maciekish/warthogathome/Checklists/A-10C_and_A-10C_II_Kneeboard_Suite_06-September-2022/A-10C_2/00_A-10C_KS_Day_04_TK.png

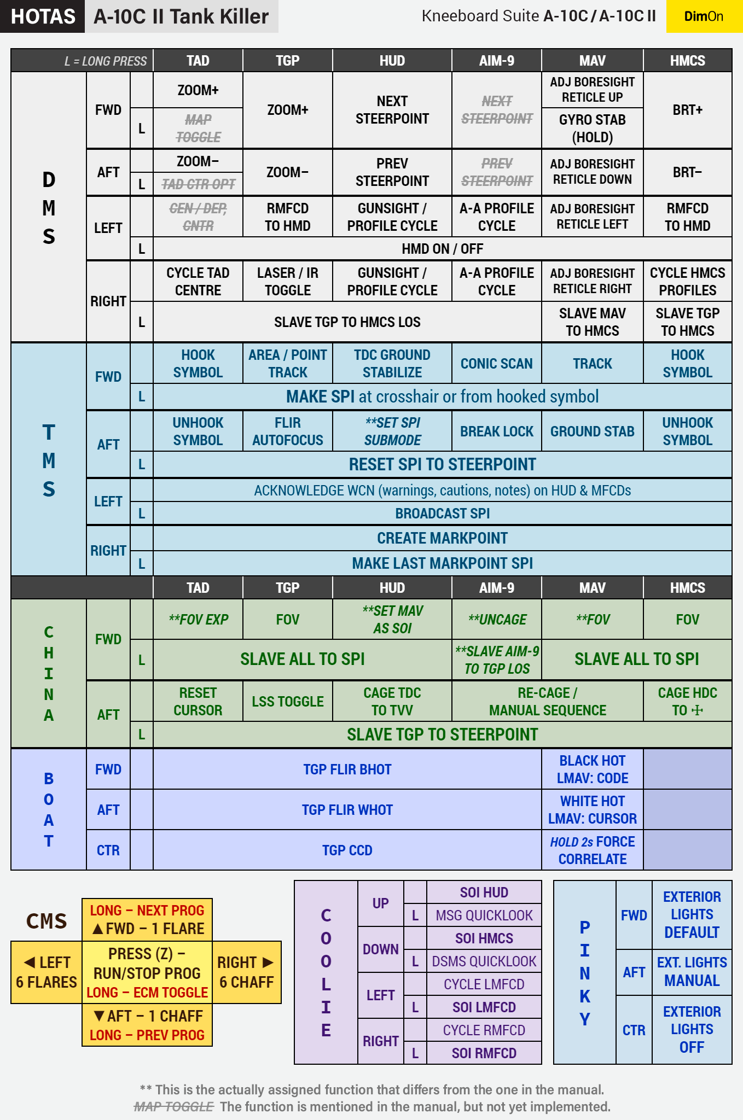
Checklists/A-10C_and_A-10C_II_Kneeboard_Suite_06-September-2022/A-10C_2/00_A-10C_KS_Day_04_TK.png
