maciekish/warthogathome/Panels/A-10C Cockpit Layout.jpeg

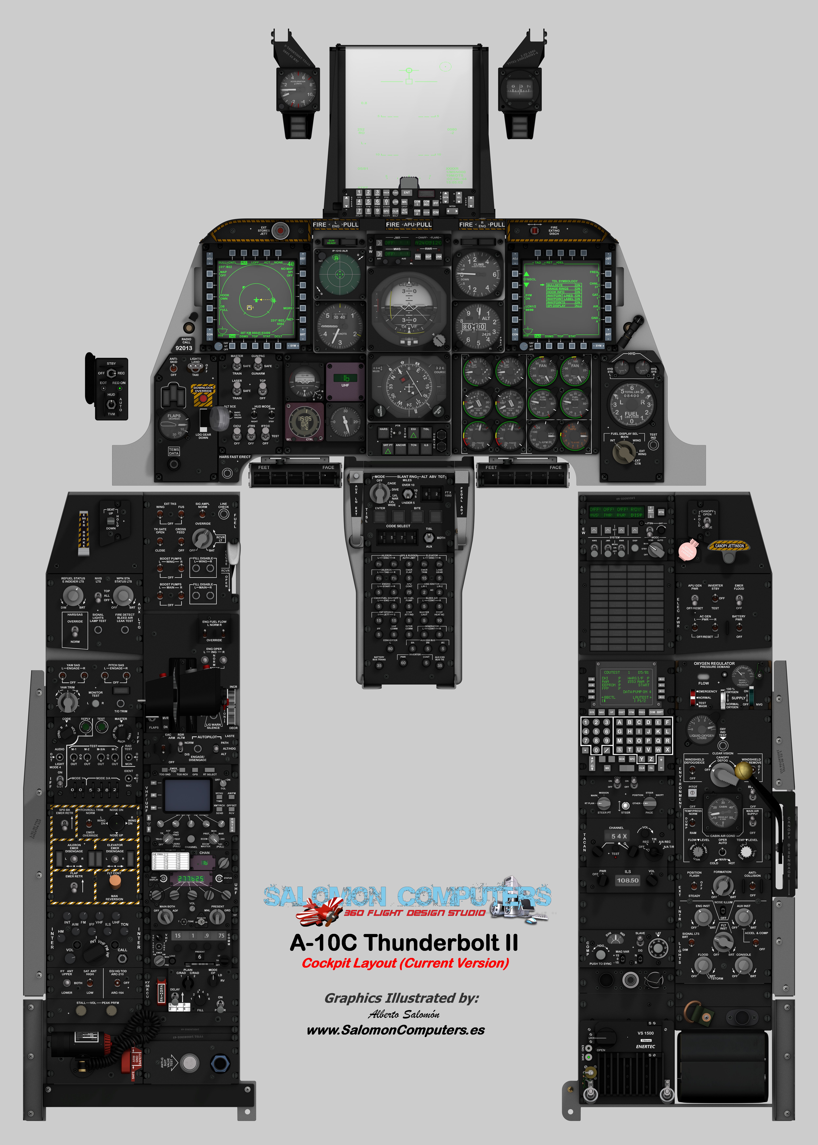
Panels/A-10C Cockpit Layout.jpeg
