maciekish/warthogathome/PCBs/Misc/Hub/production/bom.csv

Designator | Footprint | Quantity | Value | LCSC Part #
J2 | Molex Micro-Fit 3.0 43045-0800 | 1 | Conn_02x04_Top_Bottom | C122422
RJ1 | RJ45-TH_DS1130-S80BP | 1 | DS1130-S80BP | C86585
D1 | LED_0603_1608Metric | 1 | BLUE | C72041
R1 | R_0603_1608Metric | 1 | 4.7K | C23162
J1 | Molex Micro-Fit 3.0 43045-0800 | 1 | Conn_02x04_Top_Bottom | C122422
