maciekish/warthogathome/PCBs/Misc/External Connectors/production/bom.csv

Designator | Footprint | Quantity | Value | LCSC Part #
J4 | USB-A-TH_USB-302-T | 1 | USB_A | C86461
J3 | USB-B-TH_67068-8000 | 1 | USB_B | C114097
J1 | Molex Micro-Fit 3.0 43045-0800 | 1 | Conn_02x04_Top_Bottom | C234189
J2 | Molex Micro-Fit 3.0 43045-0800 | 1 | Conn_02x04_Top_Bottom | C234189
