maciekish/warthogathome/PCBs/Panels/Caution Panel/production/bom.csv

Designator | Footprint | Quantity | Value | LCSC Part #
D91 | LED_2010_5025Metric_Pad1.52x2.65mm_HandSolder | 1 | GREEN
D94 | LED_2010_5025Metric_Pad1.52x2.65mm_HandSolder | 1 | GREEN
D40 | LED_2010_5025Metric_Pad1.52x2.65mm_HandSolder | 1 | GREEN
D22 | LED_2010_5025Metric_Pad1.52x2.65mm_HandSolder | 1 | GREEN
D83 | LED_2010_5025Metric_Pad1.52x2.65mm_HandSolder | 1 | GREEN
D77 | LED_2010_5025Metric_Pad1.52x2.65mm_HandSolder | 1 | GREEN
R1 | R_1210_3225Metric_Pad1.30x2.65mm_HandSolder | 1 | 2K
H2 | MountingHole_2.2mm_M2_Pad | 1 | GND
D86 | LED_2010_5025Metric_Pad1.52x2.65mm_HandSolder | 1 | GREEN
D95 | LED_2010_5025Metric_Pad1.52x2.65mm_HandSolder | 1 | GREEN
D37 | LED_2010_5025Metric_Pad1.52x2.65mm_HandSolder | 1 | GREEN
D75 | LED_2010_5025Metric_Pad1.52x2.65mm_HandSolder | 1 | GREEN
D78 | LED_2010_5025Metric_Pad1.52x2.65mm_HandSolder | 1 | GREEN
D12 | LED_2010_5025Metric_Pad1.52x2.65mm_HandSolder | 1 | GREEN
D65 | LED_2010_5025Metric_Pad1.52x2.65mm_HandSolder | 1 | GREEN
D67 | LED_2010_5025Metric_Pad1.52x2.65mm_HandSolder | 1 | GREEN
D68 | LED_2010_5025Metric_Pad1.52x2.65mm_HandSolder | 1 | GREEN
D6 | LED_2010_5025Metric_Pad1.52x2.65mm_HandSolder | 1 | GREEN
D72 | LED_2010_5025Metric_Pad1.52x2.65mm_HandSolder | 1 | GREEN
D17 | LED_2010_5025Metric_Pad1.52x2.65mm_HandSolder | 1 | GREEN
D23 | LED_2010_5025Metric_Pad1.52x2.65mm_HandSolder | 1 | GREEN
D51 | LED_2010_5025Metric_Pad1.52x2.65mm_HandSolder | 1 | GREEN
D89 | LED_2010_5025Metric_Pad1.52x2.65mm_HandSolder | 1 | GREEN
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
D60 | LED_2010_5025Metric_Pad1.52x2.65mm_HandSolder | 1 | GREEN
D64 | LED_2010_5025Metric_Pad1.52x2.65mm_HandSolder | 1 | GREEN
D28 | LED_2010_5025Metric_Pad1.52x2.65mm_HandSolder | 1 | GREEN
D87 | LED_2010_5025Metric_Pad1.52x2.65mm_HandSolder | 1 | GREEN
D39 | LED_2010_5025Metric_Pad1.52x2.65mm_HandSolder | 1 | GREEN
D88 | LED_2010_5025Metric_Pad1.52x2.65mm_HandSolder | 1 | GREEN
D33 | LED_2010_5025Metric_Pad1.52x2.65mm_HandSolder | 1 | GREEN
D96 | LED_2010_5025Metric_Pad1.52x2.65mm_HandSolder | 1 | GREEN
D85 | LED_2010_5025Metric_Pad1.52x2.65mm_HandSolder | 1 | GREEN
D82 | LED_2010_5025Metric_Pad1.52x2.65mm_HandSolder | 1 | GREEN
D93 | LED_2010_5025Metric_Pad1.52x2.65mm_HandSolder | 1 | GREEN
D53 | LED_2010_5025Metric_Pad1.52x2.65mm_HandSolder | 1 | GREEN
D52 | LED_2010_5025Metric_Pad1.52x2.65mm_HandSolder | 1 | GREEN
D66 | LED_2010_5025Metric_Pad1.52x2.65mm_HandSolder | 1 | GREEN
U2 | DIP-28_W7.62mm | 1 | TLC5940NT
U1 | DIP-28_W7.62mm | 1 | TLC5940NT
U3 | DIP-28_W7.62mm | 1 | TLC5940NT
C3 | C_0805_2012Metric_Pad1.18x1.45mm_HandSolder | 1 | 100N
J1 | PinHeader_1x06_P2.54mm_Vertical | 1 | Conn_01x06_Male
C1 | C_0805_2012Metric_Pad1.18x1.45mm_HandSolder | 1 | 100N
C2 | C_0805_2012Metric_Pad1.18x1.45mm_HandSolder | 1 | 100N
