maciekish/warthogathome/KiCad Libraries/3D/Cap MLCC FA14X7R1H225KRU06.stp

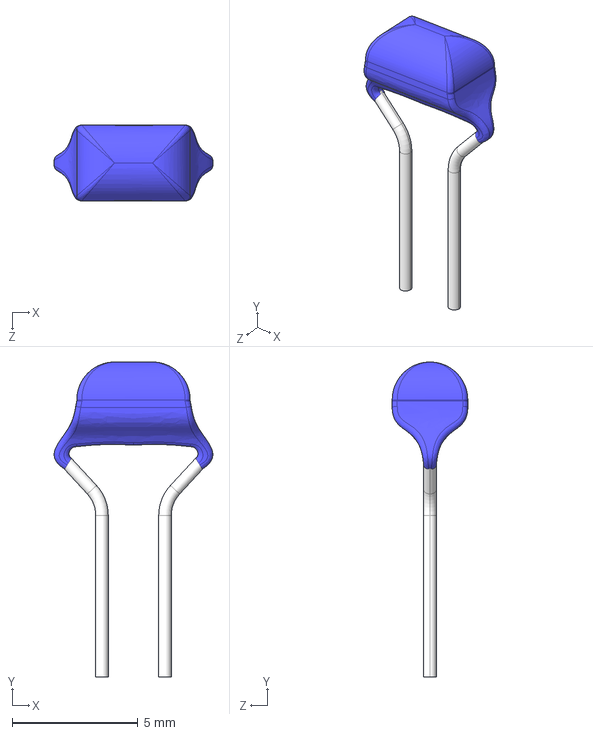
[picture p20: CAD file, 2022-08-09]
KiCad Libraries/3D/Cap MLCC FA14X7R1H225KRU06.stp
6.30 x 12.5 x 3.00 mm
