maciekish/warthogathome/KiCad Libraries/B6B-XH-A-LF--SN---3DModel-STEP-418109.STEP

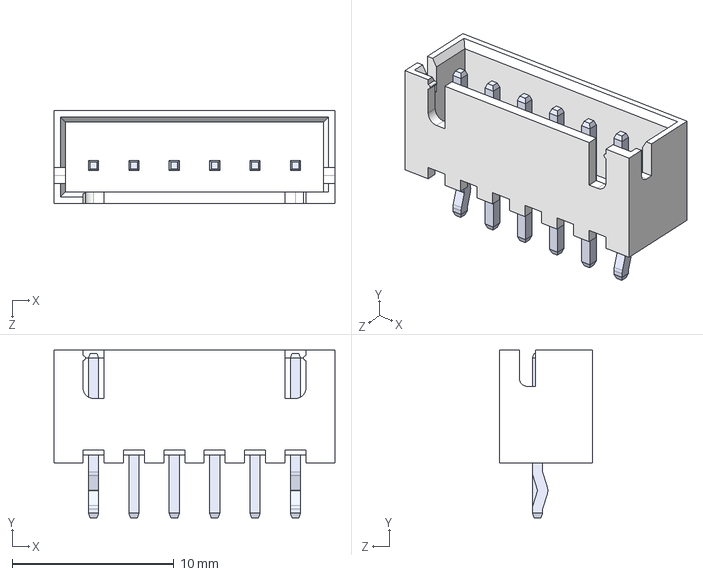
[picture p21: CAD file, 2022-08-08]
KiCad Libraries/B6B-XH-A-LF--SN---3DModel-STEP-418109.STEP
17.4 x 10.4 x 5.75 mm
