maciekish/warthogathome/Panels/Modified for LED Strip/Right Console/ELEC PWR.dxf

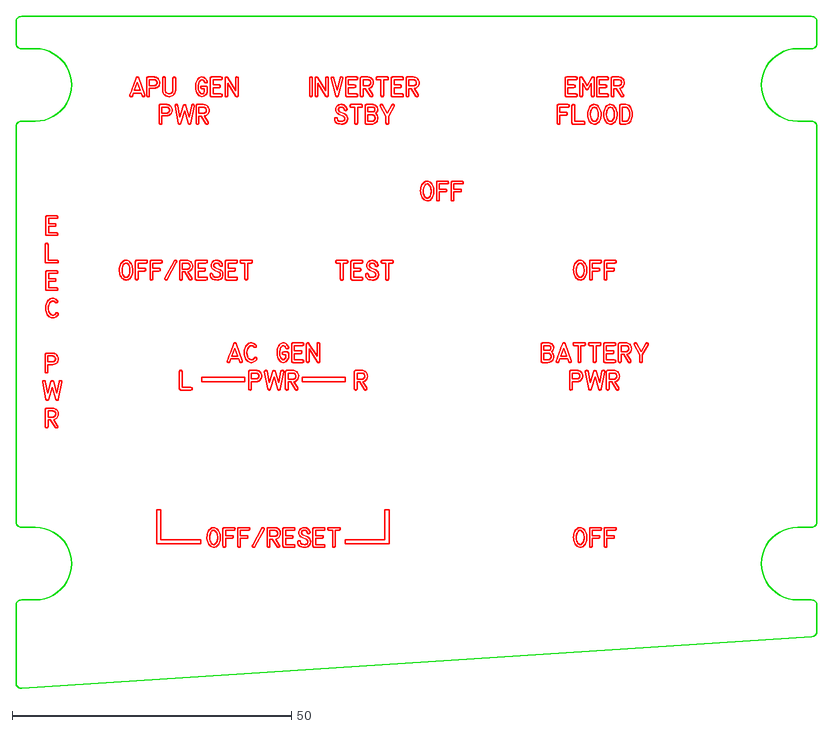
[picture p22: CAD file, 2022-08-17]
Panels/Modified for LED Strip/Right Console/ELEC PWR.dxf
143.5 x 120.4
