maciekish/warthogathome/KiCad Libraries/3D/BK-6013.step

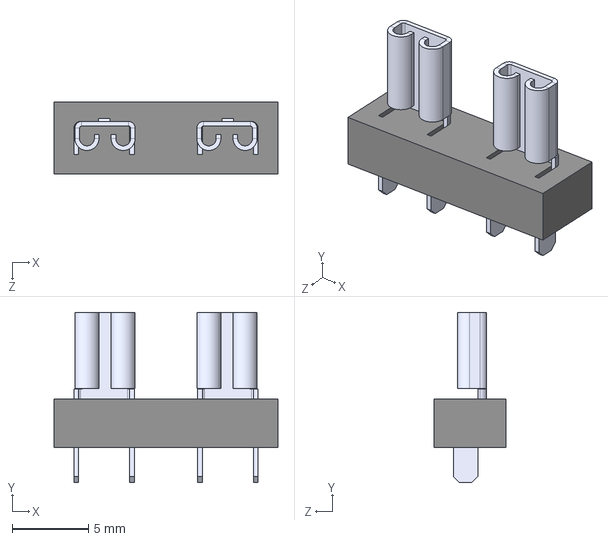
[picture p23: CAD file, 2022-08-09]
KiCad Libraries/3D/BK-6013.step
14.7 x 11.2 x 4.75 mm
