maciekish/warthogathome/KiCad Libraries/3D/L7805CV.stp

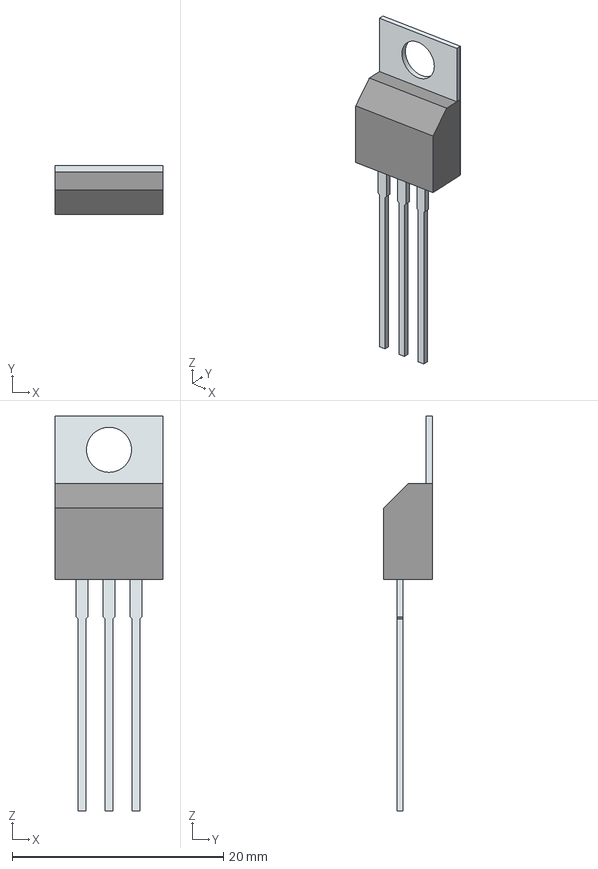
[picture p24: CAD file, 2022-08-08]
KiCad Libraries/3D/L7805CV.stp
10.2 x 4.60 x 37.4 mm
Tab
PinsArray
