maciekish/warthogathome/KiCad Libraries/3D/B6B-XH-A_LF__SN_.stp

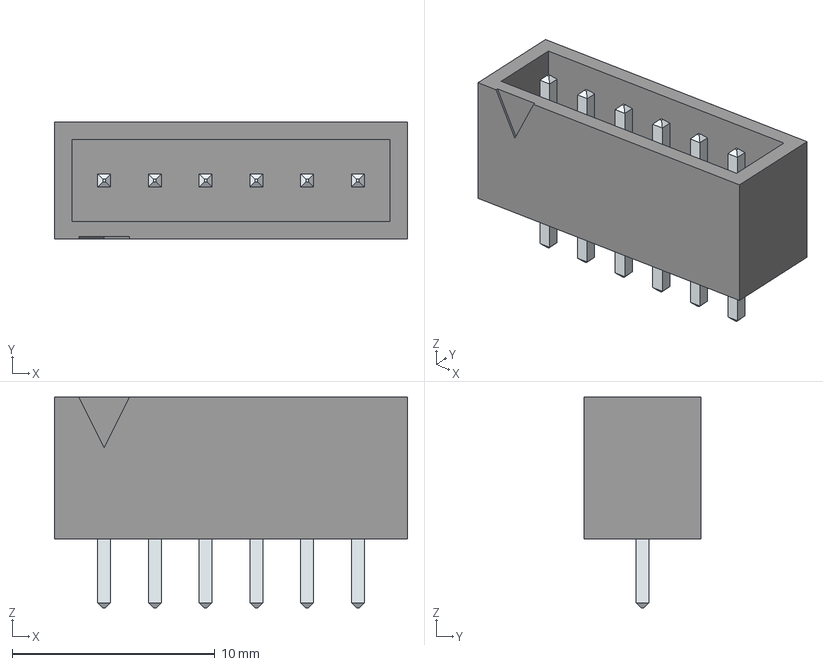
[picture p25: CAD file, 2022-08-08]
KiCad Libraries/3D/B6B-XH-A_LF__SN_.stp
17.4 x 5.75 x 10.4 mm
LeadsArray
