maciekish/warthogathome/KiCad Libraries/3D/B2B-XH-2__LF__SN_.stp

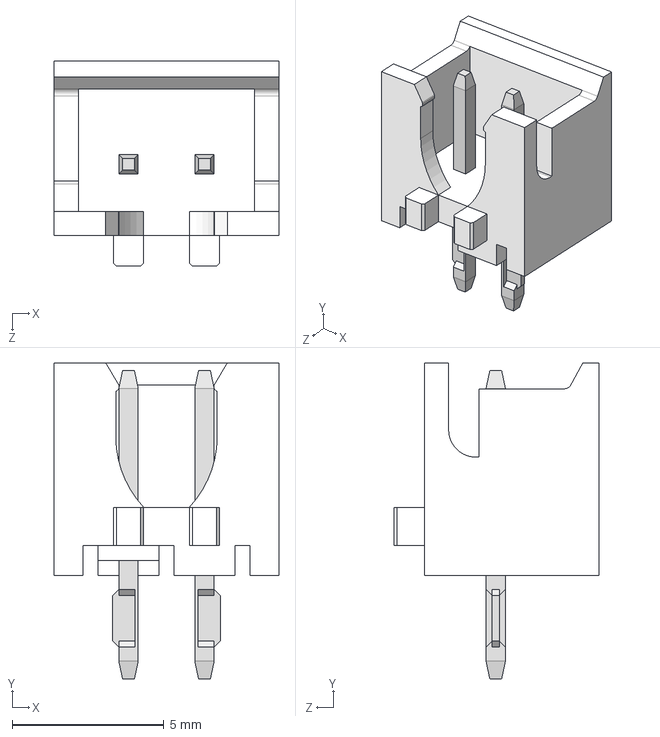
[picture p26: CAD file, 2022-08-08]
KiCad Libraries/3D/B2B-XH-2__LF__SN_.stp
7.40 x 10.4 x 6.75 mm
