maciekish/warthogathome/KiCad Libraries/3D/B7B-XH-A_LF__SN_.stp

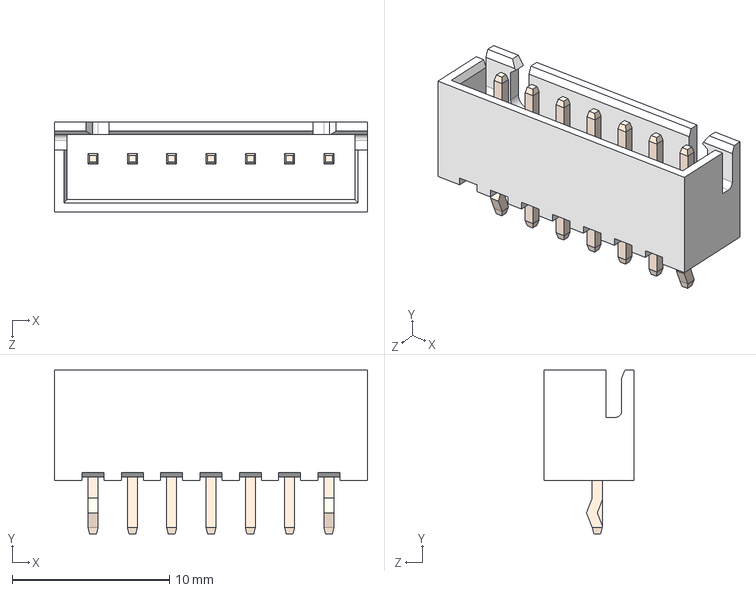
[picture p27: CAD file, 2022-08-08]
KiCad Libraries/3D/B7B-XH-A_LF__SN_.stp
19.9 x 10.4 x 5.75 mm
