maciekish/warthogathome/KiCad Libraries/3D/MAX487CPA+.stp

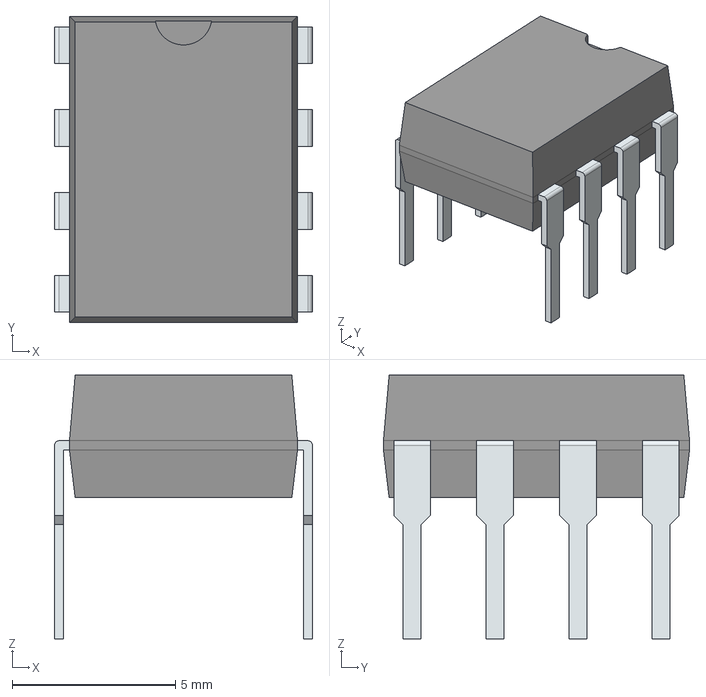
[picture p28: CAD file, 2022-08-08]
KiCad Libraries/3D/MAX487CPA+.stp
7.90 x 9.38 x 8.07 mm
PinsArrayLR
