maciekish/warthogathome/KiCad Libraries/3D/43045-0800.stp

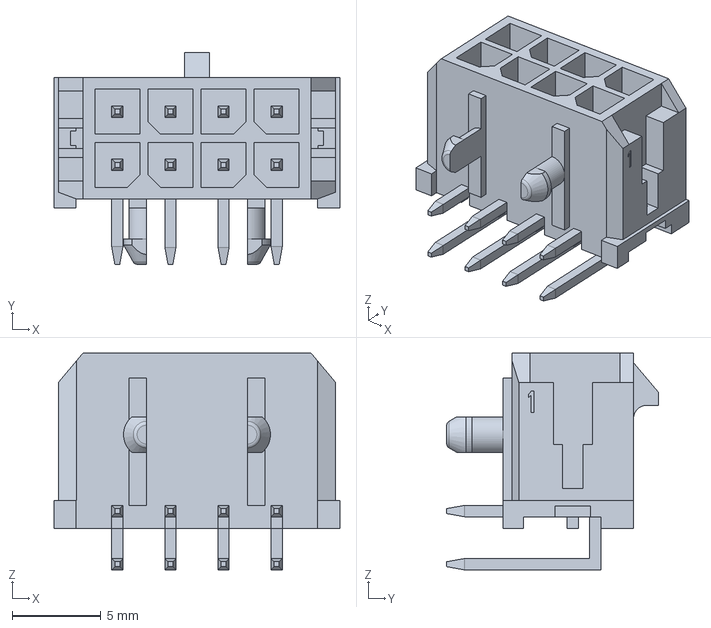
[picture p29: CAD file, 2022-08-08]
KiCad Libraries/3D/43045-0800.stp
16.1 x 11.9 x 12.2 mm
