maciekish/warthogathome/KiCad Libraries/3D/43045-0400.stp

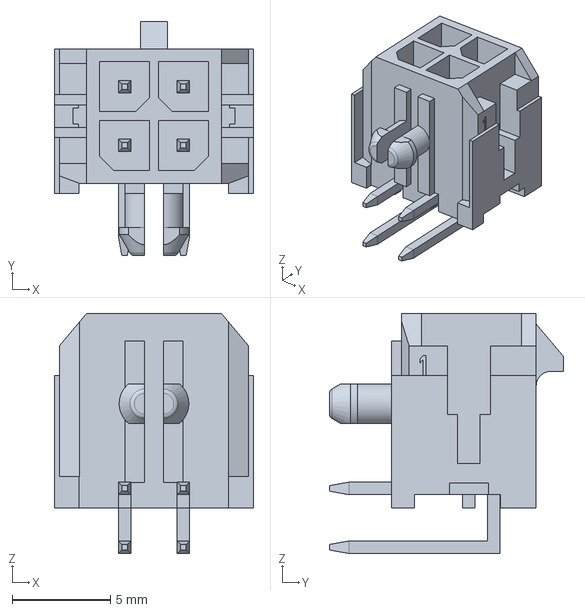
[picture p30: CAD file, 2022-08-08]
KiCad Libraries/3D/43045-0400.stp
10.2 x 11.9 x 12.2 mm
