maciekish/warthogathome/KiCad Libraries/3D/43045-0200.stp

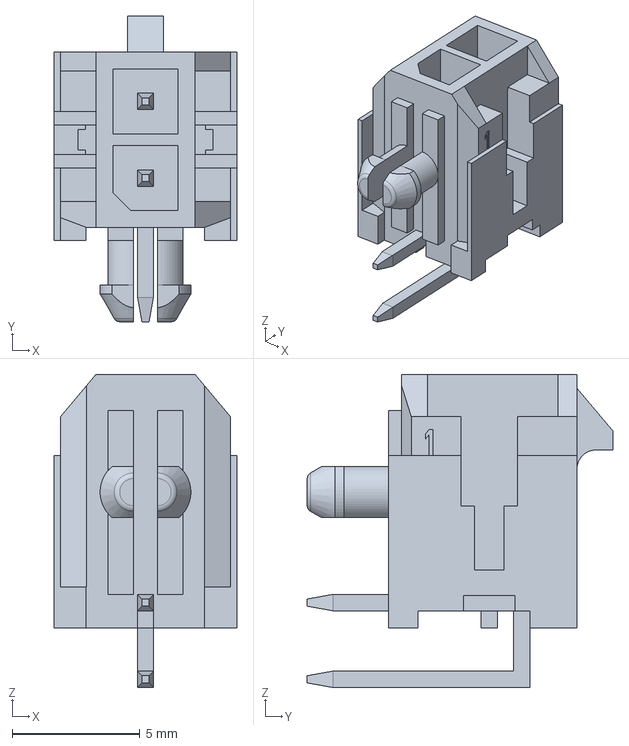
[picture p31: CAD file, 2022-08-08]
KiCad Libraries/3D/43045-0200.stp
7.15 x 11.9 x 12.2 mm
