maciekish/warthogathome/(list of files, cad)

Other CAD files:
Models/Consoles/ATX PSU Frame.FCStd
KiCad Libraries/3D/TIP120.stp
KiCad Libraries/3D/B6B-XH-A_LF__SN_.stl
KiCad Libraries/3D/L7805CV.stl
KiCad Libraries/3D/TIP120.stl
