maciekish/warthogathome/Panels/Panelized/2022-09-22/2022-09-22 - 2.8mm White.pdf

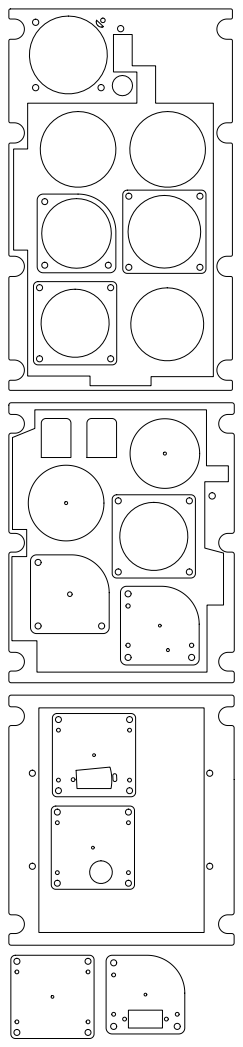
[picture p32: page 1]
