maciekish/warthogathome/Panels/Panelized/2022-09-22/2022-09-22 - 2mm Clear.pdf

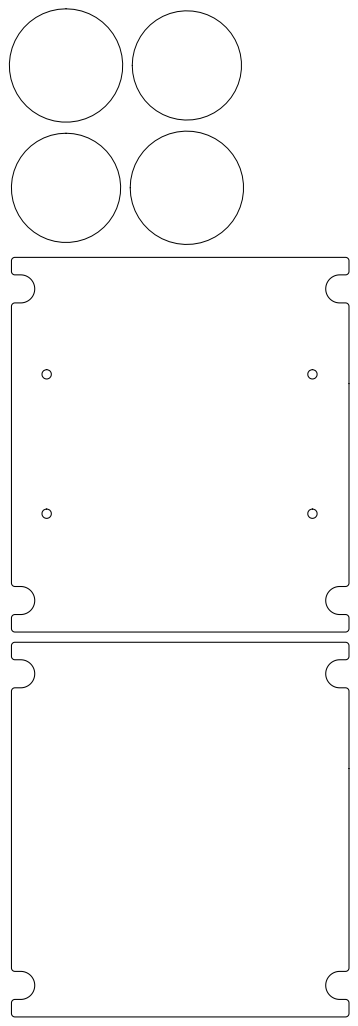
[picture p33: page 1]
