maciekish/warthogathome/Panels/Panelized/2022-09-22/2022-09-22 - 2.8mm Black.pdf

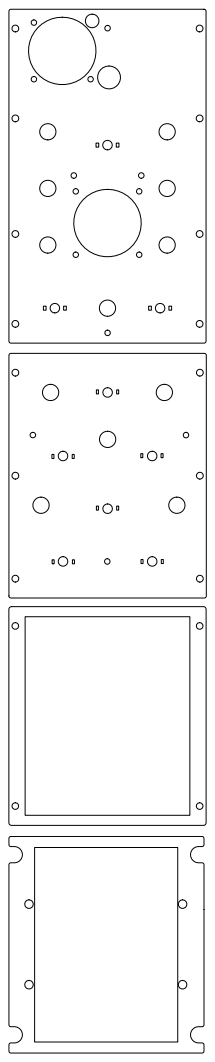
[picture p34: page 1]
