maciekish/warthogathome/Panels/Panelized/2022-09-22/2022-09-22 - 2mm White.pdf

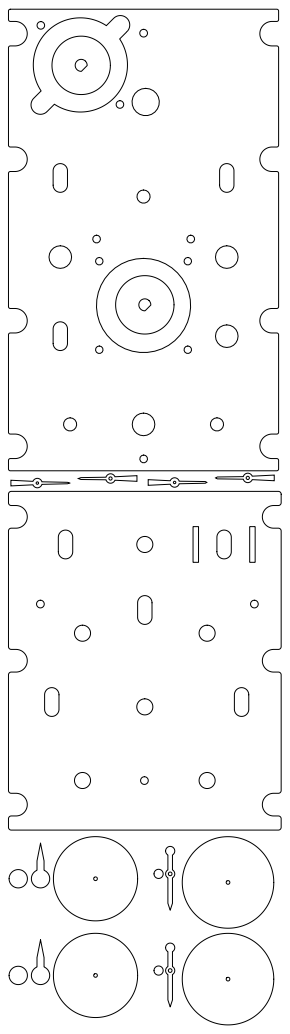
[picture p35: page 1]
