maciekish/warthogathome/Panels/Converted/PDF/AnyConv.com__Environment.pdf

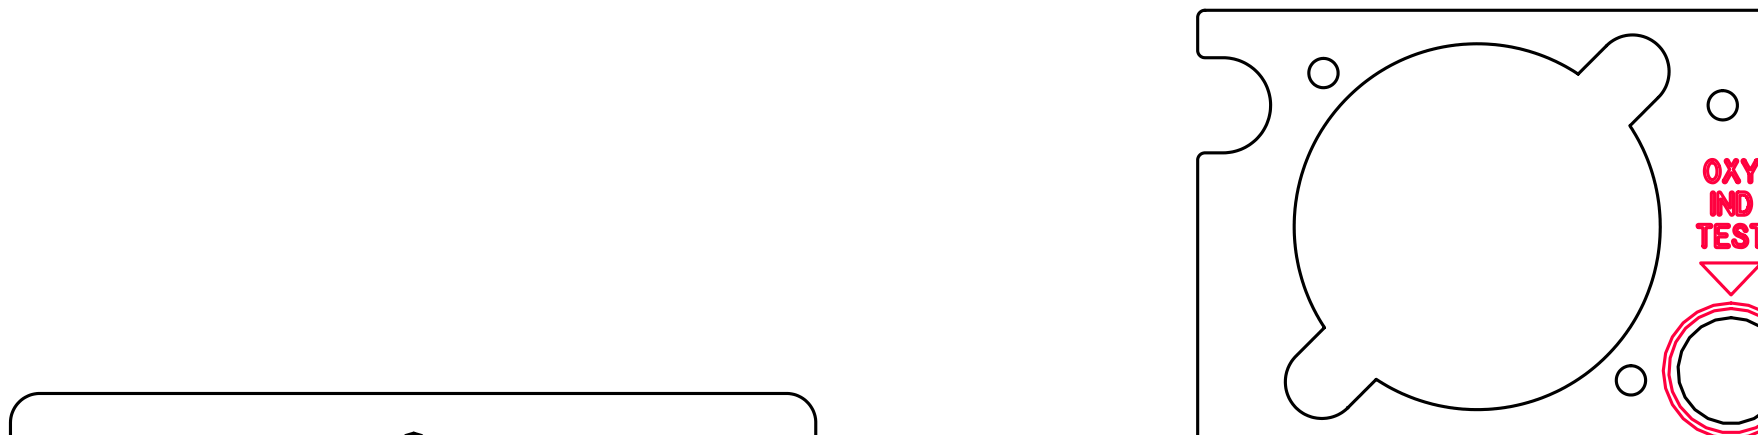
[picture p36: page 1]
