maciekish/warthogathome/Panels/Converted/PDF/AnyConv.com__Lighting Panel.pdf

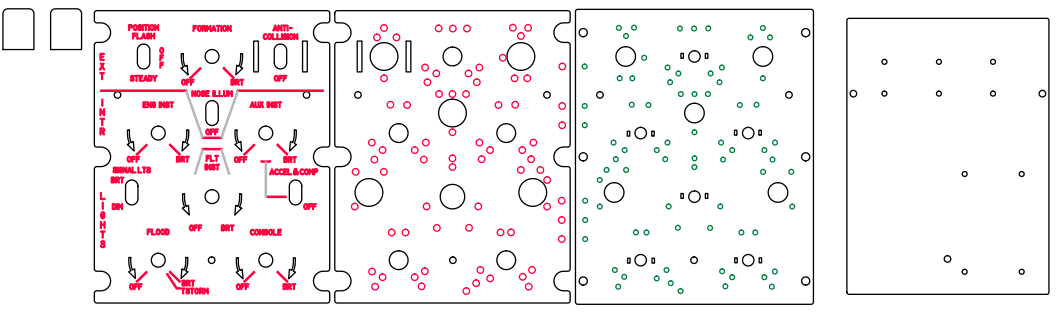
[picture p37: page 1]
