maciekish/warthogathome/Panels/Modified for LED Strip/Right Console/Canopy Panel Lower.pdf

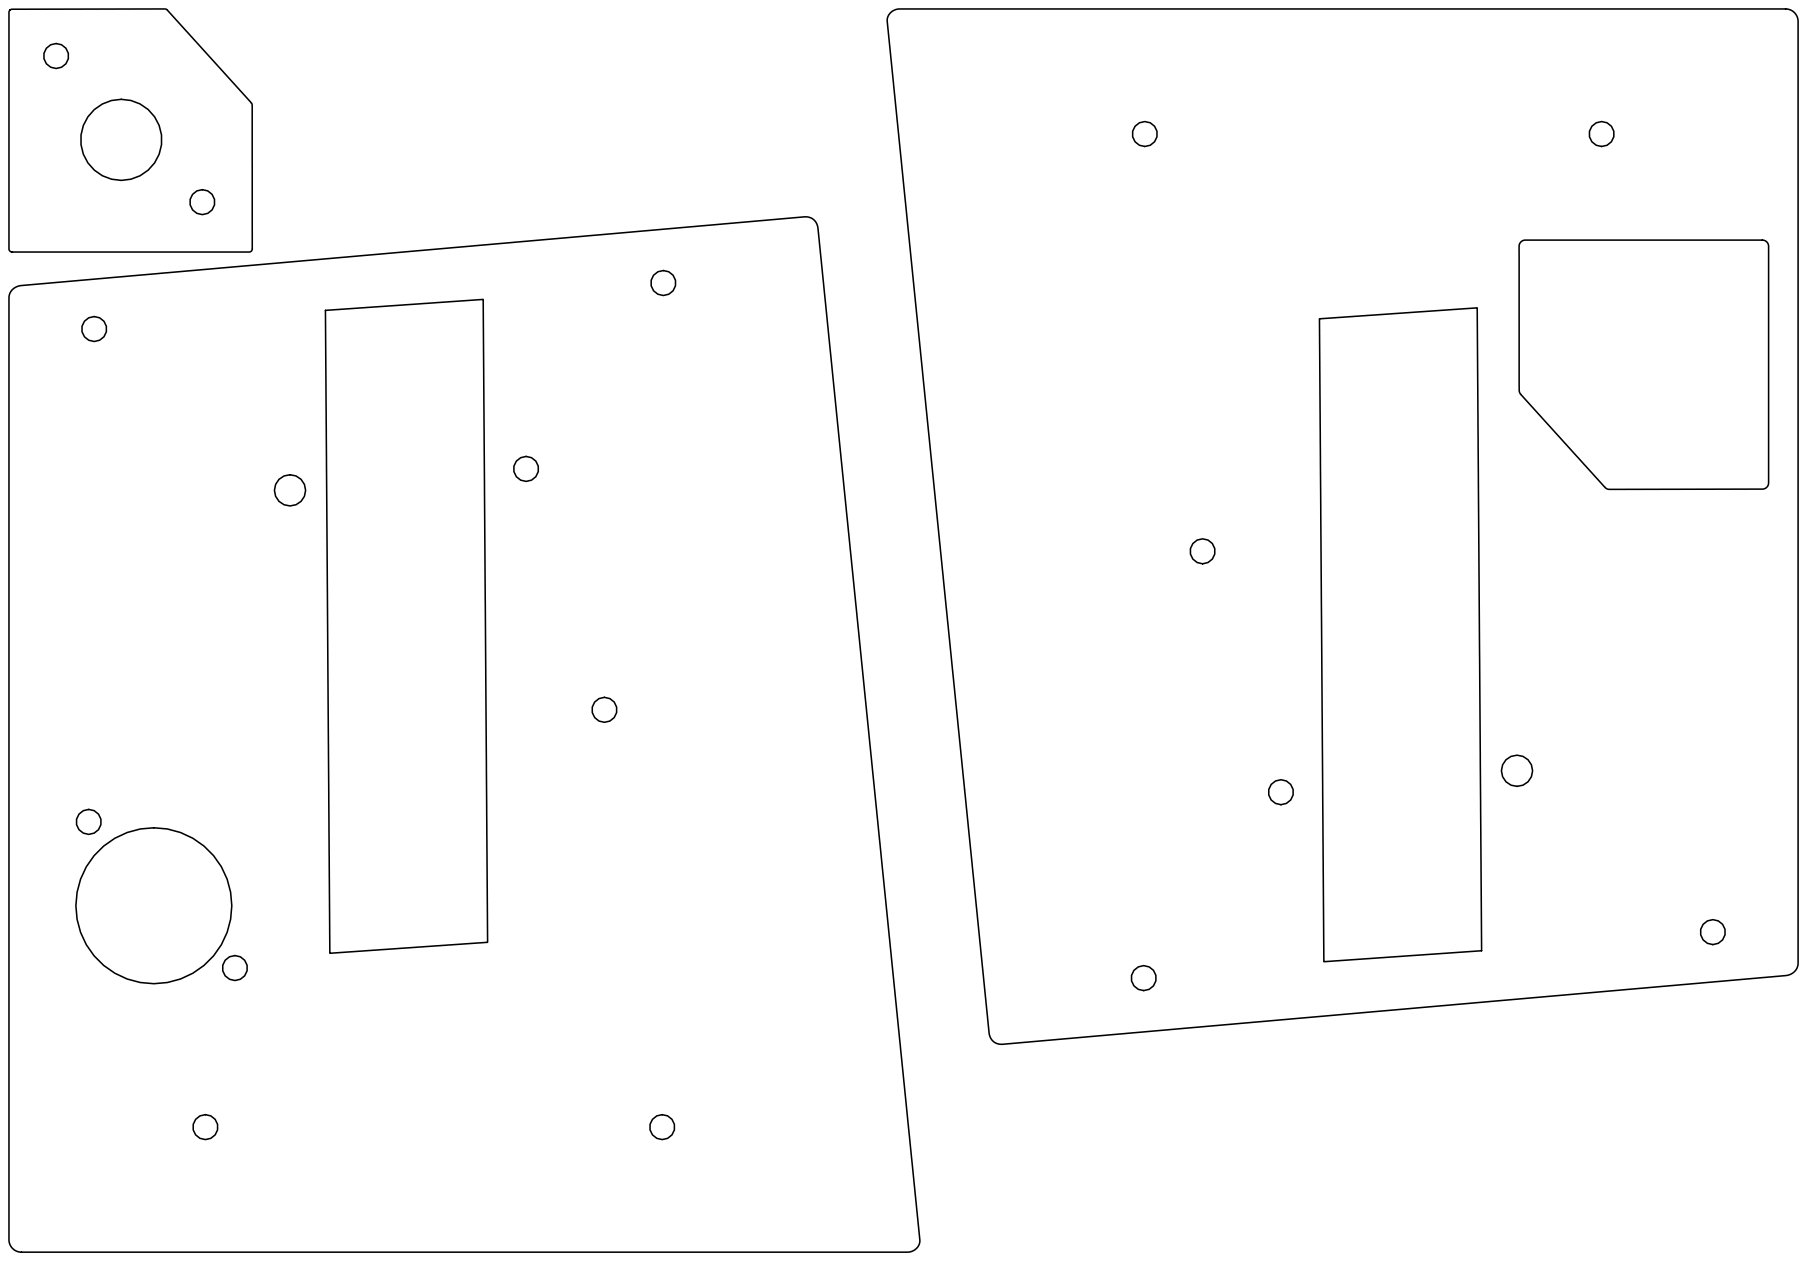
[picture p38: page 1]
