maciekish/warthogathome/Panels/Modified for LED Strip/Right Console/Canopy Panel.pdf

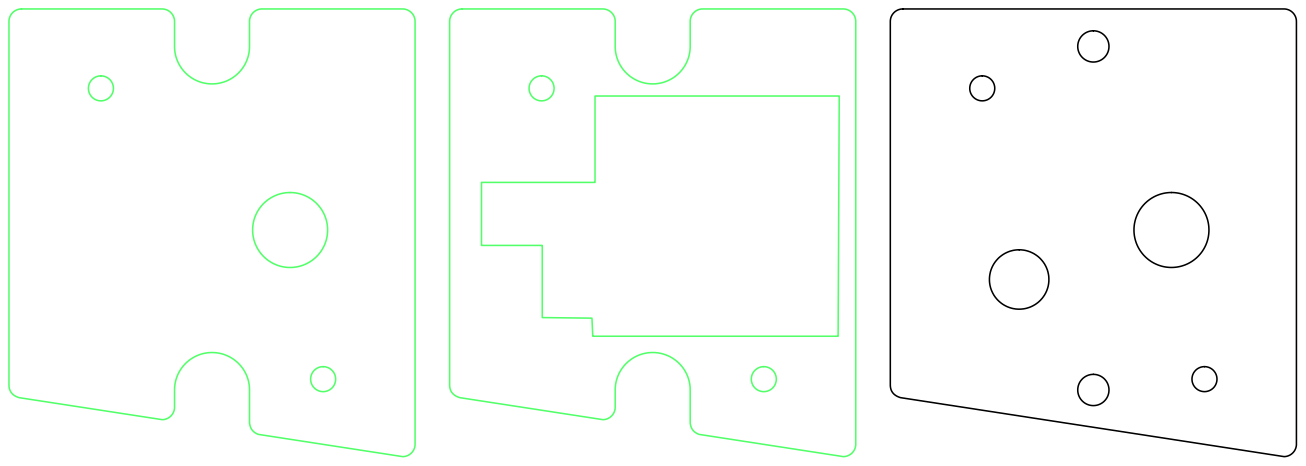
[picture p39: page 1]
