maciekish/warthogathome/Panels/Modified for LED Strip/Right Console/ELEC PWR.pdf

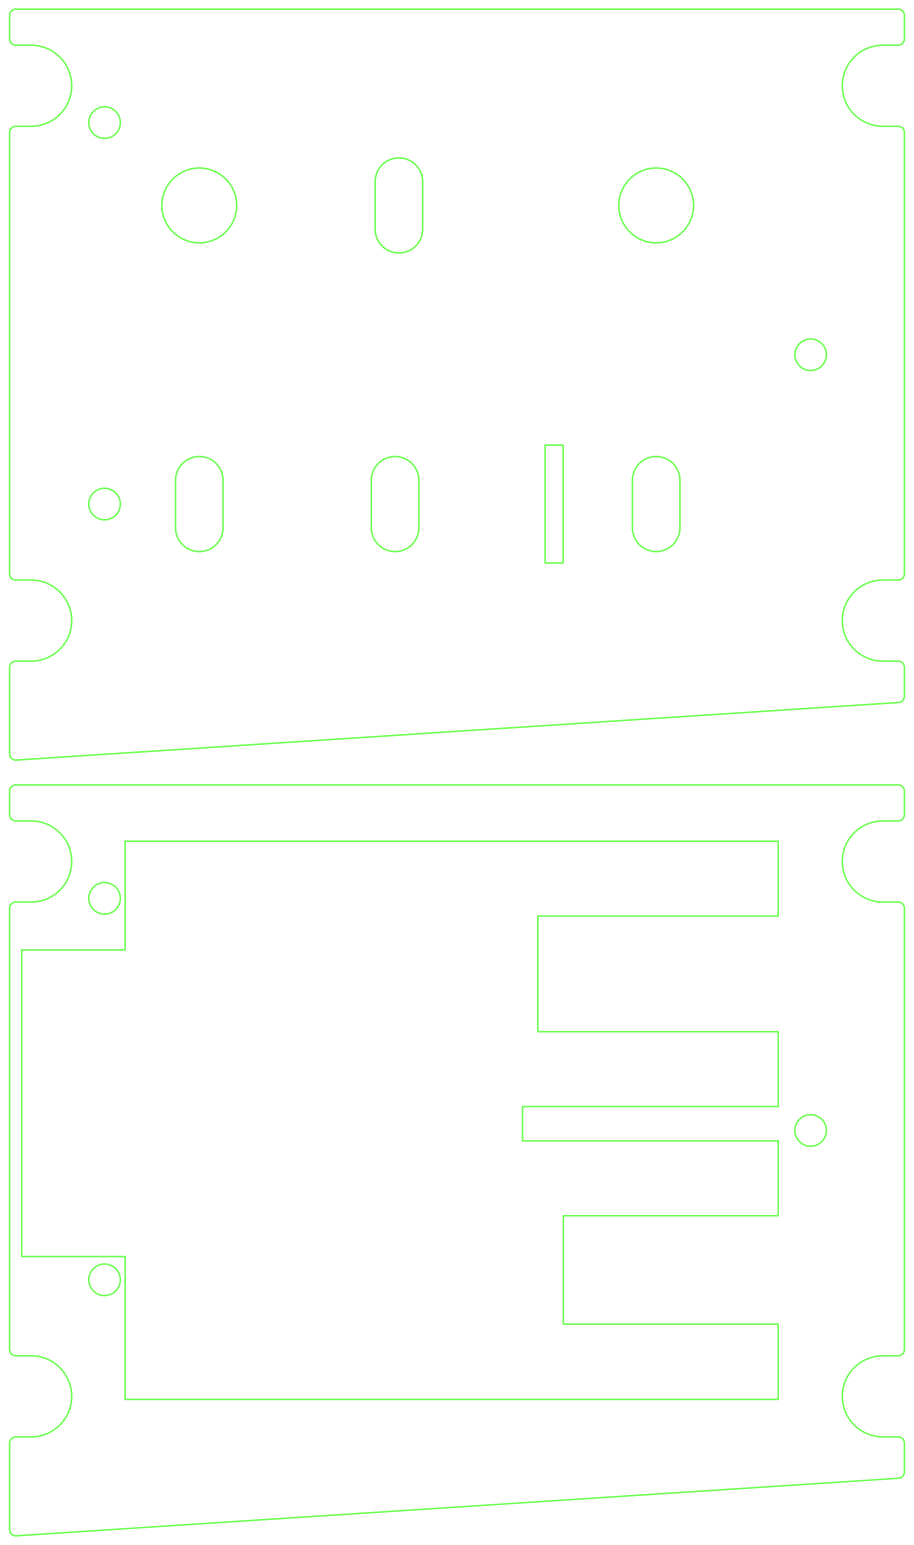
[picture p40: page 1]

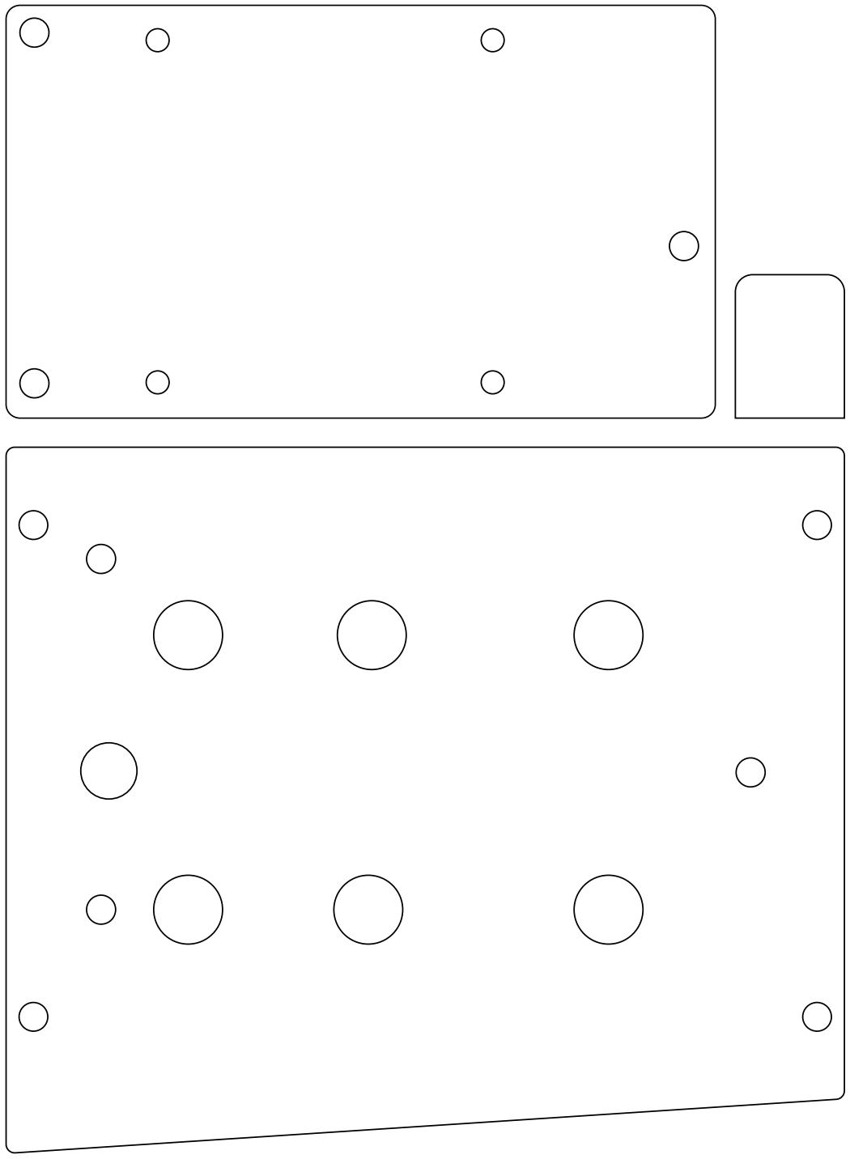
[picture p41: figure]
