maciekish/warthogathome/Panels/Modified for LED Strip/Right Console/Oxygen Regulator.pdf

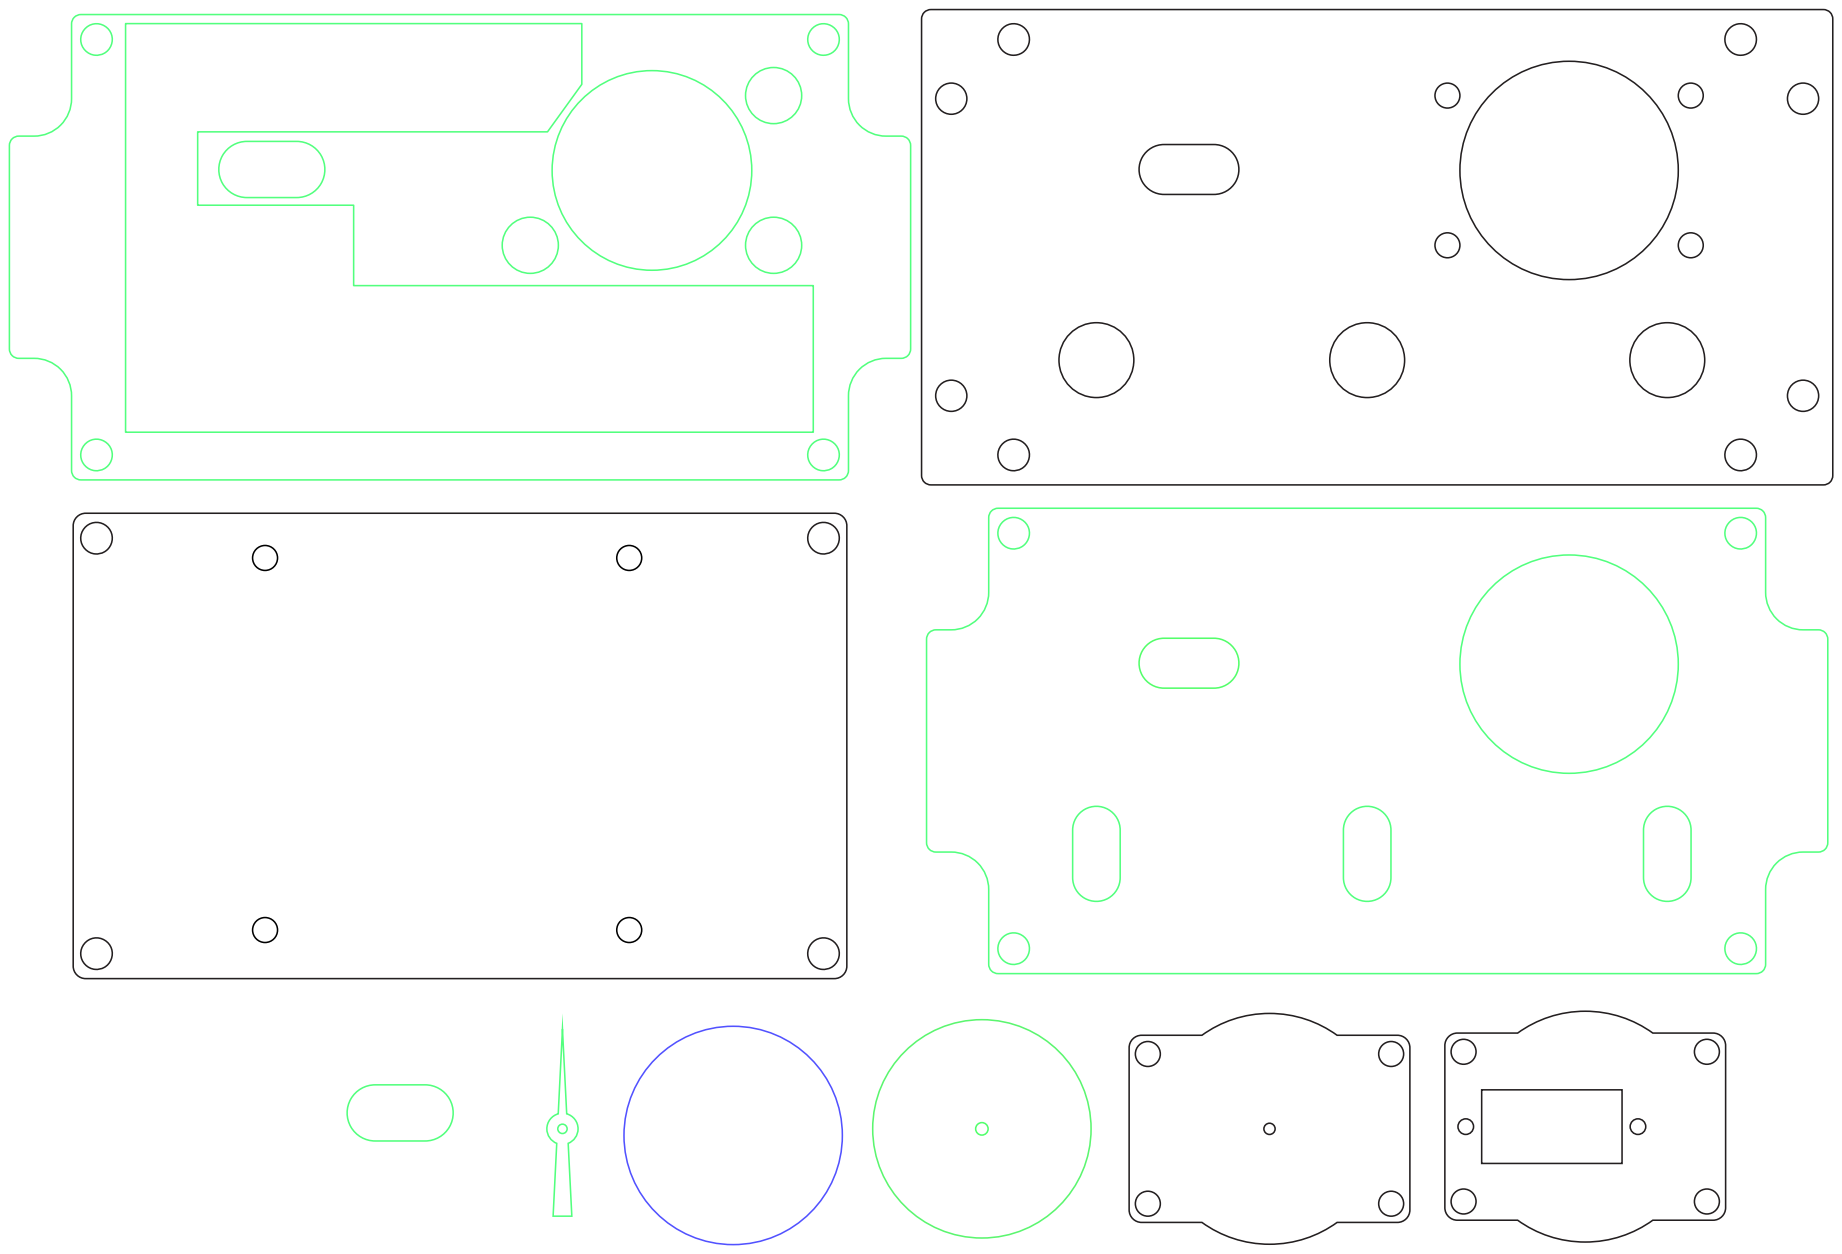
[picture p42: page 1]
