maciekish/warthogathome/PCBs/Misc/Hub/Hub.kicad_pcb

## KiCad design PCBs/Misc/Hub/Hub.kicad_pcb (2023-01-11)

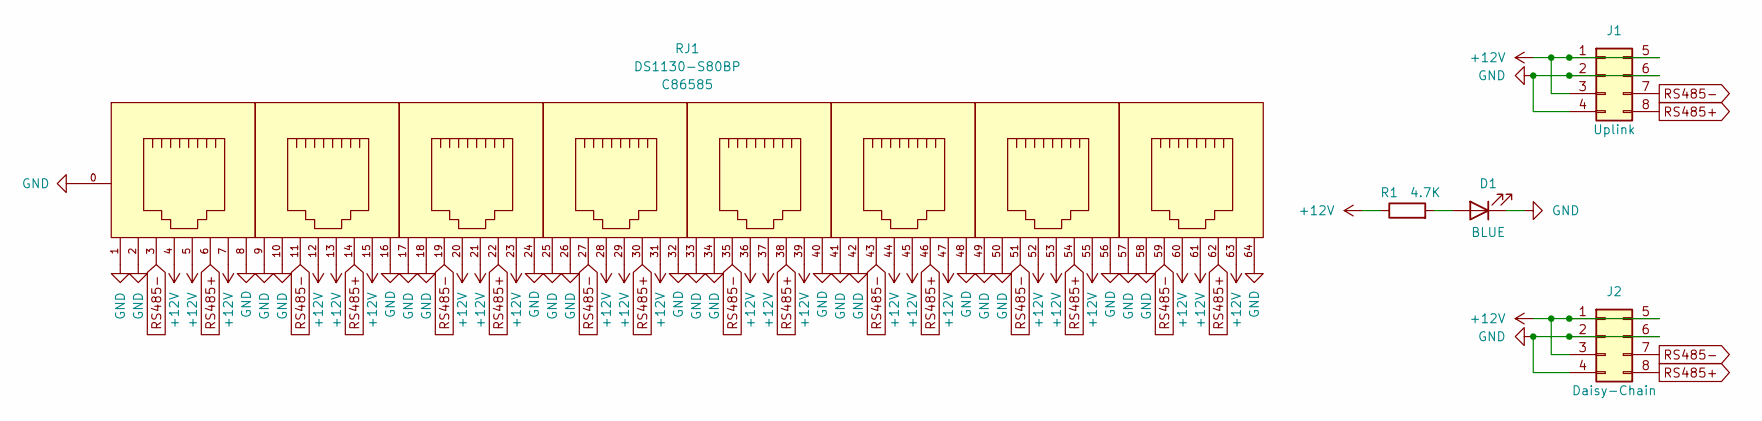
[picture p43: schematic Hub.kicad_sch]

Parts:
D1: BLUE; LED_0603_1608Metric; LCSC C72041
J1, J2: Conn_02x04_Top_Bottom; Molex Micro-Fit 3.0 43045-0800; LCSC C122422
R1: 4.7K; R_0603_1608Metric; LCSC C23162
RJ1: DS1130-S80BP; RJ45-TH_DS1130-S80BP; LCSC C86585

Connections:
+12V: J1.1, J1.3, J1.5, J2.1, J2.3, J2.5, R1.1, RJ1.4, RJ1.5, RJ1.7, RJ1.12, RJ1.13, RJ1.15, RJ1.20, RJ1.21, RJ1.23, RJ1.28, RJ1.29, RJ1.31, RJ1.36, RJ1.37, RJ1.39, RJ1.44, RJ1.45, RJ1.47, RJ1.52, RJ1.53, RJ1.55, RJ1.60, RJ1.61, RJ1.63
GND: D1.1 (K), J1.2, J1.4, J1.6, J2.2, J2.4, J2.6, RJ1.0, RJ1.1, RJ1.2, RJ1.8, RJ1.9, RJ1.10, RJ1.16, RJ1.17, RJ1.18, RJ1.24, RJ1.25, RJ1.26, RJ1.32, RJ1.33, RJ1.34, RJ1.40, RJ1.41, RJ1.42, RJ1.48, RJ1.49, RJ1.50, RJ1.56, RJ1.57, RJ1.58, RJ1.64
unnamed: D1.2 (A), R1.2
RS485+: J1.8, J2.8, RJ1.6, RJ1.14, RJ1.22, RJ1.30, RJ1.38, RJ1.46, RJ1.54, RJ1.62
RS485-: J1.7, J2.7, RJ1.3, RJ1.11, RJ1.19, RJ1.27, RJ1.35, RJ1.43, RJ1.51, RJ1.59

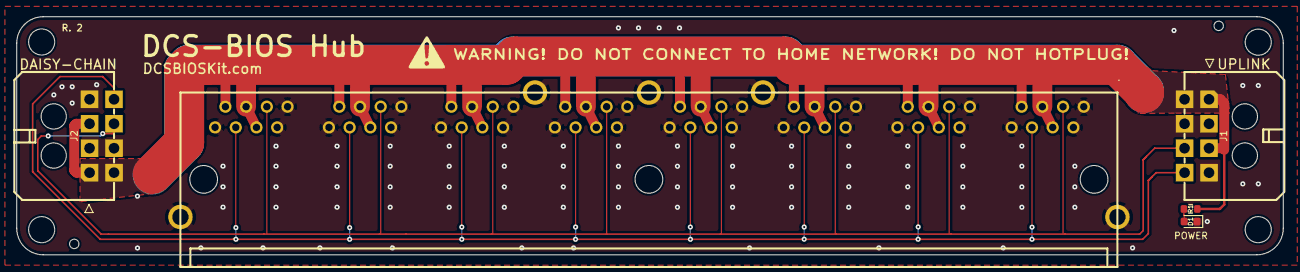
[picture p44: board Hub.kicad_pcb from above]

Board: 2 copper layers, 155.4 x 29.2 mm, 9 parts (0 on the bottom side), 5 nets.

Other parts of the board:
HOLE-3, HOLE-3#2, HOLE-4, HOLE-4#2: MountingHole_3.2mm_M3
