maciekish/warthogathome/PCBs/Master/Standalone/Master.kicad_pcb

## KiCad design PCBs/Master/Standalone/Master.kicad_pcb (2023-01-11)

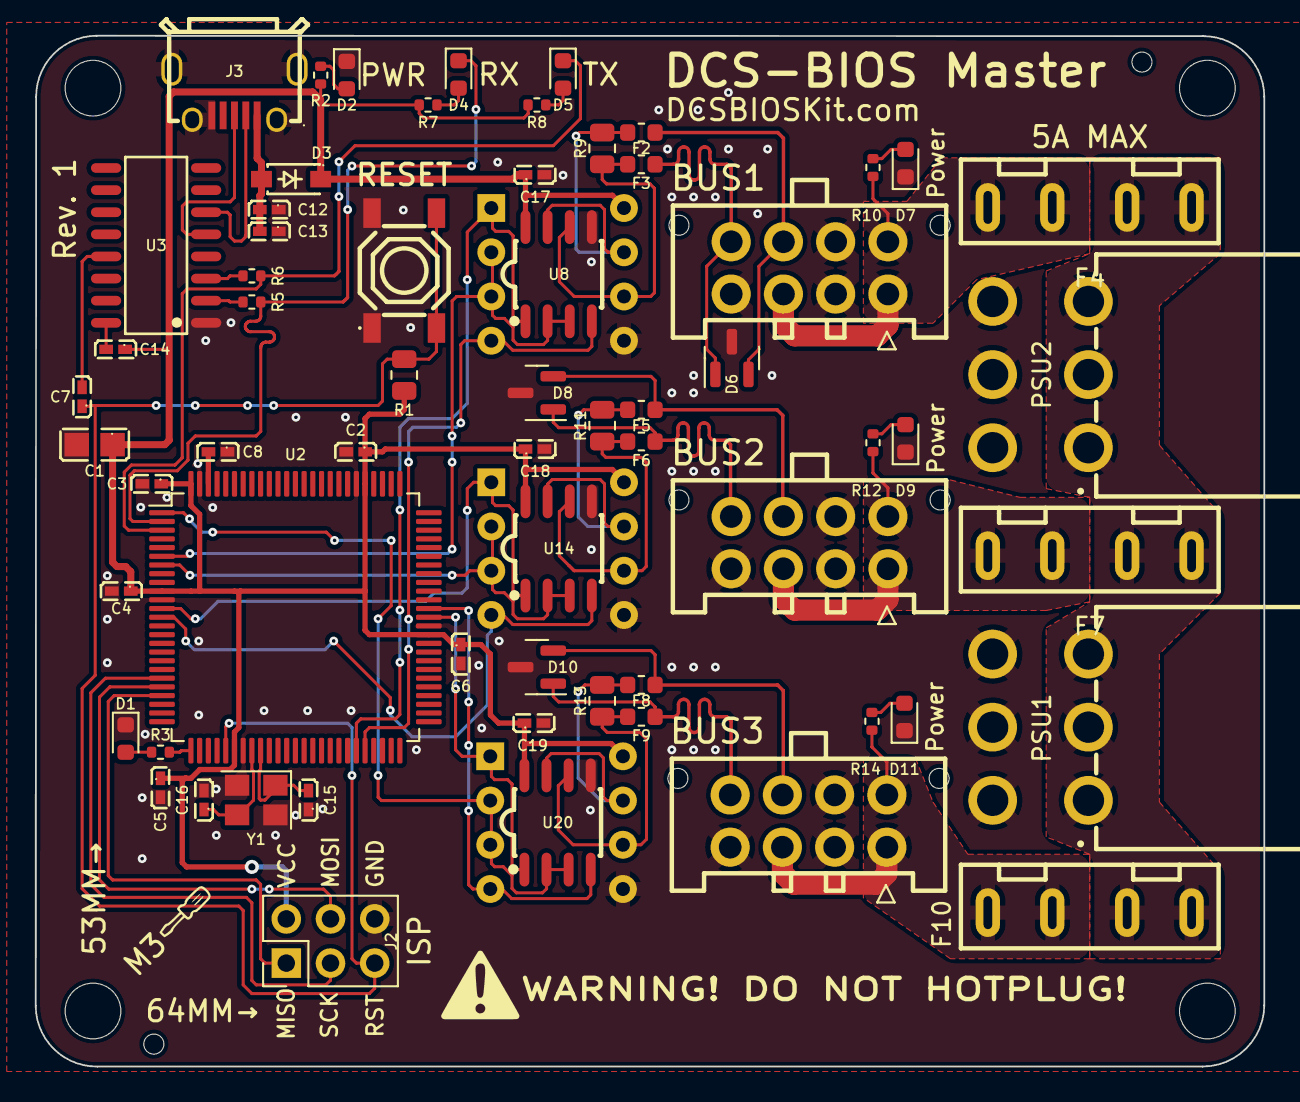
[picture p47: board Master.kicad_pcb from above]

Board: 2 copper layers, 70.6 x 59.2 mm, 71 parts (1 on the bottom side), 51 nets.

Parts:
BUS1, BUS2, BUS3: Conn_02x04_Top_Bottom; Molex Micro-Fit 3.0 43045-0812
C1: 4.7uF; C0805
C2, C3, C4, C5, C6, C14, C17, C18, C19: 1uF; C0402
C7, C8, C12: 100nF; C0402
C13: 10uF; C0402
C15, C16: 15pF; C0402
D1, D2, D4, D5: LED; LED_0603_1608Metric
D3: DIODE; SOD-123_L2.7-W1.6-LS3.7-RD-1
D6, D8, D10: SM712_SOT23; SOT-23
D7, D9, D11: BLUE; LED_0603_1608Metric
F2, F3, F5, F6, F8, F9: 100mA; Fuse_0603_1608Metric
F4, F7, F10: 5A; FUSE-TH_XF-506P
Ge: LOGO
H1, H2, H3, H4: MountingHole; MountingHole_3.2mm_M3
J2: AVR-ISP-6; PinHeader_2x03_P2.54mm_Vertical
J3: USB_B_Micro; MICRO-USB-SMD_U254-051T-4BHJ25-F2S
PSU1, PSU2: Conn_02x03_Odd_Even; CONN-TH_HAA420A-6AW-C2845788
R1: 10K; R_0805_2012Metric
R2, R3, R5, R6, R7, R8: 1K; R_0402_1005Metric
R9, R11, R13: 120R; R_0805_2012Metric
R10, R12, R14: 3.3K; R_0402_1005Metric
SW1: SW_MEC_5E; SW-SMD_4P-L5.1-W5.1-P3.70-LS6.5-TL-2
U2: ATmega2560-16A; TQFP-100_14x14mm_P0.5mm
U3: CH340C; SOP-16_L10.0-W3.9-P1.27-LS6.0-BL
U7, U13, U19: MAX487ESA+T; DIP-8_W7.62mm
U8, U14, U20: MAX487ESA+T; SOIC-8_L5.0-W4.0-P1.27-LS6.0-BL
Y1: Crystal_GND24; Crystal_SMD_3225-4Pin_3.2x2.5mm

Connections:
+5V: C1.1, C2.1, C3.1, C4.1, C5.1, C6.1, C14.1, C17.1, C18.1, C19.1, D3.2 (A), J2.2 (VCC), R1.1, R2.1, R7.2, R8.2, U2.10 (VCC), U2.31 (VCC), U2.61 (VCC), U2.80 (VCC), U2.100 (AVCC), U7.8 (VCC), U8.8 (VCC), U13.8 (VCC), U14.8 (VCC), U19.8 (VCC), U20.8 (VCC)
+12V: F4.1, F7.1, F10.1, PSU1.1, PSU1.3, PSU1.5, PSU2.1, PSU2.3, PSU2.5
D2: U2.6 (PE4/~D2), U7.2 (~RE), U7.3 (DE), U8.2 (~RE), U8.3 (DE)
D3: U2.7 (PE5/~D3), U13.2 (~RE), U13.3 (DE), U14.2 (~RE), U14.3 (DE)
D4: U2.1 (PG5/~D4), U19.2 (~RE), U19.3 (DE), U20.2 (~RE), U20.3 (DE)
D13: R3.1, U2.26 (PB7/~D13)
D14: U2.64 (PJ1/TXD3/D14), U19.4 (DI), U20.4 (DI)
D15: U2.63 (PJ0/RXD3/D15), U19.1 (RO), U20.1 (RO)
D16: U2.13 (PH1/TXD2/D16), U13.4 (DI), U14.4 (DI)
D17: U2.12 (PH0/RXD2/D17), U13.1 (RO), U14.1 (RO)
D18: U2.46 (PD3/TXD1/D18), U7.4 (DI), U8.4 (DI)
D19: U2.45 (PD2/RXD1/D19), U7.1 (RO), U8.1 (RO)
D50: J2.1 (MISO), U2.22 (PB3/MISO/D50)
D51: J2.4 (MOSI), U2.21 (PB2/MOSI/D51)
D52: J2.3 (SCK), U2.20 (PB1/SCK/D52)
D+: J3.3 (D+), U3.5 (UD+)
D-: J3.2 (D-), U3.6 (UD-)
FTDI_DTR: C7.2, U3.13 (~DTR)
GND: BUS1.2, BUS1.4, BUS1.6, BUS2.2, BUS2.4, BUS2.6, BUS3.2, BUS3.4, BUS3.6, C1.2, C2.2, C3.2, C4.2, C5.2, C6.2, C8.1, C12.1, C13.1, C15.1, C16.2, C17.2, C18.2, C19.2, D1.1 (K), D2.1 (K), D6.3 (common), D7.1 (K), D8.3 (common), D9.1 (K), D10.3 (common), D11.1 (K), J2.6 (GND), J3.5 (GND), J3.6 (Shield), PSU1.2, PSU1.4, PSU1.6, PSU2.2, PSU2.4, PSU2.6, SW1.1, SW1.2, U2.11 (GND), U2.32 (GND), U2.62 (GND), U2.81 (GND), U2.99 (GND), U3.1 (GND), U7.5 (GND), U8.5 (GND), U13.5 (GND), U14.5 (GND), U19.5 (GND), U20.5 (GND), Y1.2, Y1.4
unnamed: BUS1.1, BUS1.3, BUS1.5, F4.2, R10.2
unnamed: BUS2.1, BUS2.3, BUS2.5, F7.2, R12.2
unnamed: BUS3.1, BUS3.3, BUS3.5, F10.2, R14.2
unnamed: C8.2, U2.98 (AREF)
unnamed: C12.2, C13.2, D3.1 (K), J3.1 (VBUS)
unnamed: C14.2, U3.16 (VCC)
unnamed: D1.2 (A), R3.2
unnamed: D2.2 (A), R2.2
unnamed: D4.2 (A), R7.1
unnamed: D5.2 (A), R8.1
unnamed: D7.2 (A), R10.1
unnamed: D9.2 (A), R12.1
unnamed: D11.2 (A), R14.1
unnamed: F2.1, R9.1, U7.7 (B), U8.7 (B)
unnamed: F3.2, R9.2, U7.6 (A), U8.6 (A)
unnamed: F5.1, R11.1, U13.7 (B), U14.7 (B)
unnamed: F6.2, R11.2, U13.6 (A), U14.6 (A)
unnamed: F8.1, R13.1, U19.7 (B), U20.7 (B)
unnamed: F9.2, R13.2, U19.6 (A), U20.6 (A)
unnamed: R5.1, U3.2 (TXD)
unnamed: R6.1, U3.3 (RXD)
RESET: C7.1, J2.5 (~RST), R1.2, SW1.3 (K), SW1.4 (A), U2.30 (~RESET)
RS485-1+: BUS1.8, D6.1 (A1), F3.1
RS485-1-: BUS1.7, D6.2 (A2), F2.2
RS485-2+: BUS2.8, D8.1 (A1), F6.1
RS485-2-: BUS2.7, D8.2 (A2), F5.2
RS485-3+: BUS3.8, D10.1 (A1), F9.1
RS485-3-: BUS3.7, D10.2 (A2), F8.2
USB_RXD: D5.1 (K), R6.2, U2.3 (PE1/TXD0/~D1)
USB_TXD: D4.1 (K), R5.2, U2.2 (PE0/RXD0/~D0)
XTAL1: C15.2, U2.34 (XTAL1), Y1.1
XTAL2: C16.1, U2.33 (XTAL2), Y1.3
