maciekish/warthogathome/PCBs/Slaves/Mega SFF Slave/Mega SFF Slave.kicad_pcb

## KiCad design PCBs/Slaves/Mega SFF Slave/Mega SFF Slave.kicad_pcb (2022-12-29)

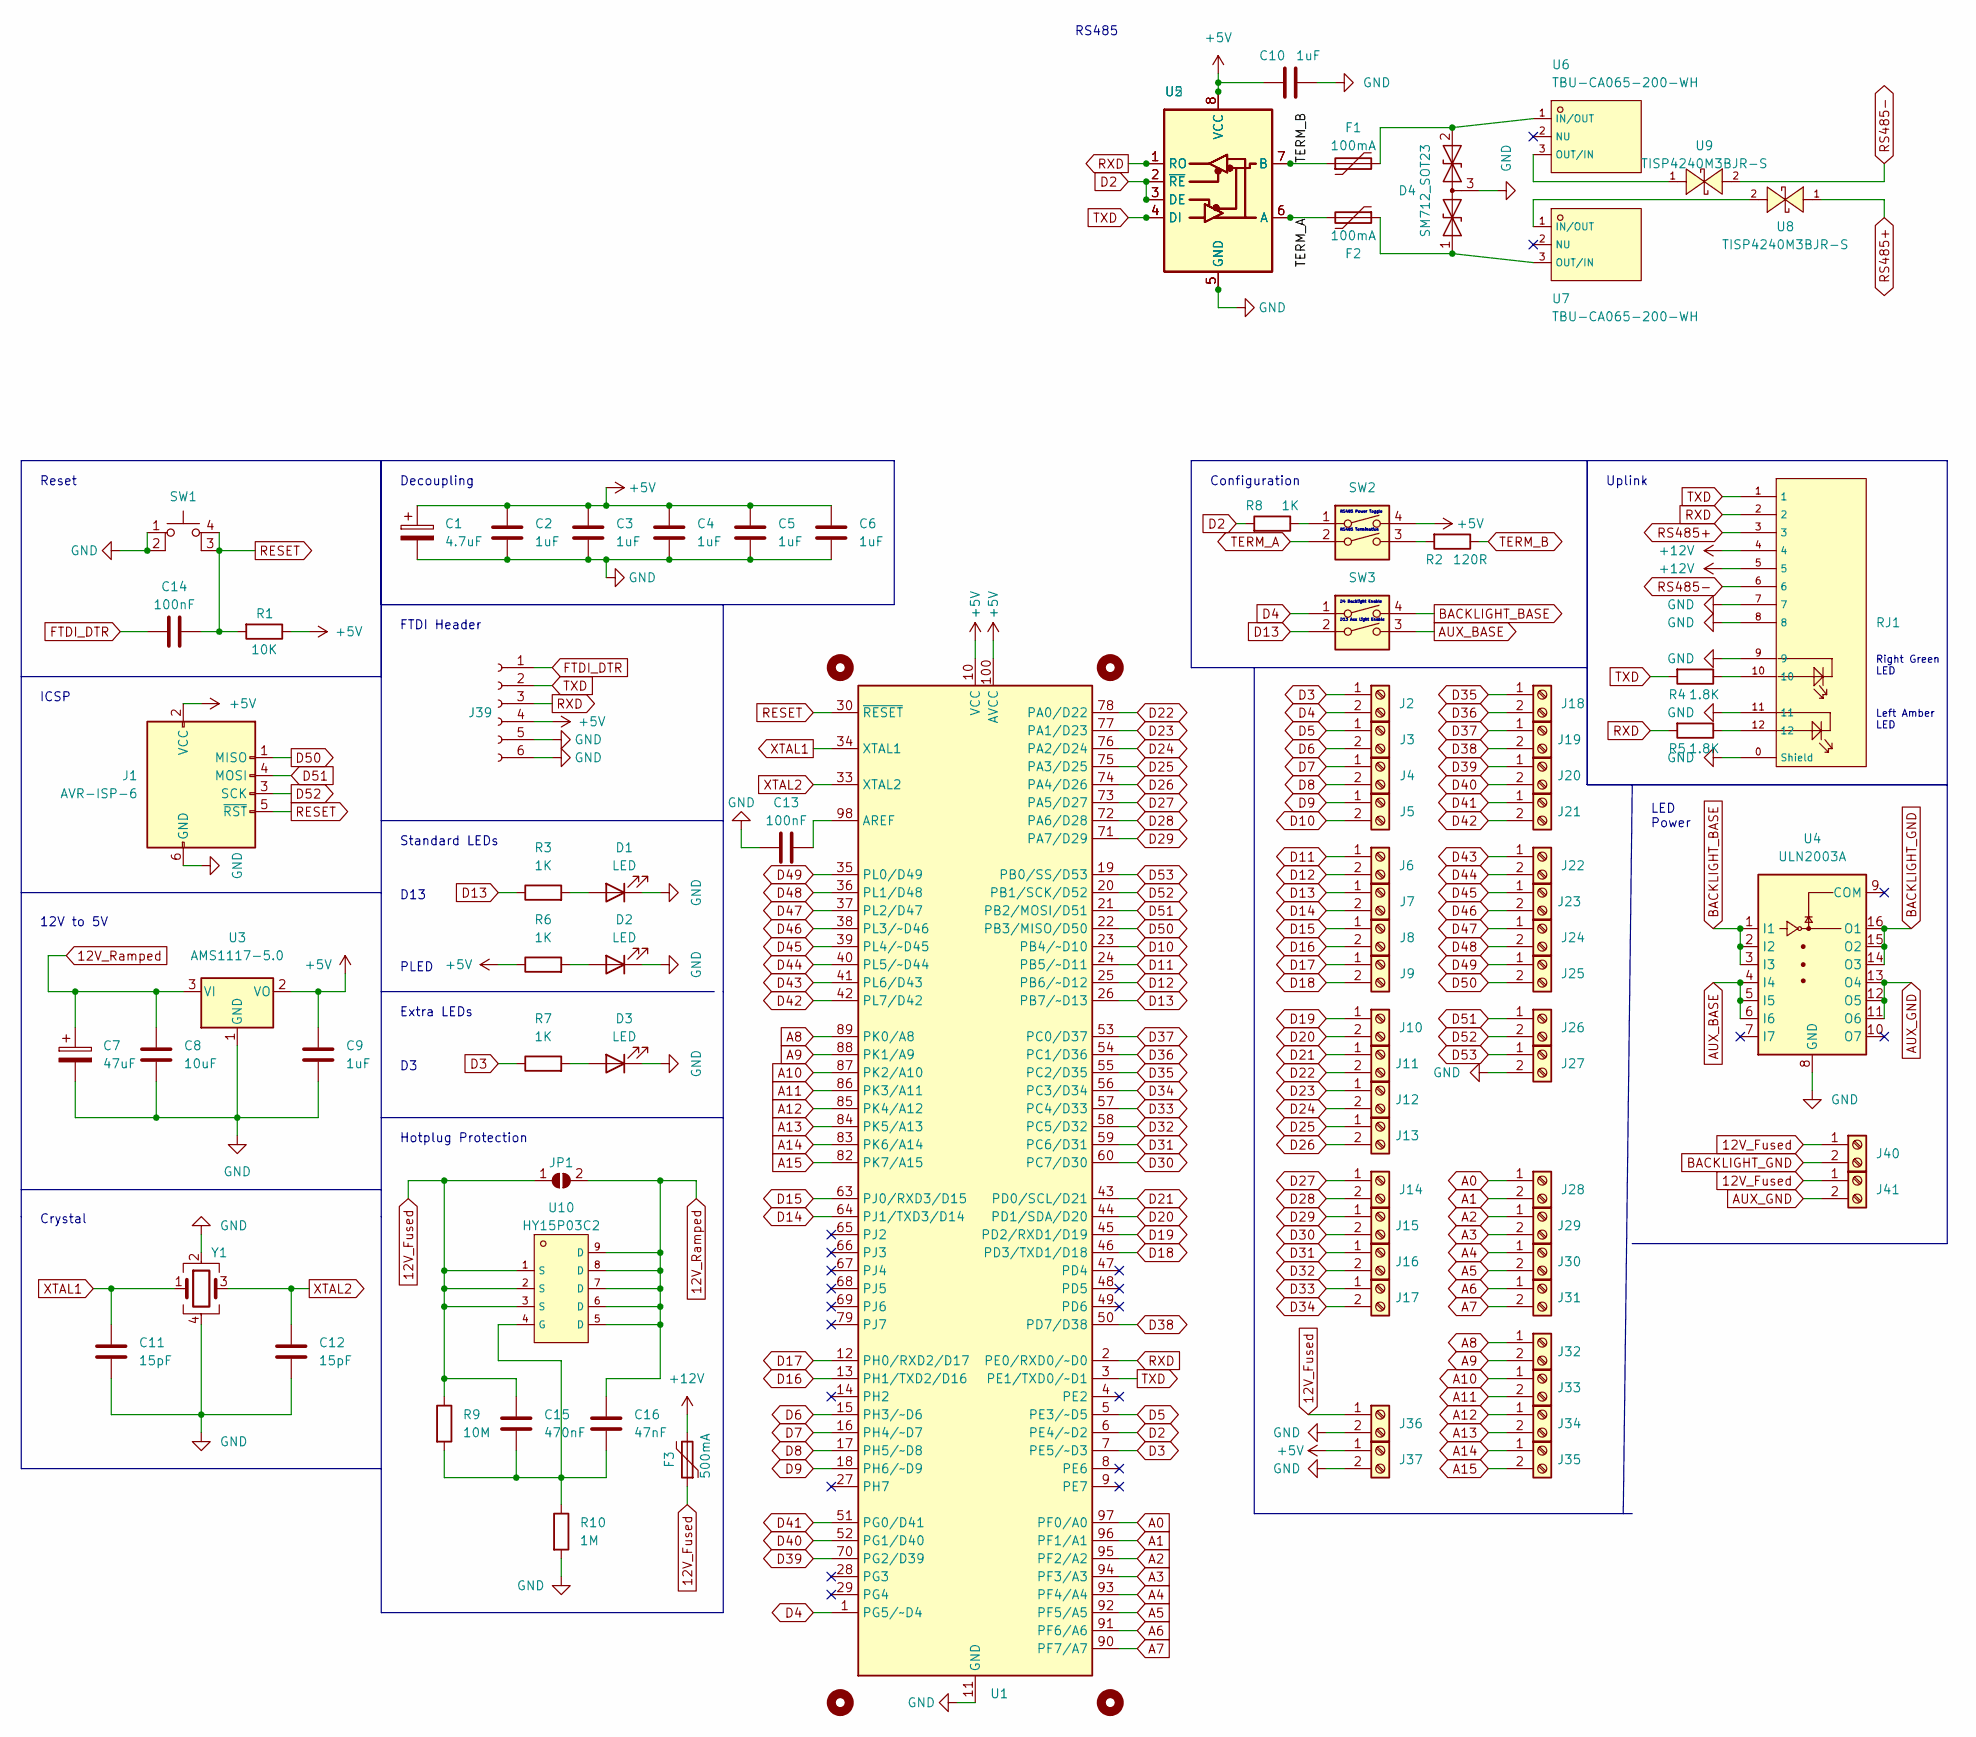
[picture p48: schematic Mega SFF Slave.kicad_sch, DCS-BIOS Mega Slave]

Parts:
C1: 4.7uF; C0805; LCSC C1779
C2, C3, C4, C5, C6, C9, C10: 1uF; C0402; LCSC C52923
C7: 47uF; CP_Elec_5x5.4; LCSC C96178
C8: 10uF; C0402; LCSC C15525
C11, C12: 15pF; C0402; LCSC C1548
C13, C14: 100nF; C0402; LCSC C1525
C15: 470nF; C_0603_1608Metric; LCSC C1623
C16: 47nF; C_0603_1608Metric; LCSC C1622
D1, D2, D3: LED; LED_0603_1608Metric; LCSC C72041
D4: SM712_SOT23; SOT-23; LCSC C558433
F1, F2: 100mA; Fuse_0603_1608Metric; LCSC C207238
F3: 500mA; Fuse_1206_3216Metric; LCSC C369159
H1, H2, H3, H4: MountingHole; MountingHole_3.2mm_M3
J1: AVR-ISP-6; PinHeader_2x03_P2.54mm_Vertical; LCSC C492420
J2, J3, J4, J5, J6, J7, J8, J9, J10, J11, J12, J13, J14, J15, J16, J17, J18, J19, J20, J21, J22, J23, J24, J25, J26, J27, J28, J29, J30, J31, J32, J33, J34, J35, J36, J37, J40, J41: Screw_Terminal_01x02; CONN-TH_XY308-2.54-2P; LCSC C557685
J39: Conn_01x06_Female; PinSocket_1x06_P2.54mm_Vertical; LCSC C40877
JP1: Solder; SolderJumper-2_P1.3mm_Open_RoundedPad1.0x1.5mm
R1: 10K; R_0805_2012Metric; LCSC C17414
R2: 120R; R_0805_2012Metric; LCSC C17437
R3, R6, R7, R8: 1K; R_0805_2012Metric; LCSC C17513
R4, R5: 1.8K; R_0805_2012Metric; LCSC C17398
R9: 10M; R_0603_1608Metric; LCSC C7250
R10: 1M; R_0603_1608Metric; LCSC C22935
RJ1: RJ45-B-1*1; RJ45-TH_B-1-1; LCSC C138392
SW1: SW_MEC_5E; SW-SMD_4P-L5.1-W5.1-P3.70-LS6.5-TL-2; LCSC C318884
SW2, SW3: SW_DIP_x02; SW-SMD_DSHP02TSGER; LCSC C367376
U1: ATmega2560-16A; TQFP-100_14x14mm_P0.5mm; LCSC C22460
U2: MAX487ESA+T; SOIC-8_L5.0-W4.0-P1.27-LS6.0-BL; LCSC C9953
U3: AMS1117-5.0; SOT-223-3_TabPin2; LCSC C6187
U4: ULN2003A; SOP-16_L10.0-W3.9-P1.27-LS6.0-BL; LCSC C7512
U5: MAX487ESA+T; DIP-8_W7.62mm; LCSC C9953
U6, U7: TBU-CA065-200-WH; DIO-SMD_3P-L6.5-W4.0-BI; LCSC C913221
U8, U9: TISP4240M3BJR-S; DO-214AA_L4.4-W3.6-LS5.3-BI; LCSC C840526
U10: HY15P03C2; DFN-8_L5.9-W5.2-P1.27-LS6.2-BL; LCSC C123687
Y1: Crystal_GND24; Crystal_SMD_3225-4Pin_3.2x2.5mm; LCSC C13738

Connections:
12V_Fused: C15.1, F3.1, J36.1, J40.1, J41.1, JP1.1 (A), R9.1, U10.1 (S), U10.2 (S), U10.3 (S)
12V_Ramped: C7.1, C8.1, C16.1, JP1.2 (B), U3.3 (VI), U10.5 (D), U10.6 (D), U10.7 (D), U10.8 (D), U10.9 (D)
+5V: C1.1, C2.1, C3.1, C4.1, C5.1, C6.1, C9.1, C10.1, J1.2 (VCC), J37.1, J39.4, R1.1, R6.1, SW2.4, U1.10 (VCC), U1.31 (VCC), U1.61 (VCC), U1.80 (VCC), U1.100 (AVCC), U2.8 (VCC), U3.2 (VO), U5.8 (VCC)
+12V: F3.2, RJ1.4, RJ1.5
A0: J28.1, U1.97 (PF0/A0)
A1: J28.2, U1.96 (PF1/A1)
A2: J29.1, U1.95 (PF2/A2)
A3: J29.2, U1.94 (PF3/A3)
A4: J30.1, U1.93 (PF4/A4)
A5: J30.2, U1.92 (PF5/A5)
A6: J31.1, U1.91 (PF6/A6)
A7: J31.2, U1.90 (PF7/A7)
A8: J32.1, U1.89 (PK0/A8)
A9: J32.2, U1.88 (PK1/A9)
A10: J33.1, U1.87 (PK2/A10)
A11: J33.2, U1.86 (PK3/A11)
A12: J34.1, U1.85 (PK4/A12)
A13: J34.2, U1.84 (PK5/A13)
A14: J35.1, U1.83 (PK6/A14)
A15: J35.2, U1.82 (PK7/A15)
AUX_BASE: SW3.3, U4.4 (I4), U4.5 (I5), U4.6 (I6)
AUX_GND: J41.2, U4.11 (O6), U4.12 (O5), U4.13 (O4)
BACKLIGHT_BASE: SW3.4, U4.1 (I1), U4.2 (I2), U4.3 (I3)
BACKLIGHT_GND: J40.2, U4.14 (O3), U4.15 (O2), U4.16 (O1)
D2: R8.2, U1.6 (PE4/~D2), U2.2 (~RE), U2.3 (DE), U5.2 (~RE), U5.3 (DE)
D3: J2.1, R7.1, U1.7 (PE5/~D3)
D4: J2.2, SW3.1, U1.1 (PG5/~D4)
D5: J3.1, U1.5 (PE3/~D5)
D6: J3.2, U1.15 (PH3/~D6)
D7: J4.1, U1.16 (PH4/~D7)
D8: J4.2, U1.17 (PH5/~D8)
D9: J5.1, U1.18 (PH6/~D9)
D10: J5.2, U1.23 (PB4/~D10)
D11: J6.1, U1.24 (PB5/~D11)
D12: J6.2, U1.25 (PB6/~D12)
D13: J7.1, R3.1, SW3.2, U1.26 (PB7/~D13)
D14: J7.2, U1.64 (PJ1/TXD3/D14)
D15: J8.1, U1.63 (PJ0/RXD3/D15)
D16: J8.2, U1.13 (PH1/TXD2/D16)
D17: J9.1, U1.12 (PH0/RXD2/D17)
D18: J9.2, U1.46 (PD3/TXD1/D18)
D19: J10.1, U1.45 (PD2/RXD1/D19)
D20: J10.2, U1.44 (PD1/SDA/D20)
D21: J11.1, U1.43 (PD0/SCL/D21)
D22: J11.2, U1.78 (PA0/D22)
D23: J12.1, U1.77 (PA1/D23)
D24: J12.2, U1.76 (PA2/D24)
D25: J13.1, U1.75 (PA3/D25)
D26: J13.2, U1.74 (PA4/D26)
D27: J14.1, U1.73 (PA5/D27)
D28: J14.2, U1.72 (PA6/D28)
D29: J15.1, U1.71 (PA7/D29)
D30: J15.2, U1.60 (PC7/D30)
D31: J16.1, U1.59 (PC6/D31)
D32: J16.2, U1.58 (PC5/D32)
D33: J17.1, U1.57 (PC4/D33)
D34: J17.2, U1.56 (PC3/D34)
D35: J18.1, U1.55 (PC2/D35)
D36: J18.2, U1.54 (PC1/D36)
D37: J19.1, U1.53 (PC0/D37)
D38: J19.2, U1.50 (PD7/D38)
D39: J20.1, U1.70 (PG2/D39)
D40: J20.2, U1.52 (PG1/D40)
D41: J21.1, U1.51 (PG0/D41)
D42: J21.2, U1.42 (PL7/D42)
D43: J22.1, U1.41 (PL6/D43)
D44: J22.2, U1.40 (PL5/~D44)
D45: J23.1, U1.39 (PL4/~D45)
D46: J23.2, U1.38 (PL3/~D46)
D47: J24.1, U1.37 (PL2/D47)
D48: J24.2, U1.36 (PL1/D48)
D49: J25.1, U1.35 (PL0/D49)
D50: J1.1 (MISO), J25.2, U1.22 (PB3/MISO/D50)
D51: J1.4 (MOSI), J26.1, U1.21 (PB2/MOSI/D51)
D52: J1.3 (SCK), J26.2, U1.20 (PB1/SCK/D52)
D53: J27.1, U1.19 (PB0/SS/D53)
FTDI_DTR: C14.2, J39.1
GND: C1.2, C2.2, C3.2, C4.2, C5.2, C6.2, C7.2, C8.2, C9.2, C10.2, C11.1, C12.2, C13.1, D1.1 (K), D2.1 (K), D3.1 (K), D4.3 (common), J1.6 (GND), J27.2, J36.2, J37.2, J39.5, J39.6, R10.2, RJ1.0 (Shield), RJ1.7, RJ1.8, RJ1.9, RJ1.11, SW1.1, SW1.2, U1.11 (GND), U1.32 (GND), U1.62 (GND), U1.81 (GND), U1.99 (GND), U2.5 (GND), U3.1 (GND), U4.8 (GND), U5.5 (GND), Y1.2, Y1.4
unnamed: C13.2, U1.98 (AREF)
unnamed: C15.2, C16.2, R9.2, R10.1, U10.4 (G)
unnamed: D1.2 (A), R3.2
unnamed: D2.2 (A), R6.2
unnamed: D3.2 (A), R7.2
unnamed: D4.1 (A1), F2.1, U7.3 (OUT/IN)
unnamed: D4.2 (A2), F1.2, U6.1 (IN/OUT)
unnamed: R2.2, SW2.3
unnamed: R4.1, RJ1.10
unnamed: R5.1, RJ1.12
unnamed: R8.1, SW2.1
unnamed: U6.3 (OUT/IN), U9.1 (A)
unnamed: U7.1 (IN/OUT), U8.2 (K)
RESET: C14.1, J1.5 (~RST), R1.2, SW1.3 (K), SW1.4 (A), U1.30 (~RESET)
RS485+: RJ1.3, U8.1 (A)
RS485-: RJ1.6, U9.2 (K)
RXD: J39.3, R5.2, RJ1.2, U1.2 (PE0/RXD0/~D0), U2.1 (RO), U5.1 (RO)
TERM_A: F2.2, SW2.2, U2.6 (A), U5.6 (A)
TERM_B: F1.1, R2.1, U2.7 (B), U5.7 (B)
TXD: J39.2, R4.2, RJ1.1, U1.3 (PE1/TXD0/~D1), U2.4 (DI), U5.4 (DI)
XTAL1: C11.2, U1.34 (XTAL1), Y1.1
XTAL2: C12.1, U1.33 (XTAL2), Y1.3

Notes on the sheet:
RS485
Reset
Hotplug Protection
LED Power
Right Green LED
Configuration
Crystal
Standard LEDs
Decoupling
Left Amber LED
RS485 Termination
Extra LEDs
D4 Backlight Enable
12V to 5V
RS485 Power Toggle
Uplink
D13 Aux Light Enable
D13
FTDI Header
ICSP
PLED

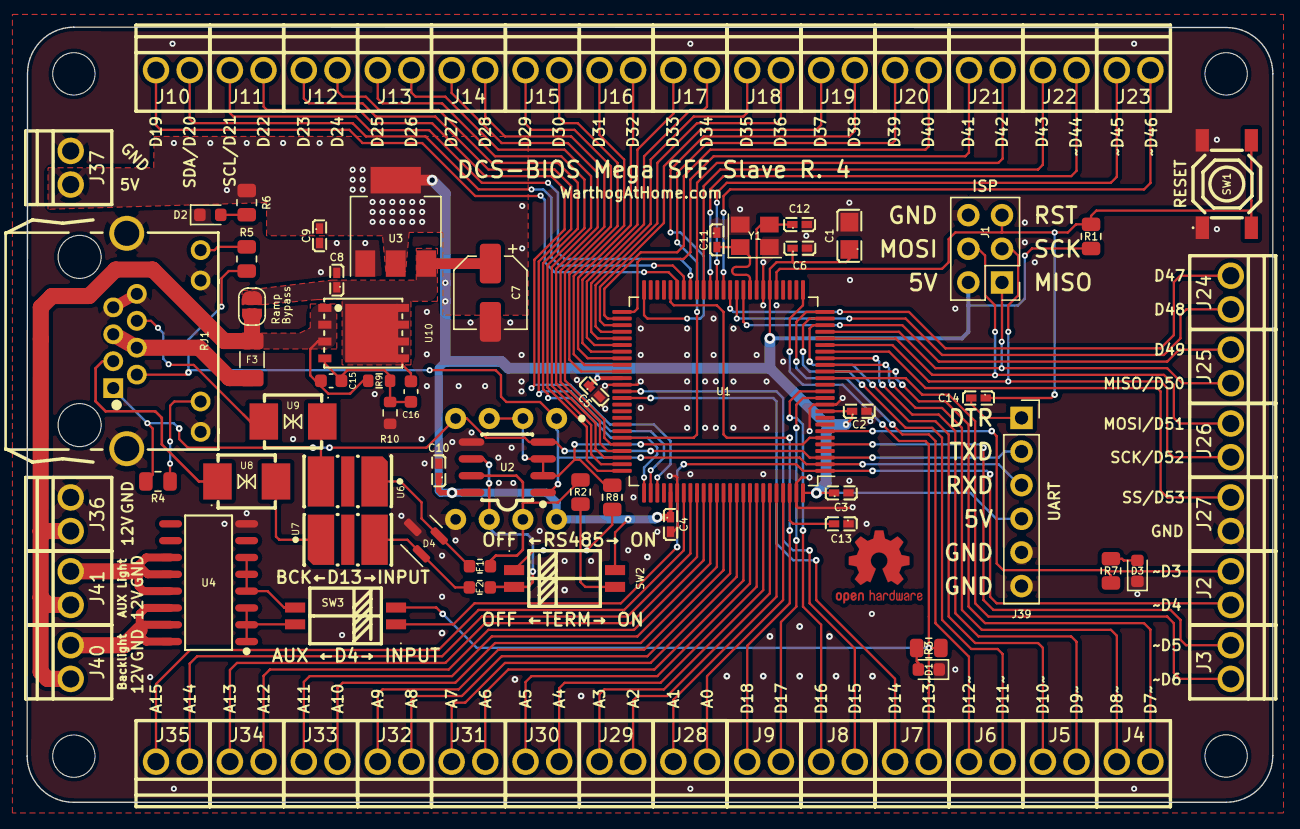
[picture p49: board Mega SFF Slave.kicad_pcb from above]

Board: 2 copper layers, 94.1 x 58.5 mm, 93 parts (0 on the bottom side), 100 nets.
