maciekish/warthogathome/PCBs/Misc/External Connectors/External Connectors.kicad_pcb

## KiCad design PCBs/Misc/External Connectors/External Connectors.kicad_pcb (2022-12-26)

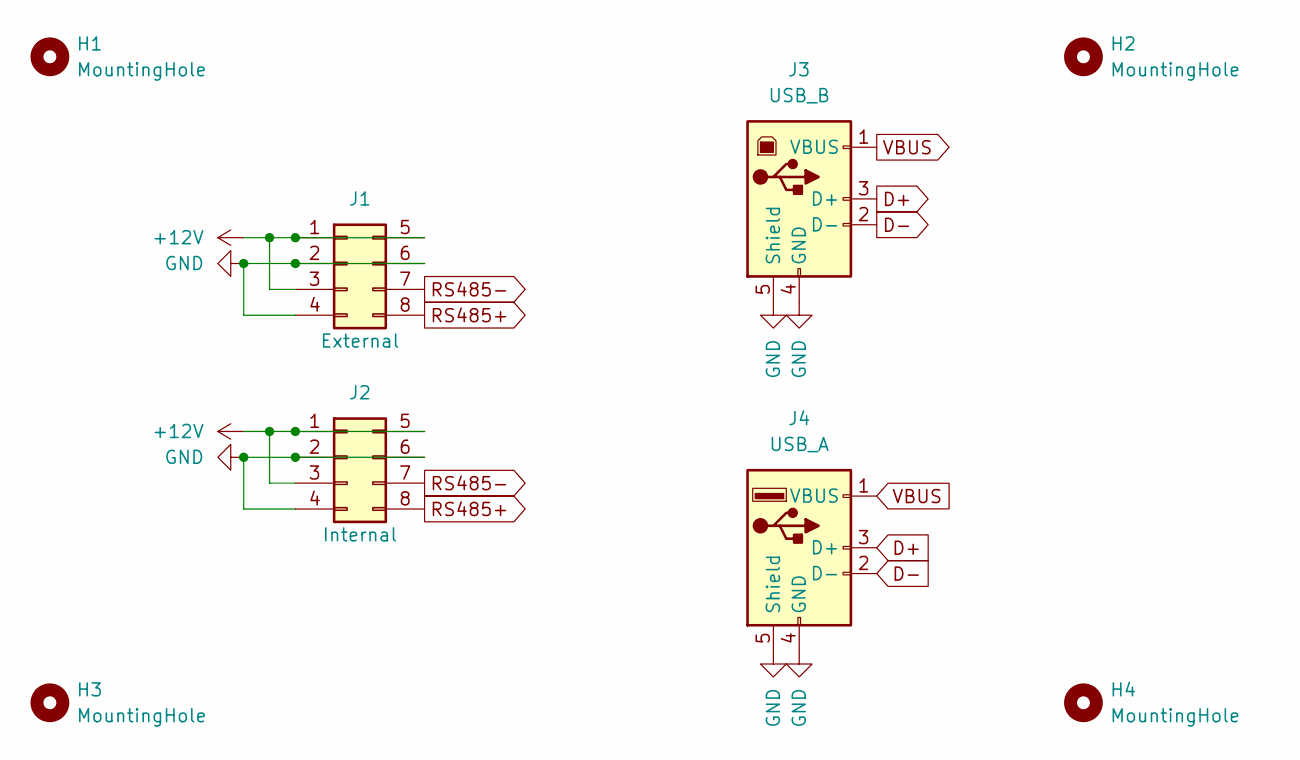
[picture p50: schematic External Connectors.kicad_sch]

Parts:
H1, H2, H3, H4: MountingHole; MountingHole_3.2mm_M3
J1, J2: Conn_02x04_Top_Bottom; Molex Micro-Fit 3.0 43045-0800; LCSC C234189
J3: USB_B; USB-B-TH_67068-8000; LCSC C114097
J4: USB_A; USB-A-TH_USB-302-T; LCSC C86461

Connections:
+12V: J1.1, J1.3, J1.5, J2.1, J2.3, J2.5
D+: J3.3 (D+), J4.3 (D+)
D-: J3.2 (D-), J4.2 (D-)
GND: J1.2, J1.4, J1.6, J2.2, J2.4, J2.6, J3.4 (GND), J3.5 (Shield), J4.4 (GND), J4.5 (Shield)
RS485+: J1.8, J2.8
RS485-: J1.7, J2.7
VBUS: J3.1 (VBUS), J4.1 (VBUS)

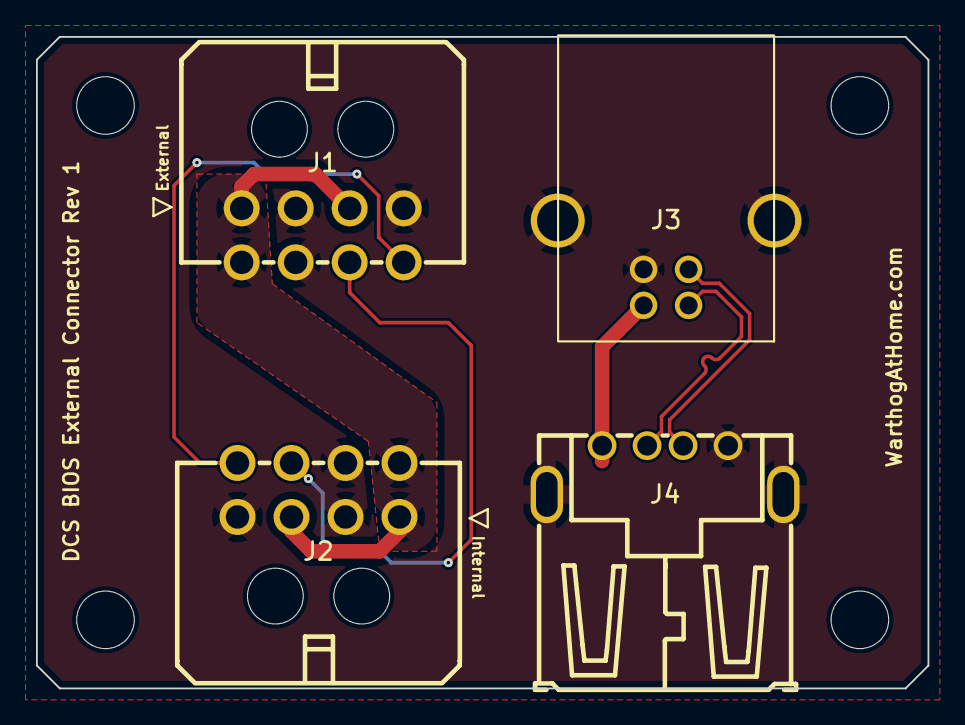
[picture p51: board External Connectors.kicad_pcb from above]

Board: 2 copper layers, 49.5 x 36.2 mm, 8 parts (0 on the bottom side), 7 nets.
