maciekish/warthogathome/PCBs/Master/Shield/Master Shield.kicad_pcb

## KiCad design PCBs/Master/Shield/Master Shield.kicad_pcb (2022-12-26)

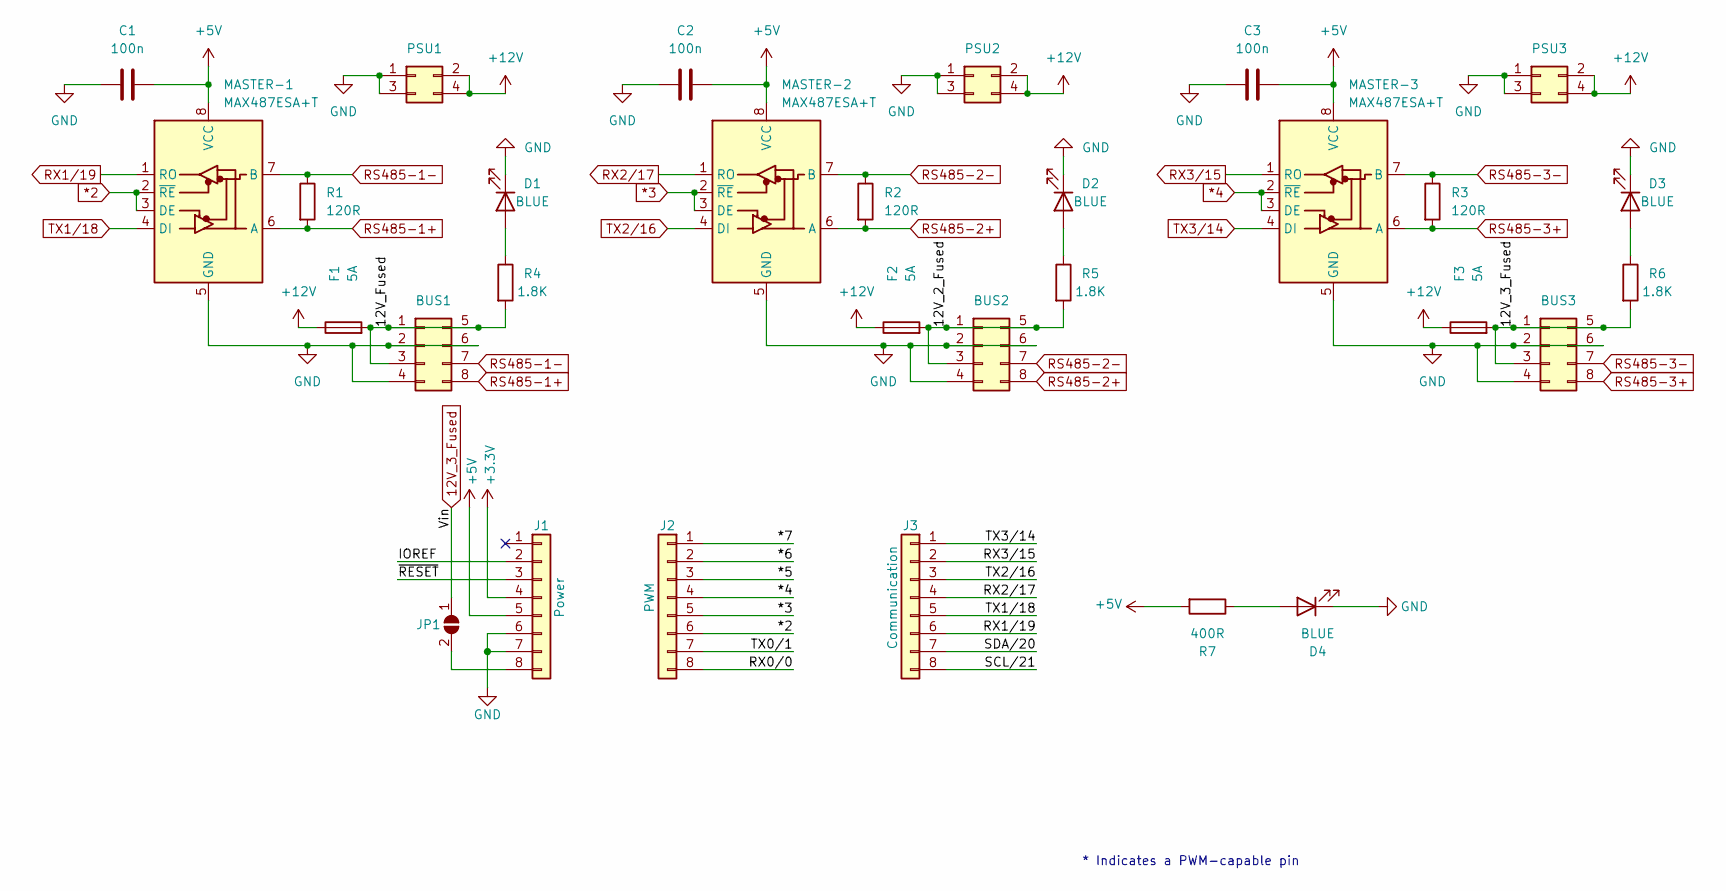
[picture p52: schematic Master Shield.kicad_sch]

Parts:
BUS1, BUS2, BUS3: Conn_02x04_Top_Bottom; CONN-TH_430450812; LCSC C277661
C1, C2, C3: 100n; C0402; LCSC C1525
D1, D2, D3, D4: BLUE; LED_0603_1608Metric; LCSC C72041
F1, F2, F3: 5A; FUSE_BK-6013; LCSC C492610
J1: Power; PinHeader_1x08_P2.54mm_Vertical; LCSC C124381
J2: PWM; PinHeader_1x08_P2.54mm_Vertical; LCSC C124381
J3: Communication; PinHeader_1x08_P2.54mm_Vertical; LCSC C124381
JP1: SolderJumper_2_Open; SolderJumper-2_P1.3mm_Open_RoundedPad1.0x1.5mm
MASTER-1, MASTER-2, MASTER-3: MAX487ESA+T; SOIC-8_L5.0-W4.0-P1.27-LS6.0-BL; LCSC C9953
PSU1, PSU2, PSU3: Conn_02x02_Top_Bottom; CONN-TH_0430450400
R1, R2, R3: 120R; R_0805_2012Metric; LCSC C17437
R4, R5, R6: 1.8K; R_0805_2012Metric; LCSC C17398
R7: 400R; R_0805_2012Metric; LCSC C17655

Connections:
12V_3_Fused: BUS3.1, BUS3.3, BUS3.5, F3.2, JP1.1 (A), R6.2
*2: J2.6, MASTER-1.2 (~RE), MASTER-1.3 (DE)
*3: J2.5, MASTER-2.2 (~RE), MASTER-2.3 (DE)
*4: J2.4, MASTER-3.2 (~RE), MASTER-3.3 (DE)
+3V3: J1.4
+5V: C1.2, C2.2, C3.2, J1.5, MASTER-1.8 (VCC), MASTER-2.8 (VCC), MASTER-3.8 (VCC), R7.2
/12V_2_Fused: BUS2.1, BUS2.3, BUS2.5, F2.2, R5.2
/12V_Fused: BUS1.1, BUS1.3, BUS1.5, F1.2, R4.2
/*5: J2.3
/*6: J2.2
/*7: J2.1
/IOREF: J1.2
/RX0/0: J2.8
/SCL/21: J3.8
/SDA/20: J3.7
/TX0/1: J2.7
/~RESET: J1.3
GND: BUS1.2, BUS1.4, BUS1.6, BUS2.2, BUS2.4, BUS2.6, BUS3.2, BUS3.4, BUS3.6, C1.1, C2.1, C3.1, D1.1 (K), D2.1 (K), D3.1 (K), D4.1 (K), J1.6, J1.7, MASTER-1.5 (GND), MASTER-2.5 (GND), MASTER-3.5 (GND), PSU1.1, PSU1.3, PSU2.1, PSU2.3, PSU3.1, PSU3.3
unnamed: D1.2 (A), R4.1
unnamed: D2.2 (A), R5.1
unnamed: D3.2 (A), R6.1
unnamed: D4.2 (A), R7.1
unnamed: J1.8, JP1.2 (B)
RS485-1+: BUS1.8, MASTER-1.6 (A), R1.2
RS485-1-: BUS1.7, MASTER-1.7 (B), R1.1
RS485-2+: BUS2.8, MASTER-2.6 (A), R2.2
RS485-2-: BUS2.7, MASTER-2.7 (B), R2.1
RS485-3+: BUS3.8, MASTER-3.6 (A), R3.2
RS485-3-: BUS3.7, MASTER-3.7 (B), R3.1
RX1/19: J3.6, MASTER-1.1 (RO)
RX2/17: J3.4, MASTER-2.1 (RO)
RX3/15: J3.2, MASTER-3.1 (RO)
TX1/18: J3.5, MASTER-1.4 (DI)
TX2/16: J3.3, MASTER-2.4 (DI)
TX3/14: J3.1, MASTER-3.4 (DI)

Notes on the sheet:
* Indicates a PWM-capable pin

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
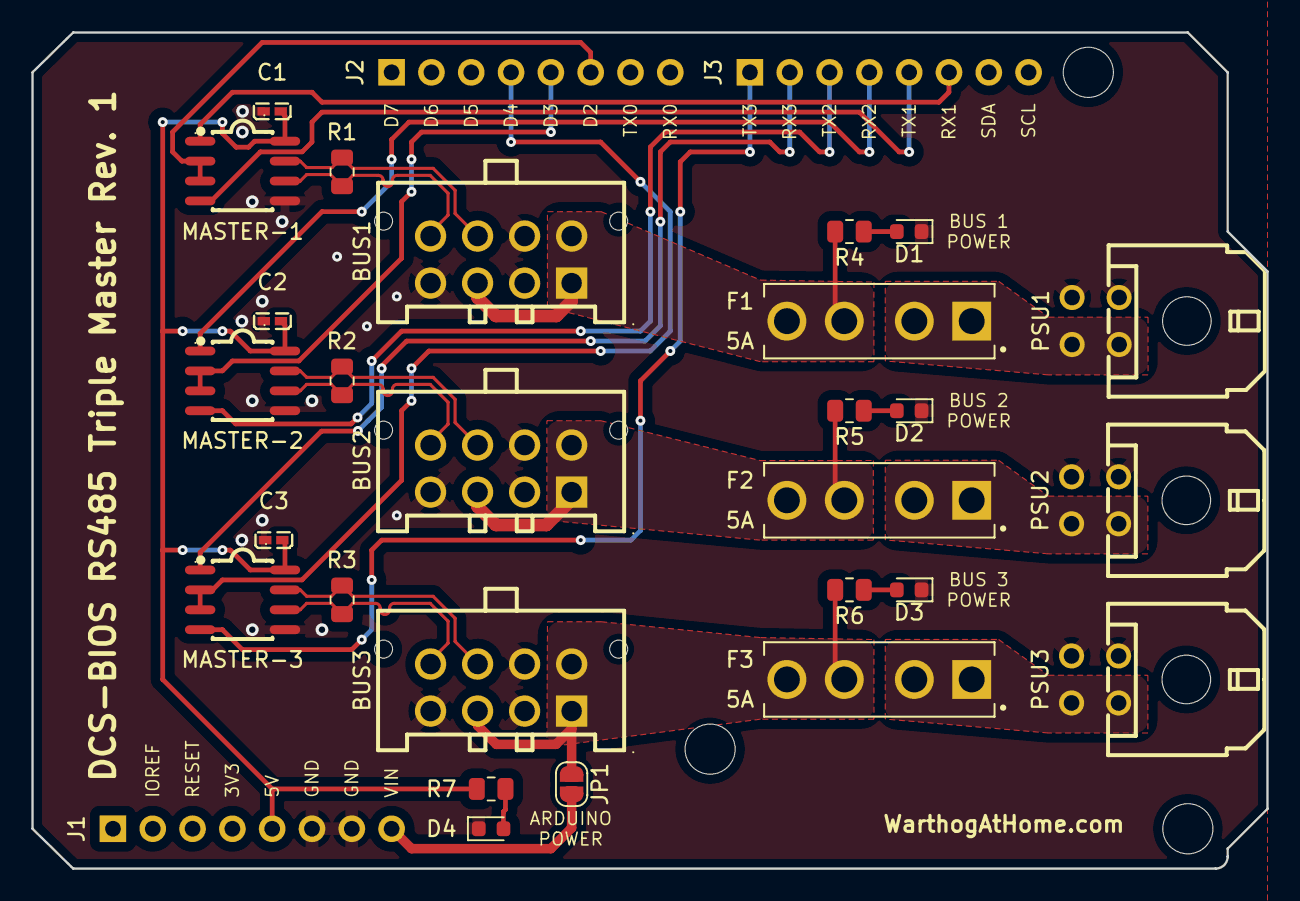
[picture p53: board Master Shield.kicad_pcb from above]

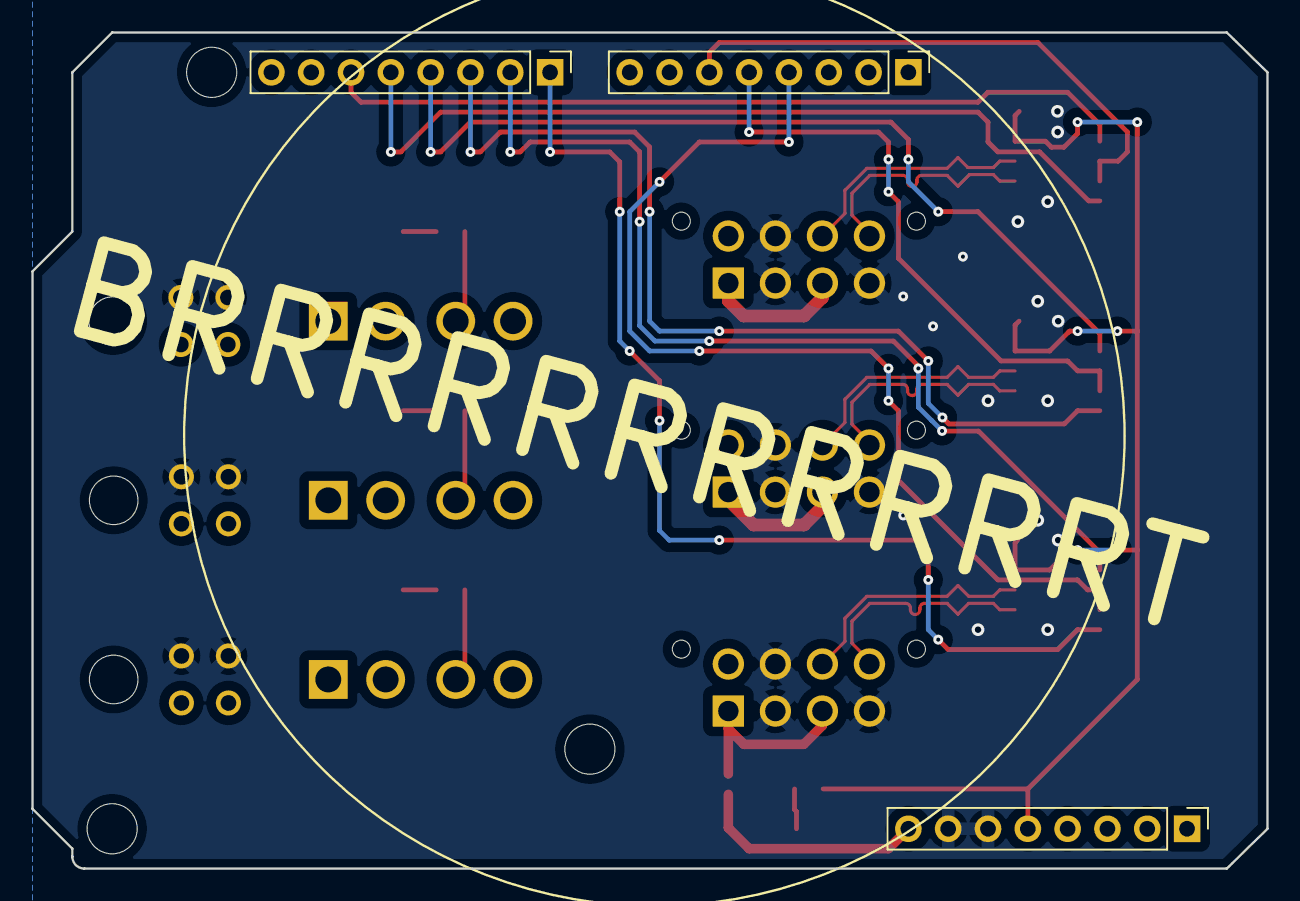
[picture p54: board Master Shield.kicad_pcb from below]

Board: 2 copper layers, 78.8 x 53.3 mm, 33 parts (3 on the bottom side), 28 nets.

Other parts of the board:
MH4, MH5, MH6: MountingHole_3.2mm
