maciekish/warthogathome/PCBs/Panels/Caution Panel/Caution Panel.kicad_pcb

## KiCad design PCBs/Panels/Caution Panel/Caution Panel.kicad_pcb (2022-10-01)

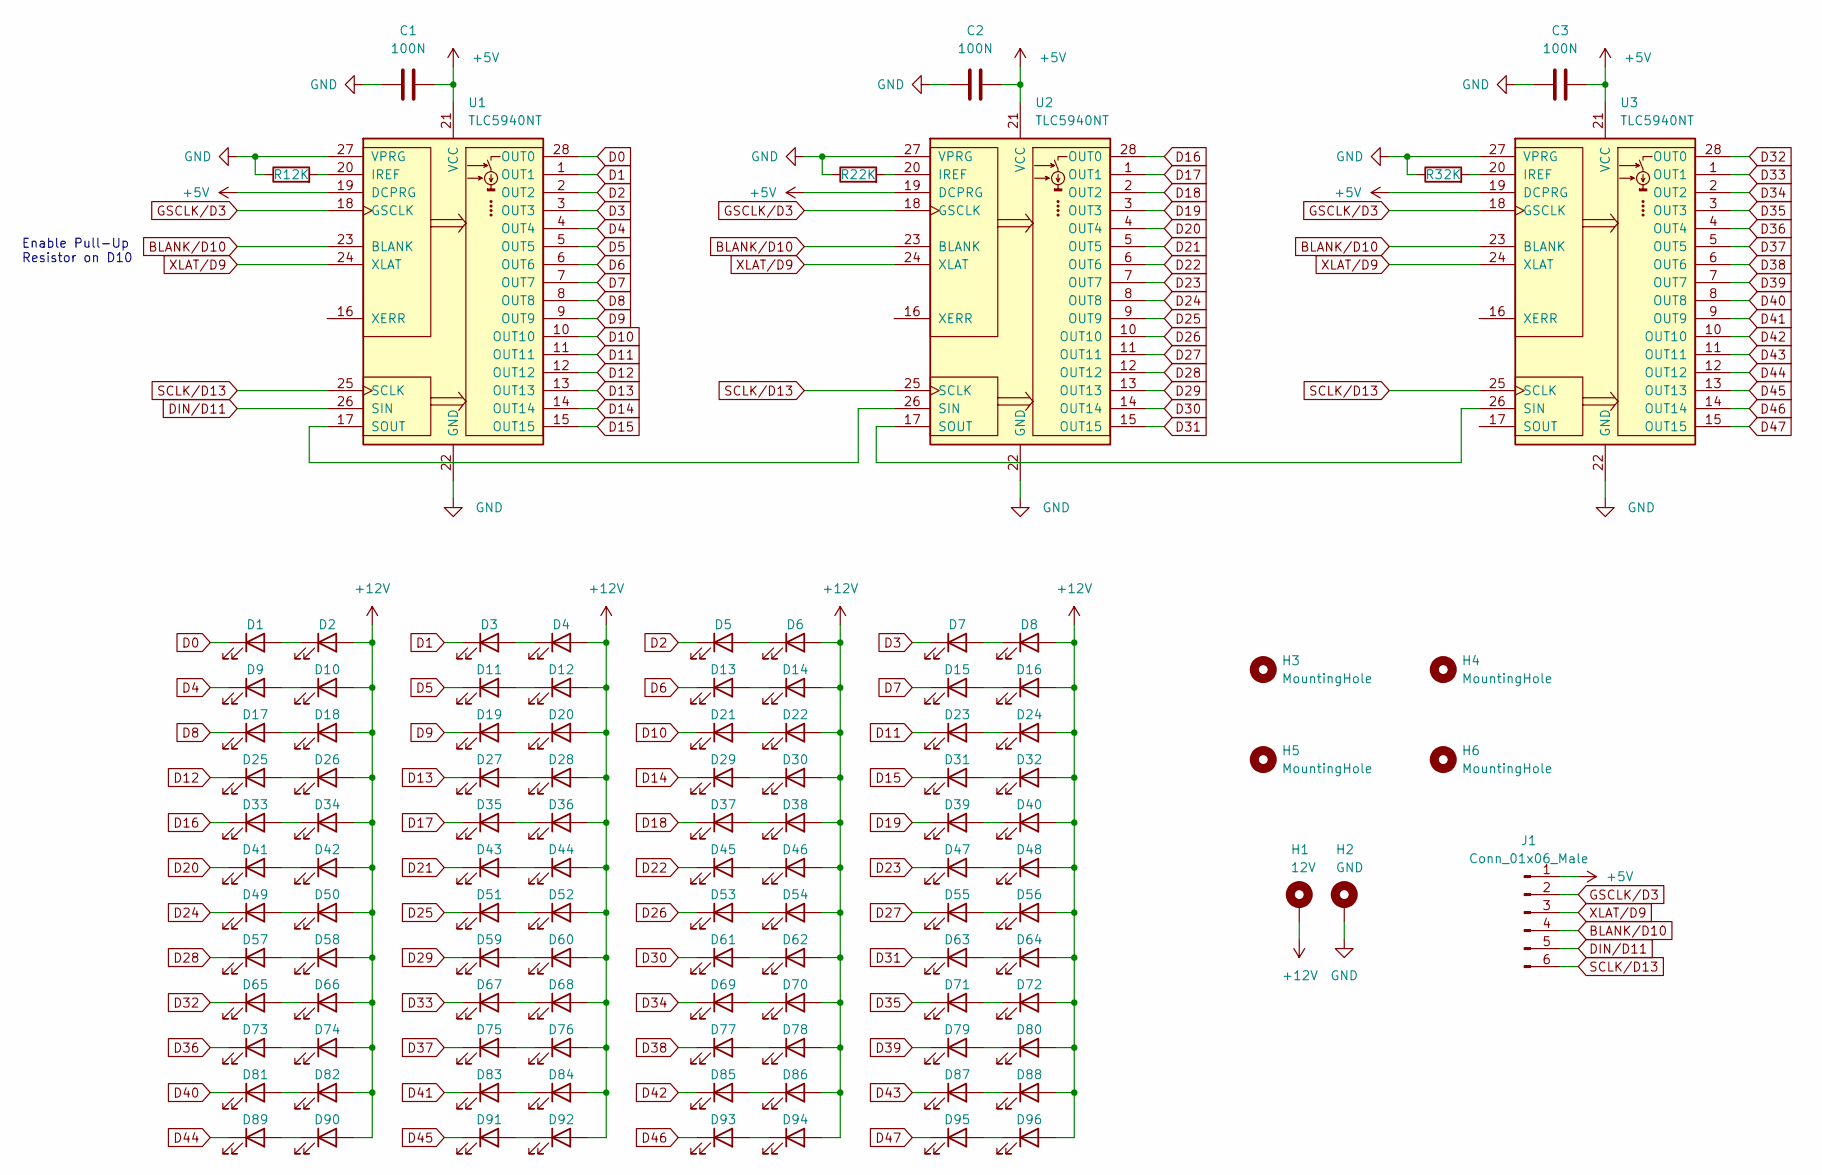
[picture p57: schematic Caution Panel.kicad_sch]

Parts:
C1, C2, C3: 100N; C_0805_2012Metric_Pad1.18x1.45mm_HandSolder
D1, D2, D3, D4, D5, D6, D7, D8, D9, D10, D11, D12, D13, D14, D15, D16, D17, D18, D19, D20, D21, D22, D23, D24, D25, D26, D27, D28, D29, D30, D31, D32, D33, D34, D35, D36, D37, D38, D39, D40, D41, D42, D43, D44, D45, D46, D47, D48, D49, D50, D51, D52, D53, D54, D55, D56, D57, D58, D59, D60, D61, D62, D63, D64, D65, D66, D67, D68, D69, D70, D71, D72, D73, D74, D75, D76, D77, D78, D79, D80, D81, D82, D83, D84, D85, D86, D87, D88, D89, D90, D91, D92, D93, D94, D95, D96: GREEN; LED_2010_5025Metric_Pad1.52x2.65mm_HandSolder
H1: 12V; MountingHole_2.2mm_M2_Pad
H2: GND; MountingHole_2.2mm_M2_Pad
H3, H4, H5, H6: MountingHole; MountingHole_4mm
J1: Conn_01x06_Male; PinHeader_1x06_P2.54mm_Vertical
R1, R2, R3: 2K; R_1210_3225Metric_Pad1.30x2.65mm_HandSolder
U1, U2, U3: TLC5940NT; DIP-28_W7.62mm

Connections:
+5V: C1.2, C2.2, C3.2, J1.1, U1.19 (DCPRG), U1.21 (VCC), U2.19 (DCPRG), U2.21 (VCC), U3.19 (DCPRG), U3.21 (VCC)
+12V: D2.2 (A), D4.2 (A), D6.2 (A), D8.2 (A), D10.2 (A), D12.2 (A), D14.2 (A), D16.2 (A), D18.2 (A), D20.2 (A), D22.2 (A), D24.2 (A), D26.2 (A), D28.2 (A), D30.2 (A), D32.2 (A), D34.2 (A), D36.2 (A), D38.2 (A), D40.2 (A), D42.2 (A), D44.2 (A), D46.2 (A), D48.2 (A), D50.2 (A), D52.2 (A), D54.2 (A), D56.2 (A), D58.2 (A), D60.2 (A), D62.2 (A), D64.2 (A), D66.2 (A), D68.2 (A), D70.2 (A), D72.2 (A), D74.2 (A), D76.2 (A), D78.2 (A), D80.2 (A), D82.2 (A), D84.2 (A), D86.2 (A), D88.2 (A), D90.2 (A), D92.2 (A), D94.2 (A), D96.2 (A), H1.1
BLANK/D10: J1.4, U1.23 (BLANK), U2.23 (BLANK), U3.23 (BLANK)
D0: D1.1 (K), U1.28 (OUT0)
D1: D3.1 (K), U1.1 (OUT1)
D2: D5.1 (K), U1.2 (OUT2)
D3: D7.1 (K), U1.3 (OUT3)
D4: D9.1 (K), U1.4 (OUT4)
D5: D11.1 (K), U1.5 (OUT5)
D6: D13.1 (K), U1.6 (OUT6)
D7: D15.1 (K), U1.7 (OUT7)
D8: D17.1 (K), U1.8 (OUT8)
D9: D19.1 (K), U1.9 (OUT9)
D10: D21.1 (K), U1.10 (OUT10)
D11: D23.1 (K), U1.11 (OUT11)
D12: D25.1 (K), U1.12 (OUT12)
D13: D27.1 (K), U1.13 (OUT13)
D14: D29.1 (K), U1.14 (OUT14)
D15: D31.1 (K), U1.15 (OUT15)
D16: D33.1 (K), U2.28 (OUT0)
D17: D35.1 (K), U2.1 (OUT1)
D18: D37.1 (K), U2.2 (OUT2)
D19: D39.1 (K), U2.3 (OUT3)
D20: D41.1 (K), U2.4 (OUT4)
D21: D43.1 (K), U2.5 (OUT5)
D22: D45.1 (K), U2.6 (OUT6)
D23: D47.1 (K), U2.7 (OUT7)
D24: D49.1 (K), U2.8 (OUT8)
D25: D51.1 (K), U2.9 (OUT9)
D26: D53.1 (K), U2.10 (OUT10)
D27: D55.1 (K), U2.11 (OUT11)
D28: D57.1 (K), U2.12 (OUT12)
D29: D59.1 (K), U2.13 (OUT13)
D30: D61.1 (K), U2.14 (OUT14)
D31: D63.1 (K), U2.15 (OUT15)
D32: D65.1 (K), U3.28 (OUT0)
D33: D67.1 (K), U3.1 (OUT1)
D34: D69.1 (K), U3.2 (OUT2)
D35: D71.1 (K), U3.3 (OUT3)
D36: D73.1 (K), U3.4 (OUT4)
D37: D75.1 (K), U3.5 (OUT5)
D38: D77.1 (K), U3.6 (OUT6)
D39: D79.1 (K), U3.7 (OUT7)
D40: D81.1 (K), U3.8 (OUT8)
D41: D83.1 (K), U3.9 (OUT9)
D42: D85.1 (K), U3.10 (OUT10)
D43: D87.1 (K), U3.11 (OUT11)
D44: D89.1 (K), U3.12 (OUT12)
D45: D91.1 (K), U3.13 (OUT13)
D46: D93.1 (K), U3.14 (OUT14)
D47: D95.1 (K), U3.15 (OUT15)
DIN/D11: J1.5, U1.26 (SIN)
GND: C1.1, C2.1, C3.1, H2.1, R1.1, R2.1, R3.1, U1.22 (GND), U1.27 (VPRG), U2.22 (GND), U2.27 (VPRG), U3.22 (GND), U3.27 (VPRG)
GSCLK/D3: J1.2, U1.18 (GSCLK), U2.18 (GSCLK), U3.18 (GSCLK)
unnamed: D1.2 (A), D2.1 (K)
unnamed: D3.2 (A), D4.1 (K)
unnamed: D5.2 (A), D6.1 (K)
unnamed: D7.2 (A), D8.1 (K)
unnamed: D9.2 (A), D10.1 (K)
unnamed: D11.2 (A), D12.1 (K)
unnamed: D13.2 (A), D14.1 (K)
unnamed: D15.2 (A), D16.1 (K)
unnamed: D17.2 (A), D18.1 (K)
unnamed: D19.2 (A), D20.1 (K)
unnamed: D21.2 (A), D22.1 (K)
unnamed: D23.2 (A), D24.1 (K)
unnamed: D25.2 (A), D26.1 (K)
unnamed: D27.2 (A), D28.1 (K)
unnamed: D29.2 (A), D30.1 (K)
unnamed: D31.2 (A), D32.1 (K)
unnamed: D33.2 (A), D34.1 (K)
unnamed: D35.2 (A), D36.1 (K)
unnamed: D37.2 (A), D38.1 (K)
unnamed: D39.2 (A), D40.1 (K)
unnamed: D41.2 (A), D42.1 (K)
unnamed: D43.2 (A), D44.1 (K)
unnamed: D45.2 (A), D46.1 (K)
unnamed: D47.2 (A), D48.1 (K)
unnamed: D49.2 (A), D50.1 (K)
unnamed: D51.2 (A), D52.1 (K)
unnamed: D53.2 (A), D54.1 (K)
unnamed: D55.2 (A), D56.1 (K)
unnamed: D57.2 (A), D58.1 (K)
unnamed: D59.2 (A), D60.1 (K)
unnamed: D61.2 (A), D62.1 (K)
unnamed: D63.2 (A), D64.1 (K)
unnamed: D65.2 (A), D66.1 (K)
unnamed: D67.2 (A), D68.1 (K)
unnamed: D69.2 (A), D70.1 (K)
unnamed: D71.2 (A), D72.1 (K)
unnamed: D73.2 (A), D74.1 (K)
unnamed: D75.2 (A), D76.1 (K)
unnamed: D77.2 (A), D78.1 (K)
unnamed: D79.2 (A), D80.1 (K)
unnamed: D81.2 (A), D82.1 (K)
unnamed: D83.2 (A), D84.1 (K)
unnamed: D85.2 (A), D86.1 (K)
unnamed: D87.2 (A), D88.1 (K)
unnamed: D89.2 (A), D90.1 (K)
unnamed: D91.2 (A), D92.1 (K)
unnamed: D93.2 (A), D94.1 (K)
unnamed: D95.2 (A), D96.1 (K)
unnamed: R1.2, U1.20 (IREF)
unnamed: R2.2, U2.20 (IREF)
unnamed: R3.2, U3.20 (IREF)
unnamed: U1.17 (SOUT), U2.26 (SIN)
unnamed: U2.17 (SOUT), U3.26 (SIN)
SCLK/D13: J1.6, U1.25 (SCLK), U2.25 (SCLK), U3.25 (SCLK)
XLAT/D9: J1.3, U1.24 (XLAT), U2.24 (XLAT), U3.24 (XLAT)

Notes on the sheet:
Enable Pull-Up Resistor on D10

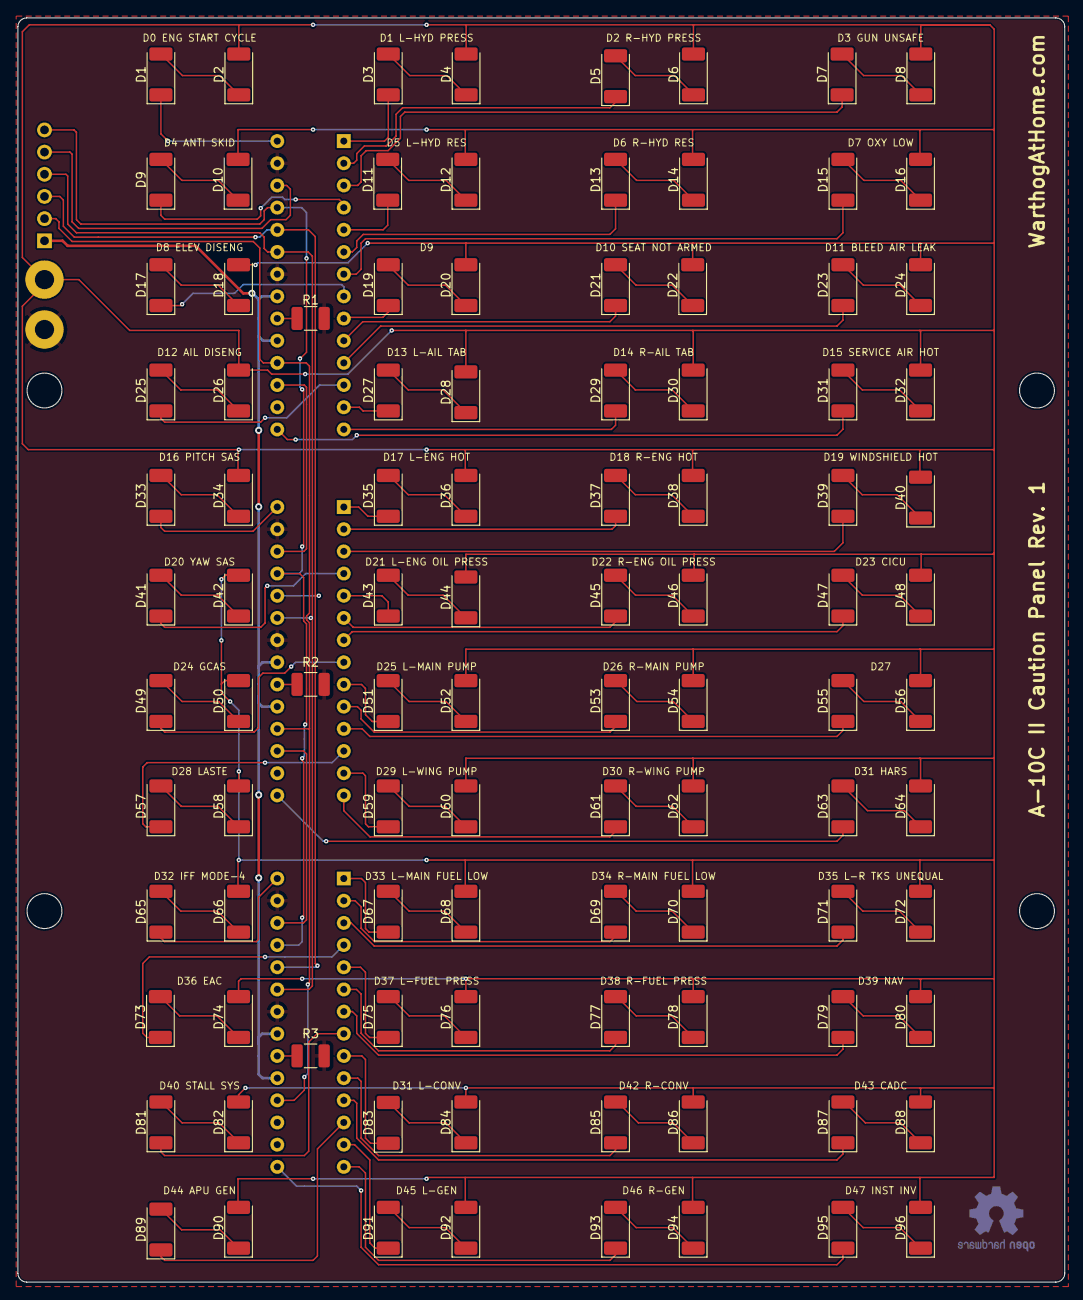
[picture p58: board Caution Panel.kicad_pcb from above]

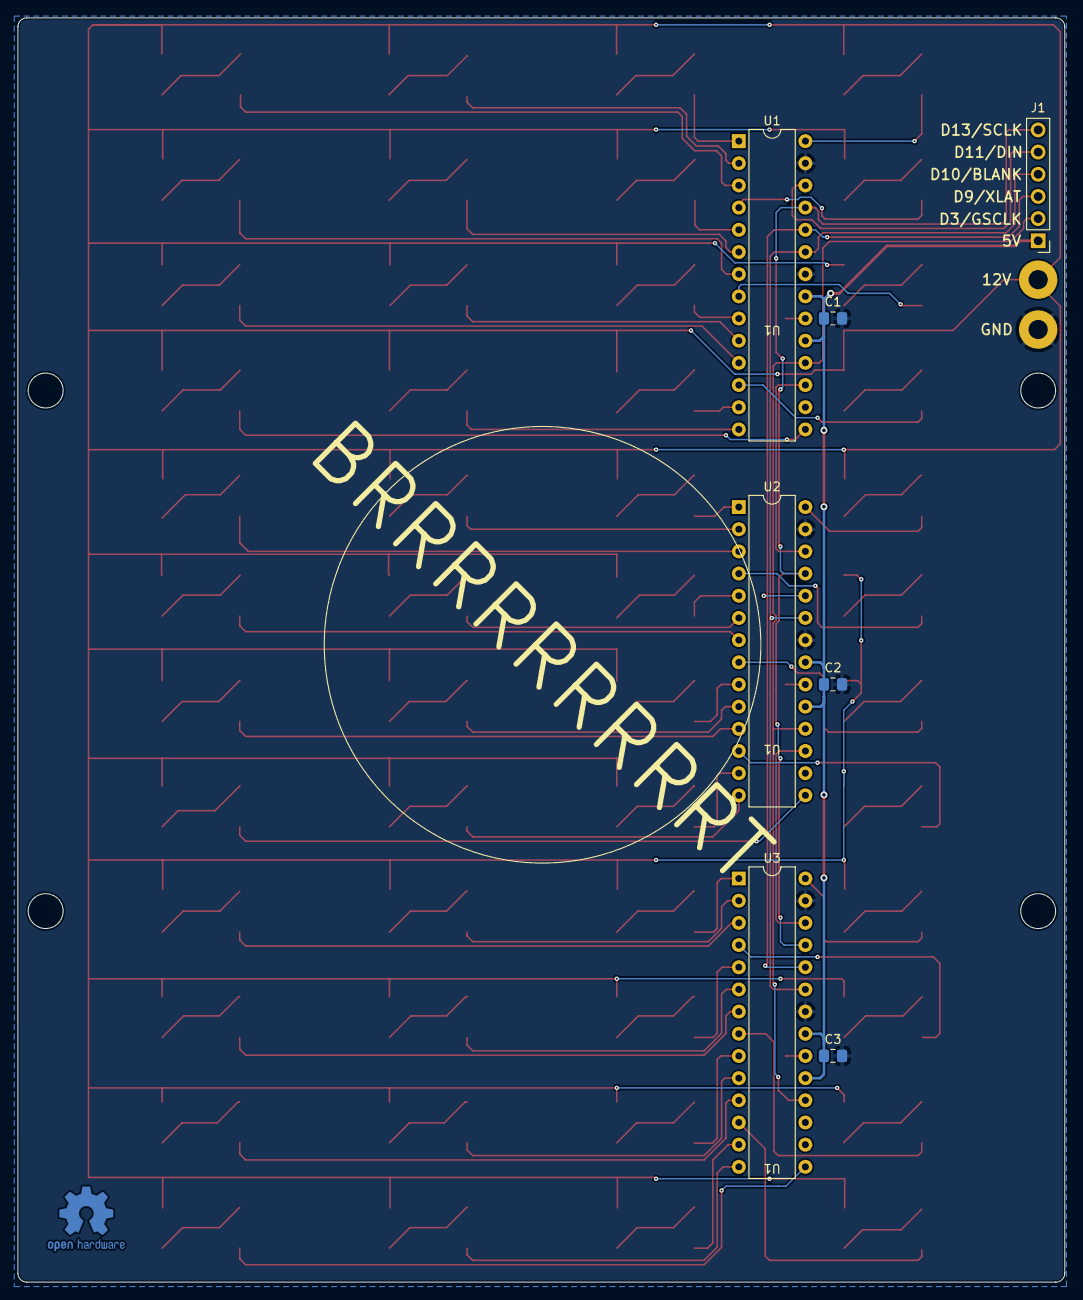
[picture p59: board Caution Panel.kicad_pcb from below]

Board: 2 copper layers, 119.9 x 144.8 mm, 112 parts (7 on the bottom side), 109 nets.
