maciekish/warthogathome/PCBs/Slaves/Nano Shield/Nano Shield.kicad_pcb

## KiCad design PCBs/Slaves/Nano Shield/Nano Shield.kicad_pcb (2022-09-08)

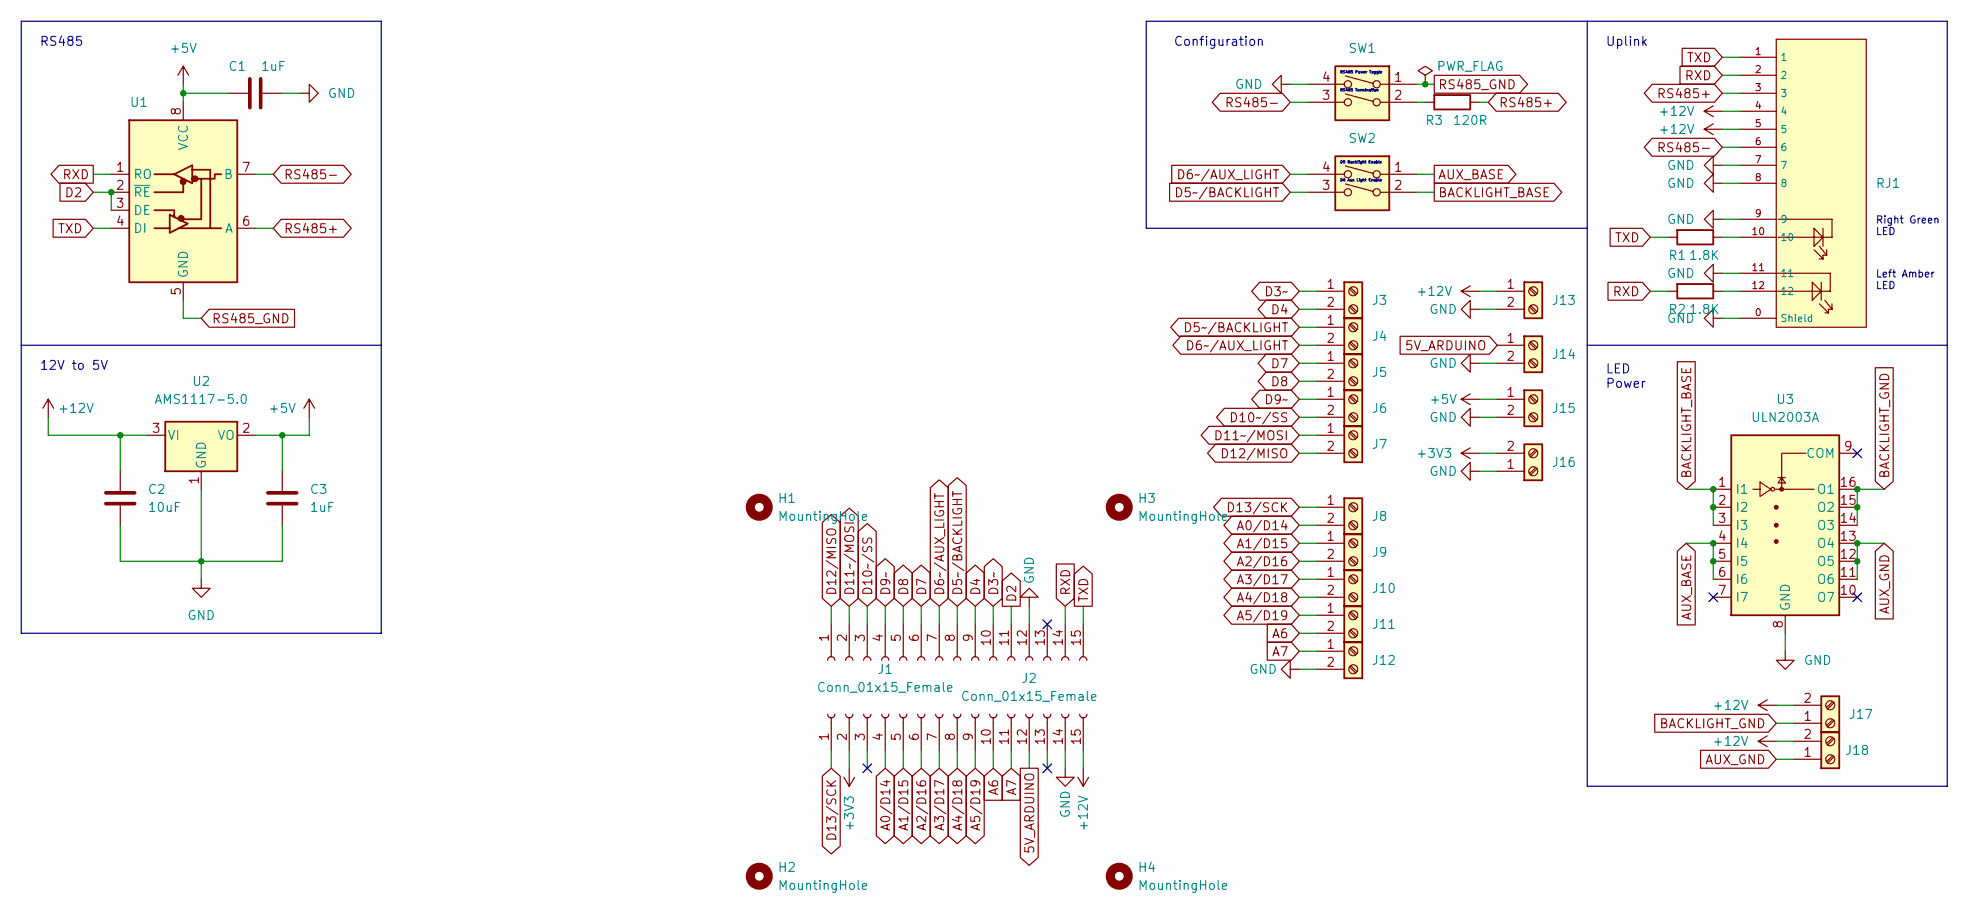
[picture p60: schematic Nano Shield.kicad_sch]

Parts:
C1, C3: 1uF; C0402; LCSC C52923
C2: 10uF; C0402; LCSC C15525
H1, H2, H3, H4: MountingHole; MountingHole_3.2mm_M3
J1, J2: Conn_01x15_Female; PinSocket_1x15_P2.54mm_Vertical
J3, J4, J5, J6, J7, J8, J9, J10, J11, J12, J13, J14, J15, J16, J17, J18: Screw_Terminal_01x02; CONN-TH_WJ126V-5.0-2P; LCSC C557685
R1, R2: 1.8K; R_0805_2012Metric; LCSC C17398
R3: 120R; R_0805_2012Metric; LCSC C17437
RJ1: RJ45-B-1*1; RJ45-TH_B-1-1; LCSC C138392
SW1, SW2: SW_DIP_x02; SW-SMD_DSHP02TSGER; LCSC C367376
U1: MAX487ESA+T; SOIC-8_L5.0-W4.0-P1.27-LS6.0-BL; LCSC C9953
U2: AMS1117-5.0; SOT-223-3_TabPin2; LCSC C6187
U3: ULN2003A; SOP-16_L10.0-W3.9-P1.27-LS6.0-BL; LCSC C7512

Connections:
5V_ARDUINO: J2.12, J14.1
+3V3: J2.2, J16.2
+5V: C1.1, C3.1, J15.1, U1.8 (VCC), U2.2 (VO)
+12V: C2.1, J2.15, J13.1, J17.2, J18.2, RJ1.4, RJ1.5, U2.3 (VI)
A0/D14: J2.4, J8.2
A1/D15: J2.5, J9.1
A2/D16: J2.6, J9.2
A3/D17: J2.7, J10.1
A4/D18: J2.8, J10.2
A5/D19: J2.9, J11.1
A6: J2.10, J11.2
A7: J2.11, J12.1
AUX_BASE: SW2.1, U3.4 (I4), U3.5 (I5), U3.6 (I6)
AUX_GND: J18.1, U3.11 (O6), U3.12 (O5), U3.13 (O4)
BACKLIGHT_BASE: SW2.2, U3.1 (I1), U3.2 (I2), U3.3 (I3)
BACKLIGHT_GND: J17.1, U3.14 (O3), U3.15 (O2), U3.16 (O1)
D2: J1.11, U1.2 (~RE), U1.3 (DE)
D3~: J1.10, J3.1
D4: J1.9, J3.2
D5~/BACKLIGHT: J1.8, J4.1, SW2.3
D6~/AUX_LIGHT: J1.7, J4.2, SW2.4
D7: J1.6, J5.1
D8: J1.5, J5.2
D9~: J1.4, J6.1
D10~/SS: J1.3, J6.2
D11~/MOSI: J1.2, J7.1
D12/MISO: J1.1, J7.2
D13/SCK: J2.1, J8.1
GND: C1.2, C2.2, C3.2, J1.12, J2.14, J12.2, J13.2, J14.2, J15.2, J16.1, RJ1.0 (Shield), RJ1.7, RJ1.8, RJ1.9, RJ1.11, SW1.4, U2.1 (GND), U3.8 (GND)
unnamed: R1.1, RJ1.10
unnamed: R2.1, RJ1.12
unnamed: R3.2, SW1.2
RS485+: R3.1, RJ1.3, U1.6 (A)
RS485-: RJ1.6, SW1.3, U1.7 (B)
RS485_GND: SW1.1, U1.5 (GND)
RXD: J1.14, R2.2, RJ1.2, U1.1 (RO)
TXD: J1.15, R1.2, RJ1.1, U1.4 (DI)

Notes on the sheet:
D5 Backlight Enable
LED Power
Right Green LED
RS485 Power Toggle
Uplink
12V to 5V
D6 Aux Light Enable
Left Amber LED
RS485 Termination
Configuration
RS485

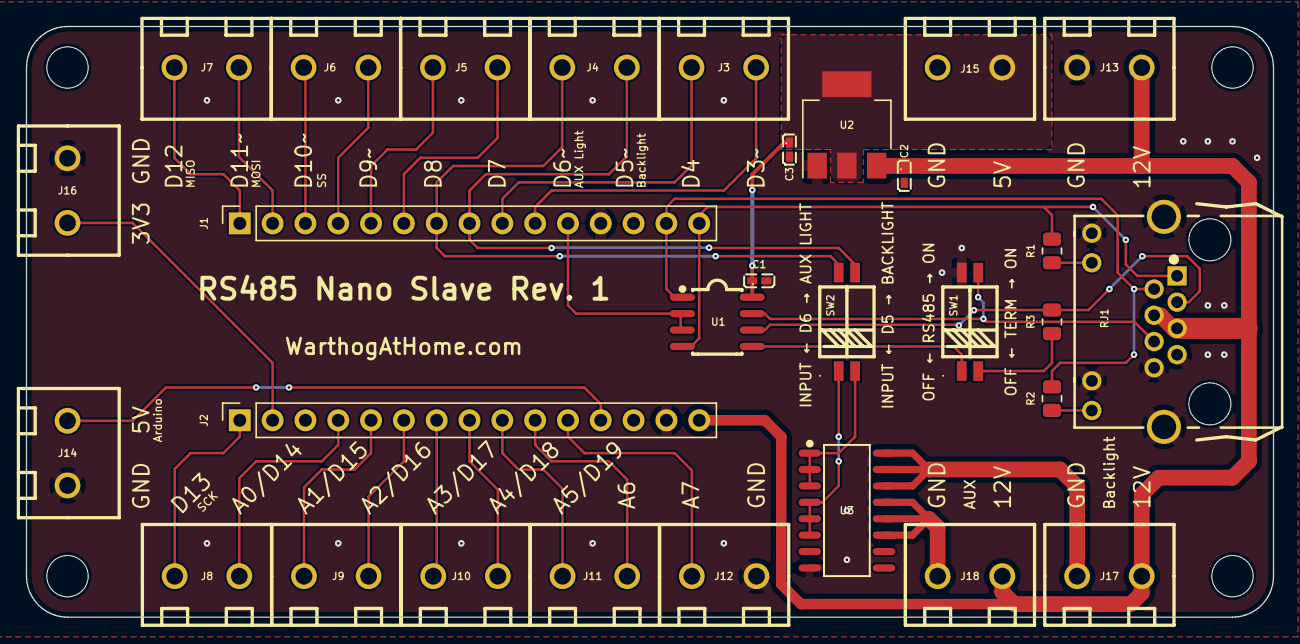
[picture p61: board Nano Shield.kicad_pcb from above]

Board: 2 copper layers, 96.5 x 45.7 mm, 34 parts (0 on the bottom side), 37 nets.
