maciekish/warthogathome/PCBs/Slaves/Nano Slave/Nano Slave.kicad_pcb

## KiCad design PCBs/Slaves/Nano Slave/Nano Slave.kicad_pcb (2022-09-12)

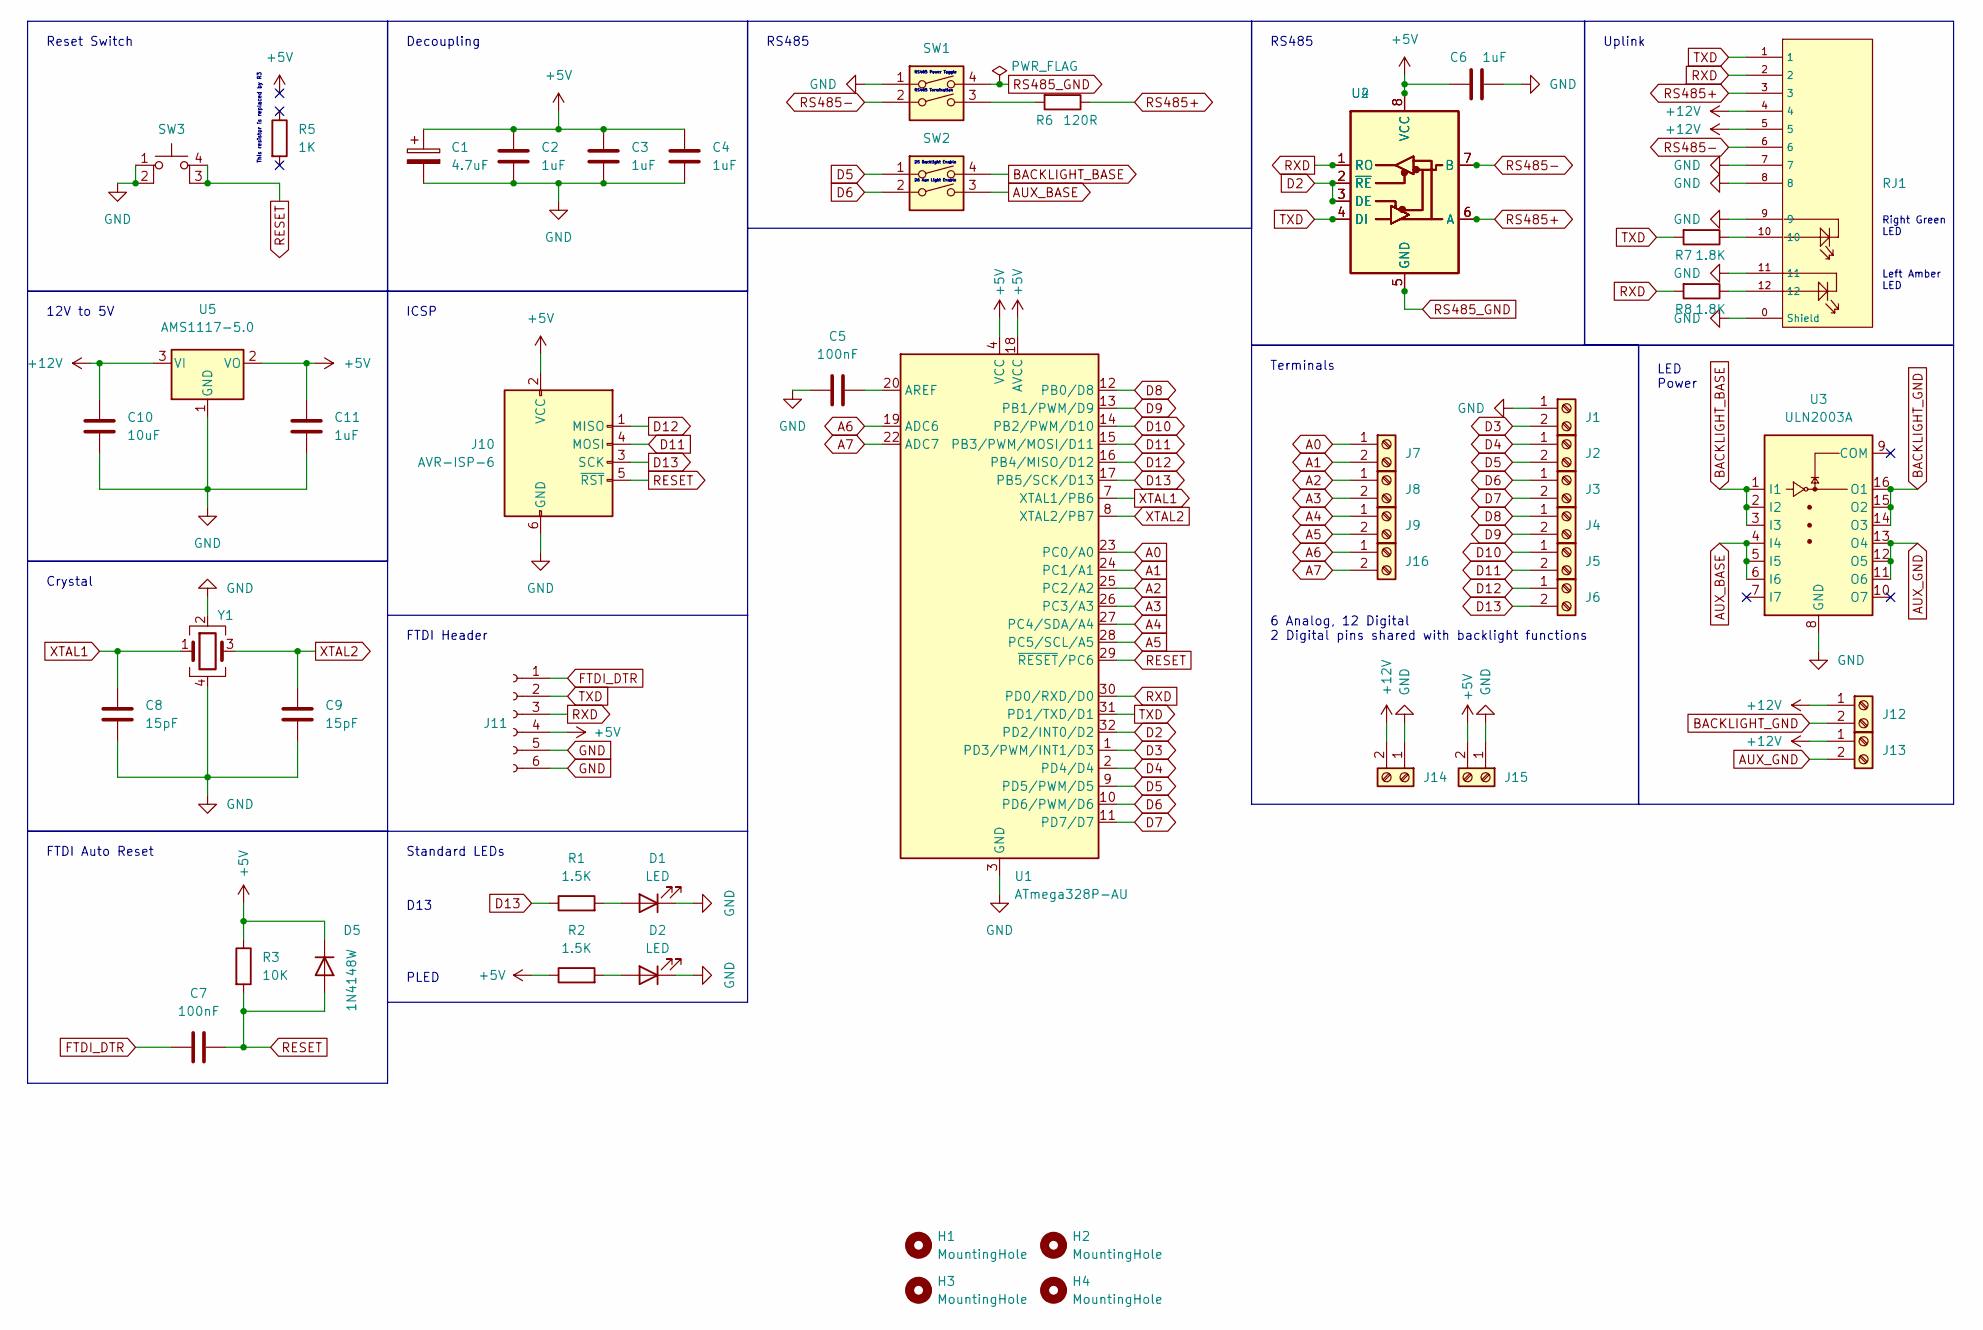
[picture p62: schematic Nano Slave.kicad_sch]

Parts:
C1: 4.7uF; C0805; LCSC C1779
C2, C3, C4, C6, C11: 1uF; C0402; LCSC C52923
C5, C7: 100nF; C0402; LCSC C1525
C8, C9: 15pF; C0402; LCSC C1548
C10: 10uF; C0402; LCSC C15525
D1, D2: LED; LED_0603_1608Metric; LCSC C72041
D5: 1N4148W; D_SOD-123; LCSC C81598
H1, H2, H3, H4: MountingHole; MountingHole_3.2mm_M3
J1, J2, J3, J4, J5, J6, J7, J8, J9, J12, J13, J14, J15, J16: Screw_Terminal_01x02; CONN-TH_WJ126V-5.0-2P; LCSC C8404
J10: AVR-ISP-6; PinHeader_2x03_P2.54mm_Vertical; LCSC C492420
J11: Conn_01x06_Female; PinSocket_1x06_P2.54mm_Vertical; LCSC C40877
R1, R2: 1.5K; R_0805_2012Metric; LCSC C4310
R3: 10K; R_0805_2012Metric; LCSC C17414
R5: 1K; R_0805_2012Metric; LCSC C17513
R6: 120R; R_0805_2012Metric; LCSC C17437
R7, R8: 1.8K; R_0805_2012Metric; LCSC C17398
RJ1: RJ45-B-1*1; RJ45-TH_B-1-1; LCSC C138392
SW1, SW2: SW_DIP_x02; SW-SMD_DSHP02TSGER; LCSC C367376
SW3: SW_MEC_5E; SW-SMD_4P-L5.1-W5.1-P3.70-LS6.5-TL-2; LCSC C318884
U1: ATmega328P-AU; TQFP-32_7x7mm_P0.8mm; LCSC C14877
U2: MAX487ESA+T; SOIC-8_L5.0-W4.0-P1.27-LS6.0-BL; LCSC C9953
U3: ULN2003A; SOP-16_L10.0-W3.9-P1.27-LS6.0-BL; LCSC C7512
U4: MAX487CPA+; DIP-8_W7.62mm
U5: AMS1117-5.0; SOT-223-3_TabPin2; LCSC C6187
Y1: Crystal_GND24; Crystal_SMD_3225-4Pin_3.2x2.5mm; LCSC C13738

Connections:
+5V: C1.1, C2.1, C3.1, C4.1, C6.1, C11.1, D5.1 (K), J10.2 (VCC), J11.4, J15.2, R2.1, R3.1, U1.4 (VCC), U1.6 (VCC), U1.18 (AVCC), U2.8 (VCC), U4.8 (VCC), U5.2 (VO)
+12V: C10.1, J12.1, J13.1, J14.2, RJ1.4, RJ1.5, U5.3 (VI)
A0: J7.1, U1.23 (PC0/A0)
A1: J7.2, U1.24 (PC1/A1)
A2: J8.1, U1.25 (PC2/A2)
A3: J8.2, U1.26 (PC3/A3)
A4: J9.1, U1.27 (PC4/SDA/A4)
A5: J9.2, U1.28 (PC5/SCL/A5)
A6: J16.1, U1.19 (ADC6)
A7: J16.2, U1.22 (ADC7)
AUX_BASE: SW2.3, U3.4 (I4), U3.5 (I5), U3.6 (I6)
AUX_GND: J13.2, U3.11 (O6), U3.12 (O5), U3.13 (O4)
BACKLIGHT_BASE: SW2.4, U3.1 (I1), U3.2 (I2), U3.3 (I3)
BACKLIGHT_GND: J12.2, U3.14 (O3), U3.15 (O2), U3.16 (O1)
D2: U1.32 (PD2/INT0/D2), U2.2 (~RE), U2.3 (DE), U4.2 (~RE), U4.3 (DE)
D3: J1.2, U1.1 (PD3/PWM/INT1/D3)
D4: J2.1, U1.2 (PD4/D4)
D5: J2.2, SW2.1, U1.9 (PD5/PWM/D5)
D6: J3.1, SW2.2, U1.10 (PD6/PWM/D6)
D7: J3.2, U1.11 (PD7/D7)
D8: J4.1, U1.12 (PB0/D8)
D9: J4.2, U1.13 (PB1/PWM/D9)
D10: J5.1, U1.14 (PB2/PWM/D10)
D11: J5.2, J10.4 (MOSI), U1.15 (PB3/PWM/MOSI/D11)
D12: J6.1, J10.1 (MISO), U1.16 (PB4/MISO/D12)
D13: J6.2, J10.3 (SCK), R1.1, U1.17 (PB5/SCK/D13)
FTDI_DTR: C7.2, J11.1
GND: C1.2, C2.2, C3.2, C4.2, C5.1, C6.2, C8.1, C9.2, C10.2, C11.2, D1.1 (K), D2.1 (K), J1.1, J10.6 (GND), J11.5, J11.6, J14.1, J15.1, RJ1.0 (Shield), RJ1.7, RJ1.8, RJ1.9, RJ1.11, SW1.1, SW3.1, SW3.2, U1.3 (GND), U1.5 (GND), U1.21 (GND), U3.8 (GND), U5.1 (GND), Y1.2, Y1.4
unnamed: C5.2, U1.20 (AREF)
unnamed: D1.2 (A), R1.2
unnamed: D2.2 (A), R2.2
unnamed: R6.2, SW1.3
unnamed: R7.1, RJ1.10
unnamed: R8.1, RJ1.12
RESET: C7.1, D5.2 (A), J10.5 (~RST), R3.2, SW3.3 (K), SW3.4 (A), U1.29 (~RESET/PC6)
RS485+: R6.1, RJ1.3, U2.6 (A), U4.6 (A)
RS485-: RJ1.6, SW1.2, U2.7 (B), U4.7 (B)
RS485_GND: SW1.4, U2.5 (GND), U4.5 (GND)
RXD: J11.3, R8.2, RJ1.2, U1.30 (PD0/RXD/D0), U2.1 (RO), U4.1 (RO)
TXD: J11.2, R7.2, RJ1.1, U1.31 (PD1/TXD/D1), U2.4 (DI), U4.4 (DI)
XTAL1: C8.2, U1.7 (XTAL1/PB6), Y1.1
XTAL2: C9.1, U1.8 (XTAL2/PB7), Y1.3

Notes on the sheet:
RS485
Decoupling
Left Amber LED
D13
12V to 5V
Uplink
D5 Backlight Enable
RS485 Power Toggle
6 Analog, 12 Digital 2 Digital pins shared with backlight functions
Terminals
RS485 Termination
PLED
FTDI Header
D6 Aux Light Enable
Standard LEDs
LED Power
Right Green LED
FTDI Auto Reset
Reset Switch
Crystal
ICSP
This resistor is replaced by R3

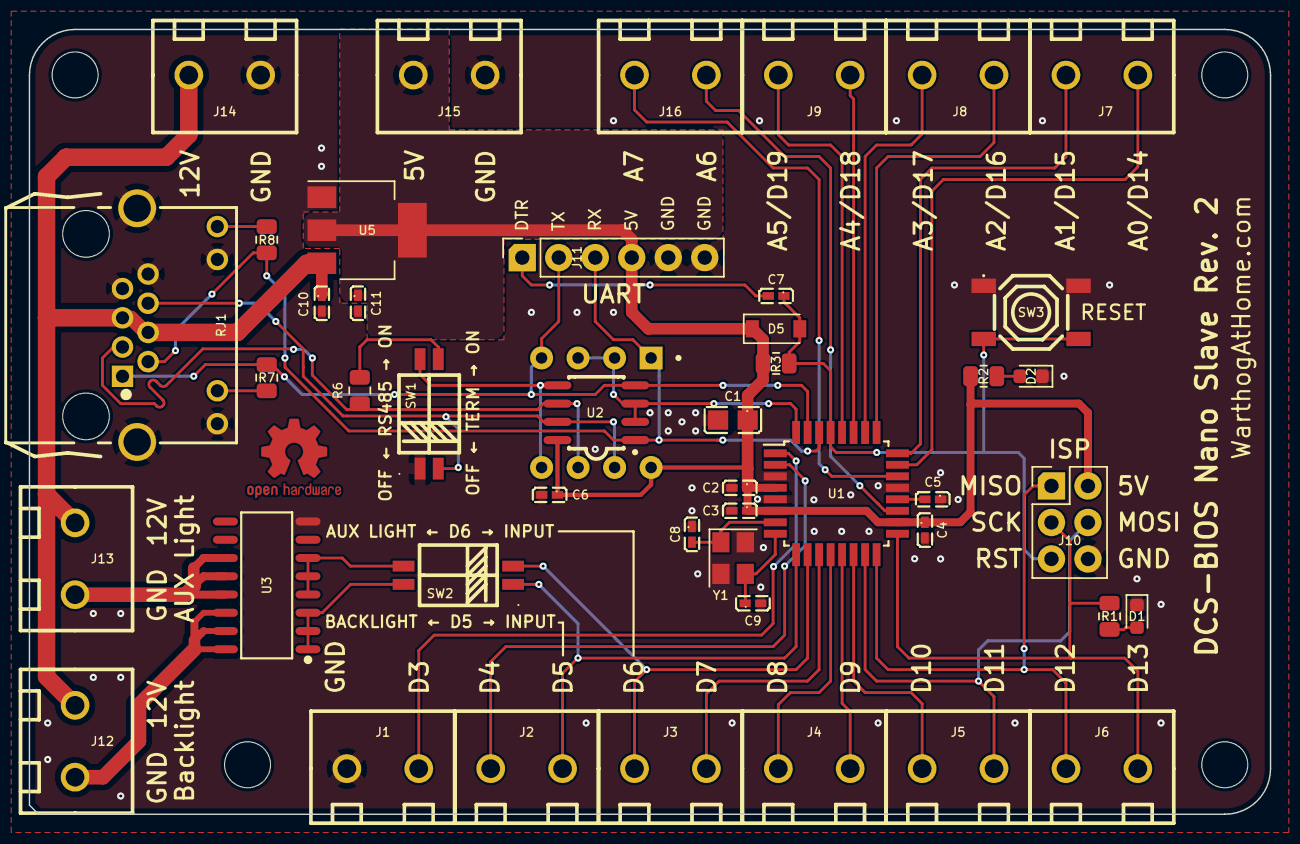
[picture p63: board Nano Slave.kicad_pcb from above]

Board: 2 copper layers, 86.4 x 54.6 mm, 50 parts (0 on the bottom side), 42 nets.
