maciekish/warthogathome/PCBs/Slaves/Mega Shield/Mega Shield.kicad_pcb

## KiCad design PCBs/Slaves/Mega Shield/Mega Shield.kicad_pcb (2022-09-11)

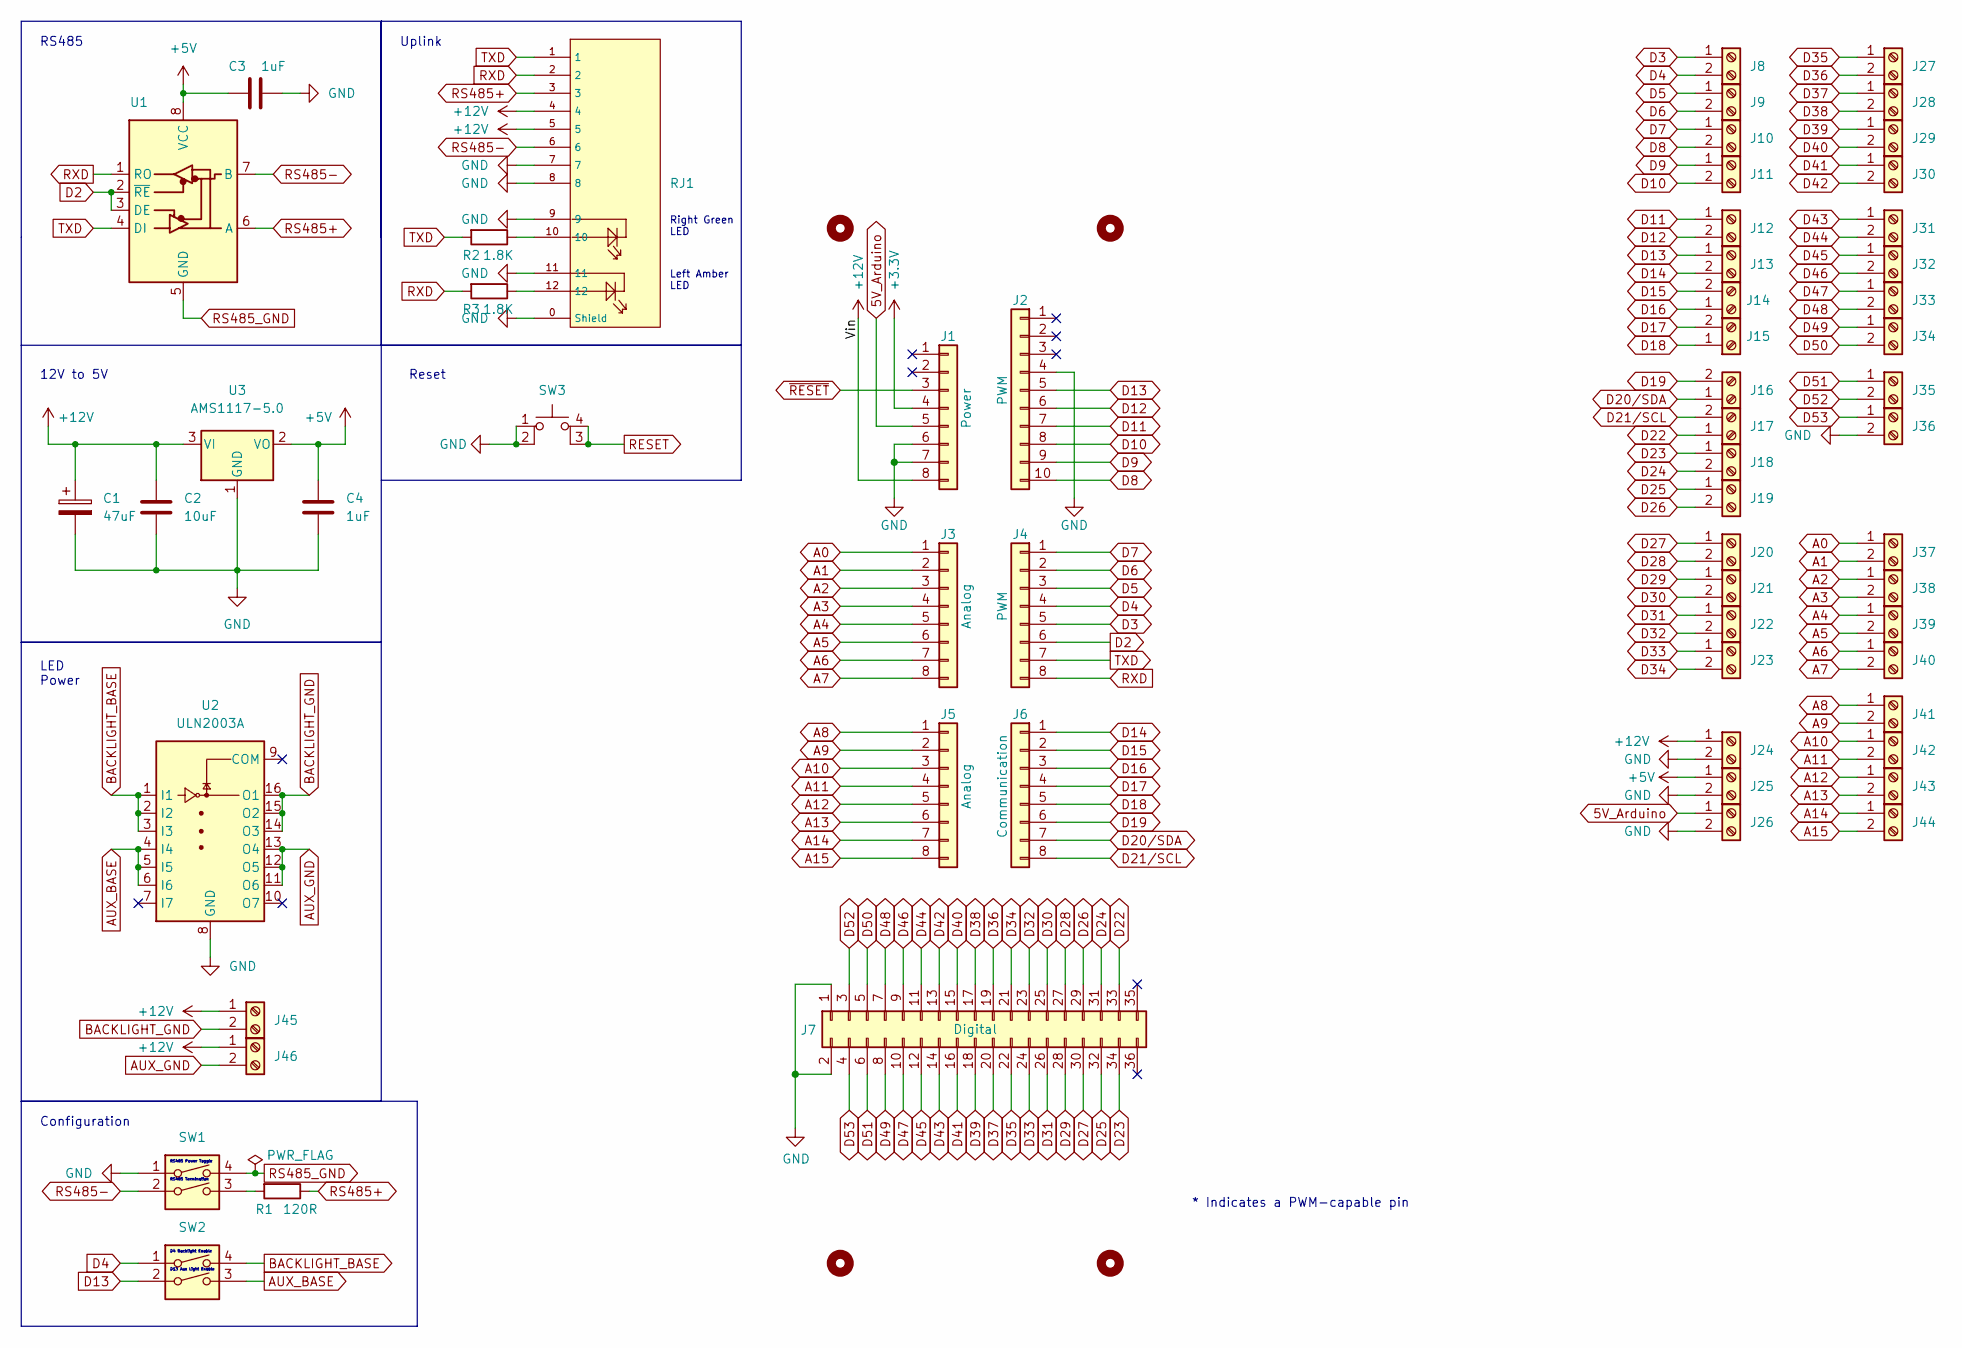
[picture p64: schematic Mega Shield.kicad_sch]

Parts:
C1: 47uF; CP_Elec_5x5.4; LCSC C96178
C2: 10uF; C0402; LCSC C15525
C3, C4: 1uF; C0402; LCSC C52923
H1, H2, H3, H4: MountingHole; MountingHole_3.2mm_M3
J1: Power; PinSocket_1x08_P2.54mm_Vertical
J2: PWM; PinSocket_1x10_P2.54mm_Vertical
J3, J5: Analog; PinSocket_1x08_P2.54mm_Vertical
J4: PWM; PinSocket_1x08_P2.54mm_Vertical
J6: Communication; PinSocket_1x08_P2.54mm_Vertical
J7: Digital; PinSocket_2x18_P2.54mm_Vertical
J8, J9, J10, J11, J12, J13, J14, J15, J16, J17, J18, J19, J20, J21, J22, J23, J24, J25, J26, J27, J28, J29, J30, J31, J32, J33, J34, J35, J36, J37, J38, J39, J40, J41, J42, J43, J44, J45, J46: Screw_Terminal_01x02; CONN-TH_WJ126V-5.0-2P; LCSC C557685
R1: 120R; R_0805_2012Metric; LCSC C17437
R2, R3: 1.8K; R_0805_2012Metric; LCSC C17398
RJ1: RJ45-B-1*1; RJ45-TH_B-1-1; LCSC C138392
SW1, SW2: SW_DIP_x02; SW-SMD_DSHP02TSGER; LCSC C367376
SW3: SW_MEC_5E; SW-SMD_4P-L5.1-W5.1-P3.70-LS6.5-TL-2; LCSC C318884
U1: MAX487ESA+T; SOIC-8_L5.0-W4.0-P1.27-LS6.0-BL; LCSC C9953
U2: ULN2003A; SOP-16_L10.0-W3.9-P1.27-LS6.0-BL; LCSC C7512
U3: AMS1117-5.0; SOT-223-3_TabPin2; LCSC C6187

Connections:
5V_Arduino: J1.5, J26.1
+3V3: J1.4
+5V: C3.1, C4.1, J25.1, U1.8 (VCC), U3.2 (VO)
+12V: C1.1, C2.1, J1.8, J24.1, J45.1, J46.1, RJ1.4, RJ1.5, U3.3 (VI)
A0: J3.1, J37.1
A1: J3.2, J37.2
A2: J3.3, J38.1
A3: J3.4, J38.2
A4: J3.5, J39.1
A5: J3.6, J39.2
A6: J3.7, J40.1
A7: J3.8, J40.2
A8: J5.1, J41.1
A9: J5.2, J41.2
A10: J5.3, J42.1
A11: J5.4, J42.2
A12: J5.5, J43.1
A13: J5.6, J43.2
A14: J5.7, J44.1
A15: J5.8, J44.2
AUX_BASE: SW2.3, U2.4 (I4), U2.5 (I5), U2.6 (I6)
AUX_GND: J46.2, U2.11 (O6), U2.12 (O5), U2.13 (O4)
BACKLIGHT_BASE: SW2.4, U2.1 (I1), U2.2 (I2), U2.3 (I3)
BACKLIGHT_GND: J45.2, U2.14 (O3), U2.15 (O2), U2.16 (O1)
D2: J4.6, U1.2 (~RE), U1.3 (DE)
D3: J4.5, J8.1
D4: J4.4, J8.2, SW2.1
D5: J4.3, J9.1
D6: J4.2, J9.2
D7: J4.1, J10.1
D8: J2.10, J10.2
D9: J2.9, J11.1
D10: J2.8, J11.2
D11: J2.7, J12.1
D12: J2.6, J12.2
D13: J2.5, J13.1, SW2.2
D14: J6.1, J13.2
D15: J6.2, J14.2
D16: J6.3, J14.1
D17: J6.4, J15.2
D18: J6.5, J15.1
D19: J6.6, J16.2
D20/SDA: J6.7, J16.1
D21/SCL: J6.8, J17.2
D22: J7.33, J17.1
D23: J7.34, J18.1
D24: J7.31, J18.2
D25: J7.32, J19.1
D26: J7.29, J19.2
D27: J7.30, J20.1
D28: J7.27, J20.2
D29: J7.28, J21.1
D30: J7.25, J21.2
D31: J7.26, J22.1
D32: J7.23, J22.2
D33: J7.24, J23.1
D34: J7.21, J23.2
D35: J7.22, J27.1
D36: J7.19, J27.2
D37: J7.20, J28.1
D38: J7.17, J28.2
D39: J7.18, J29.1
D40: J7.15, J29.2
D41: J7.16, J30.1
D42: J7.13, J30.2
D43: J7.14, J31.1
D44: J7.11, J31.2
D45: J7.12, J32.1
D46: J7.9, J32.2
D47: J7.10, J33.1
D48: J7.7, J33.2
D49: J7.8, J34.1
D50: J7.5, J34.2
D51: J7.6, J35.1
D52: J7.3, J35.2
D53: J7.4, J36.1
GND: C1.2, C2.2, C3.2, C4.2, J1.6, J1.7, J2.4, J7.1, J7.2, J24.2, J25.2, J26.2, J36.2, RJ1.0 (Shield), RJ1.7, RJ1.8, RJ1.9, RJ1.11, SW1.1, SW3.1, SW3.2, U2.8 (GND), U3.1 (GND)
unnamed: R1.2, SW1.3
unnamed: R2.1, RJ1.10
unnamed: R3.1, RJ1.12
RESET: SW3.3 (K), SW3.4 (A)
RS485+: R1.1, RJ1.3, U1.6 (A)
RS485-: RJ1.6, SW1.2, U1.7 (B)
RS485_GND: SW1.4, U1.5 (GND)
RXD: J4.8, R3.2, RJ1.2, U1.1 (RO)
TXD: J4.7, R2.2, RJ1.1, U1.4 (DI)
~RESET: J1.3

Notes on the sheet:
Uplink
12V to 5V
D4 Backlight Enable
RS485 Power Toggle
Right Green LED
D13 Aux Light Enable
Reset
RS485
Configuration
RS485 Termination
* Indicates a PWM-capable pin
LED Power
Left Amber LED

Board: 2 copper layers, 70 parts (0 on the bottom side), 85 nets, no tracks yet.

Other parts of the board:
MH1, MH2, MH3, MH4, MH5, MH6: MountingHole_3.2mm
