maciekish/warthogathome/Arduino/Examples/pararell_tft_display_HX8357/CDU_Font.h

const uint8_t CDU_Bitmaps[] PROGMEM = {
  0xFA, 0xFA, 0xB4, 0x57, 0xD5, 0xF5, 0x00, 0xC0, 0x2A, 0x48, 0x88, 0x88, 
  0x92, 0xA0, 0x51, 0x3E, 0x45, 0x00, 0x21, 0x3E, 0x42, 0x00, 0xC0, 0xF8, 
  0x80, 0x08, 0x88, 0x88, 0x00, 0x74, 0x67, 0x5C, 0xC5, 0xC0, 0x59, 0x24, 
  0xB8, 0x74, 0x42, 0xE8, 0x43, 0xE0, 0xF8, 0x44, 0x60, 0xC5, 0xC0, 0x11, 
  0x95, 0x2F, 0x88, 0x40, 0xFC, 0x3C, 0x10, 0xC5, 0xC0, 0x3A, 0x21, 0xE8, 
  0xC5, 0xC0, 0xF8, 0x44, 0x44, 0x42, 0x00, 0x74, 0x62, 0xE8, 0xC5, 0xC0, 
  0x74, 0x62, 0xF0, 0x8B, 0x80, 0xA0, 0xB0, 0x2A, 0x22, 0xF8, 0x3E, 0x88, 
  0xA8, 0x74, 0x44, 0x42, 0x00, 0x80, 0x74, 0x63, 0x7B, 0xC5, 0xC0, 0x74, 
  0x63, 0x1F, 0xC6, 0x20, 0xF4, 0x63, 0xE8, 0xC7, 0xC0, 0x74, 0x61, 0x08, 
  0x45, 0xC0, 0xF4, 0x63, 0x18, 0xC7, 0xC0, 0xFC, 0x21, 0xE8, 0x43, 0xE0, 
  0xFC, 0x21, 0xE8, 0x42, 0x00, 0x74, 0x61, 0x09, 0xC5, 0xE0, 0x8C, 0x63, 
  0xF8, 0xC6, 0x20, 0xE9, 0x24, 0xB8, 0x08, 0x42, 0x10, 0xC5, 0xC0, 0x8C, 
  0xA9, 0x8A, 0x4A, 0x20, 0x84, 0x21, 0x08, 0x43, 0xE0, 0x8E, 0xEB, 0x58, 
  0xC6, 0x20, 0x8C, 0x73, 0x59, 0xC6, 0x20, 0x74, 0x63, 0x18, 0xC5, 0xC0, 
  0xF4, 0x63, 0xE8, 0x42, 0x00, 0x74, 0x63, 0x18, 0xB8, 0x20, 0xF4, 0x63, 
  0xEA, 0x4A, 0x20, 0x74, 0x60, 0xE0, 0xC5, 0xC0, 0xF9, 0x08, 0x42, 0x10, 
  0x80, 0x8C, 0x63, 0x18, 0xC5, 0xC0, 0x8C, 0x62, 0xA5, 0x10, 0x80, 0x8C, 
  0x63, 0x5A, 0xD5, 0x40, 0x8C, 0x54, 0x45, 0x46, 0x20, 0x8C, 0x54, 0x42, 
  0x10, 0x80, 0xF8, 0x44, 0x44, 0x43, 0xE0, 0xF8, 0x88, 0x88, 0xF0, 0x82, 
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
  {   269,   0,   0,   0,    0,    0 },   // 0xB7 '·'
  {   269,   0,   0,   0,    0,    0 },   // 0xB8 '¸'
  {   269,   0,   0,   0,    0,    0 },   // 0xB9 '¹'
  {   269,   0,   0,   0,    0,    0 },   // 0xBA 'º'
  {   269,   5,   5,   6,    0,   -6 }    // 0xBB '»'
};

const GFXfont CDU PROGMEM = {(uint8_t *) CDU_Bitmaps,     (GFXglyph *)CDU_Glyphs, 0x20, 0xBB,     8};
