maciekish/warthogathome/Arduino/Examples/4wirespi_CMSP/CMSP_Large_font.h

/*
  Fontname: CMSP Large
  Copyright: Created with Fony 1.4.7
  Glyphs: 224/256
  BBX Build Mode: 0
*/
const uint8_t CMSP_Large_font[1906] U8G2_FONT_SECTION("CMSP_Large_font") = 
  "\340\0\4\4\4\5\4\5\6\15\23\0\371\14\14\14\14\1\232\3\231\7U \6\0\220\303\0!\6\0"
  "\220\303\0\42\6\0\220\303\0#\6\0\220\303\0$\6\0\220\303\0%\6\0\220\303\0&\6\0\220\303"
  "\0'\6\0\220\303\0(\6\0\220\303\0)\6\0\220\303\0*\6\0\220\303\0+\6\0\220\303\0,"
  "\7S:\301\360\0-\10\71\64\302\360\200\1.\7\63:\301\220\0/\24=\61\301:\303\241\23\16\235"
  "\341\320\11\207N\70tR\0\60\30=\61\301s\354\232q\66\312d\311\220%\211\22\231\263n\314\261k"
  "\0\61\16\71\65\301\63l\214\315\346\177\363\200\1\62\25=\61\301s\354\232q\326\15\235\315\261k\206\316"
  "\364\301\203\4\63\27=\61\301s\354\232q\326\15\235\310\234\325C\315Y\67\346\330\65\0\64\31=\61\301"
  ":;\33\215\31\64f\320\230\21\303F\14\33\61\354\301\3\246s\65\25=\61\301\360\1\323I\325h="
  "tRs\326\215\71v\15\0\66\24=\61\301\203\12\223\241\223\252\321f\234}\67\346\330\65\0\67\20="
  "\61\301\360A\322y\67t\272\241\363\63\0\70\25=\61\301s\354\232qv\67\346\330\65\343\354n\314\261"
  "k\0\71\22=\61\301s\354\232q\366\335\30\235\316\4\25\66\0:\10\223\232\301\220\62\1;\16\306\64"
  "\301\63{`c\306\230\231\6\0<\20\371\66\301\66\233a\323\14\233r\330\224\303&=\11\232\226\301\360"
  "=\4\37>\22\371\70\301\60l\312aS\16\233f\330\64\303&\3\77\26=\61\301s\354\232q\326\15"
  "\235n\350\204C\247\207l\350T\0@\6\0\220\303\0A\20=\61\301s\354\232q\366w\17\276\263\335"
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
  "\303\0\364\6\0\220\303\0\365\6\0\220\303\0\366\6\0\220\303\0\367\6\0\220\303\0\370\6\0\220\303\0"
  "\371\6\0\220\303\0\372\6\0\220\303\0\373\6\0\220\303\0\374\6\0\220\303\0\375\6\0\220\303\0\376\6"
  "\0\220\303\0\377\6\0\220\303\0\0\0\0\4\377\377\0";
