maciekish/warthogathome/Arduino/Examples/4wirespi_CMSP/CMSP_Small_font.h

/*
  Fontname: CMSP Small
  Copyright: Created with Fony 1.4.7
  Glyphs: 48/256
  BBX Build Mode: 0
*/
const uint8_t CMSP_Small_font[800] U8G2_FONT_SECTION("CMSP_Small_font") = 
  "\60\0\4\3\4\4\4\5\5\12\17\0\373\12\373\12\373\1<\0\0\3\3 \5\0\250;,\7B\274"
  ":\34\4-\7(\32;<\20.\6\42\274:\20/\23\350\312\272\251\22\223\22\223\22\223\22\223\22\223"
  "\22\23\3\60\27\372\270\272\30\231\210\61r\42B\42B\42bdDF&bd\2\61\14\366\272\272\10"
  "\211\60\322\77\71(\62\24\372\270\272\30\231\210\221\11*\42#\22\24\23Txp`\63\25\372\270\272\30"
  "\231\210\221\11*\42#\25\24$#\23\61\62\1\64\23\372\270\272\61\22\21\22Q$\42DFv\360 "
  "P\17\65\25\372\270:|\20\250\360 \344 TP!\31\231\210\221\11\0\66\26\372\270:U\325\10\212"
  "\11\12\36\204\34\204\210\361L\304\310\4\0\67\16\372\270:<\60\324\231\240\230\240>\2\70\23\372\270\272"
  "\30\231\210q&bd\42\306\63\21#\23\0\71\25\372\270\272\30\231\210\361L\344 \344 P\231\240L"
  "U\21\0:\7b\334:\20\21;\10\202\274:\20\35\4<\16\246\332:)\21\22\21\22\23\22\23\22"
  "=\13h\372:<\220\207\70\70\20>\20\246\334:\10\211\11\211\11\211\10\211\10\11\1\77\23\372\270\272"
  "\30\231\210\221\11*\23\24\23T\17-(\4@\5\0\250;A\17\372\270\272\30\231\210\361\263\203\7c"
  "\234\11B\27\372\270:\34\204\34\204\210qv\60r\20\42\306\263\203\221\203\20\0C\20\372\270\272\30\231"
  "\210\61\324\317\310D\214L\0D\21\372\270:\34\204\34\204\210\361\77;\30\71\10\1E\22\372\270:|"
  "\20\250\303\203\220\203\20A\15\17\16\14F\20\372\270:|\20\250\303\203\220\203\20A=\4G\24\372\270"
  "\272\30\231\210\61\324\344 \344 \214\63\21#\23\0H\15\372\270:\210\361\263\203\7c|&I\10\362"
  "\274:\374@\0J\17\372\270:<\60\324\207d\234\211\30\231\0K\32\372\270:\210q$\42$\242H"
  "D\210\214LDHDH\211\220\210\30\231\0L\14\372\270:\10\352\377\360\340\300\0M\24\372\270:\210"
  "\61\63\71\10\61\21!\21!\21!\343g\2N\24\372\270:\210\61\63\62\42\21!\21!\21!r\306"
  "\63\1O\16\372\270\272\30\231\210\361\77\23\61\62\1P\23\372\270:\34\204\34\204\210\361\354`\344 D"
  "P\17\1Q\24\372\270\272\30\231\210\361'\42$\42DF$\7!\7\1R\31\372\270:\34\204\34\204"
  "\210\361\354`\344 D\221\210\220\22!\21\61\62\1S\23\372\270\272\30\231\210\61Tjd*HF&"
  "bd\2T\14\372\270:<\60\22\324\377\21\0U\15\372\270:\210\361\377L\304\310\4\0V\17\372\270"
  ":\210\361\77\23Q$\42&(\4W\26\372\270:\210\361'\42$\42$\42$\42$\42$:\22\21"
  "\1X\24\372\270:\210\361LD\221\210\230\240\230\210\220\210\62\316\4Y\17\372\270:\210\361LD\221\210"
  "\230\240~\4Z\24\372\270:<\60T&(&\250LPLP\360\340\300\0\0\0\0\4\377\377\0";
