maciekish/warthogathome/(commit log)

2022-08-02 Minor PCB adjustments
    [Master.brd, Master.sch, Slave-Mega.brd, Slave-Mega.sch, Slave-Nano.brd]
2022-08-02 Modified some panels for LED strips
2022-08-03 Added a 5v bus to all PCBs
    [Hub.brd, Hub.sch, Master.brd, Master.sch, Slave-Mega.brd, Slave-Mega.sch, Slave-Nano.brd, Slave-Nano.sch]
2022-08-08 Migrated Master PCB to KiCad
    [43045-0200.stp, 43045-0400.stp, 43045-0800.stp, B2B-XH-2__LF__SN_.stp, B6B-XH-A-LF--SN---3DModel-STEP-418109.STEP, B6B-XH-A_LF__SN_.stl, B6B-XH-A_LF__SN_.stp, B7B-XH-A_LF__SN_.stp]
2022-08-08 Fixed mounting holes Added Mega pin labels
    [Master.kicad_pcb]
2022-08-08 Added a ground pour to top layer
    [Master.kicad_pcb]
2022-08-09 Modified mounting holes to M3
    [Master.kicad_pcb]
2022-08-09 Added Micro Blade fuse holder to each bus Updated cap 3d model Ignored KiCad backups
    [BK-6013.step, Cap MLCC FA14X7R1H225KRU06.stp, Master.kicad_pcb, Master.kicad_sch]
2022-08-11 Fixed 3d model
    [Hub.kicad_pcb, Hub.kicad_sch, Master.kicad_pcb]
2022-08-11 Added power status LEDs to Master PCB
    [Hub.kicad_pcb, Hub.kicad_sch, Master.kicad_pcb, Master.kicad_sch]
2022-08-11 Added power status LED to each bus
    [Master.kicad_pcb, Master.kicad_sch]
2022-08-15 Master PCB Adjustments
    [Master.kicad_pcb]
2022-08-15 Updated Master PCB and completed first version of Hub
    [Hub.kicad_pcb, Hub.kicad_sch, Master Shield.kicad_pcb, Master Shield.kicad_sch, Master.kicad_pcb, Master.kicad_sch]
2022-08-16 Completed first version of Master Shield
    [Master Shield.kicad_pcb, Master Shield.kicad_sch]
2022-08-17 JLCPCB mappings wip
    [Master Shield.kicad_pcb]
2022-08-17 Final Master Shield files
    [ELEC PWR.dxf, Master Shield.kicad_pcb, Master Shield.kicad_sch, bom.csv, designators.csv, positions.csv]
2022-08-17 Fixed J1 silkscreen
    [Master Shield.kicad_pcb]
2022-08-18 Cleaned up libraries
    [43045-0200.stp, 43045-0400.stp, 43045-0800.stp, B2B-XH-2__LF__SN_.stp, B6B-XH-A_LF__SN_.stl, B6B-XH-A_LF__SN_.stp, B7B-XH-A_LF__SN_.stp, BK-6013.step]
2022-08-18 Fixed Master Shield 3D model paths
    [Master Shield.kicad_pcb]
2022-08-18 Updated LCSC number for fuse
    [Master Shield.kicad_sch]
2022-08-18 First version of Hub completed
    [Hub.kicad_pcb, Hub.kicad_sch]
2022-08-18 Added some more silkscreen info to Hub
    [Hub.kicad_pcb, Hub.kicad_sch, bom.csv, designators.csv, positions.csv]
2022-08-18 Updated libraries for Arduino components
2022-08-19 Updated HUB LEDs
    [Hub.kicad_pcb, Hub.kicad_sch]
2022-08-19 Initial Slave Schematic
    [Slave.kicad_pcb, Slave.kicad_sch]
2022-08-19 Annotated Slave
    [Slave.kicad_pcb, Slave.kicad_sch]
2022-08-19 Added LED terminals
    [Slave.kicad_sch]
2022-08-19 Replaced 4P switch with 2x2P switches because of placement
    [Slave.kicad_pcb, Slave.kicad_sch]
2022-08-20 Slave PCB wip
    [Slave.kicad_pcb, Slave.kicad_sch]
2022-08-23 Slave WIP
    [ATX PSU Frame.FCStd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]
2022-08-28 Tweaked Hub
    [Hub.kicad_pcb, Hub.kicad_sch, bom.csv, designators.csv, positions.csv]
2022-08-28 Generated Final Rev 1 files for Hub and Slave
    [Slave.kicad_pcb, Slave.kicad_sch, bom.csv, designators.csv, positions.csv]
2022-08-28 Fixed swapped LEDs on Slave
    [Slave.kicad_pcb, Slave.kicad_sch]
2022-08-28 Updated production files for Slave
    [positions.csv]
2022-08-28 Updated TX/RX resistors to 1.8K
    [Hub.kicad_pcb, Hub.kicad_sch, Slave.kicad_pcb, bom.csv]
2022-08-28 Removed unnecessary resistor
    [Slave.kicad_pcb, Slave.kicad_sch, bom.csv, designators.csv, positions.csv]
2022-08-28 Include headers in BOM
    [Slave.kicad_pcb, Slave.kicad_sch, bom.csv]
2022-08-28 Added Mounting Holes to Slave PCB Added External Connection PCB
    [External Connectors.kicad_pcb, External Connectors.kicad_sch, Slave.kicad_pcb, Slave.kicad_sch, bom.csv, designators.csv, positions.csv]
2022-08-29 Updated External Connectors BOM
    [External Connectors.kicad_pcb, External Connectors.kicad_sch]
2022-08-29 Renamed Slave to Nano Slave
    [Nano Slave.kicad_pcb, Nano Slave.kicad_sch, bom.csv, designators.csv, positions.csv]
2022-08-29 Removed Eagle Libraries and Projects
    [Hub.brd, Hub.sch, Master.brd, Master.sch, Slave-Mega.brd, Slave-Mega.sch, Slave-Nano.brd, Slave-Nano.sch]
2022-08-29 Mega Slave WIP
    [Mega Slave.kicad_pcb, Mega Slave.kicad_sch]
2022-08-31 4wire SPI OLED example
2022-08-31 Updated OLED SPI example to use hardware SPI on Arduino Nano
2022-09-01 Updated SPI example with hardware SPI for Arduino Mega
2022-09-01 Added switch to KiCad library
2022-09-07 Mega Slave Initial Routing
    [Mega Slave.kicad_pcb, Mega Slave.kicad_sch]
2022-09-07 Mega Slave Completed
    [Mega Slave.kicad_pcb]
2022-09-08 Initial version of the Nano Shield
    [Nano Shield.kicad_pcb, Nano Shield.kicad_sch, Nano Shield.sch, arduino-nano-connectors.sch]
2022-09-08 Finished Nano Shield
    [Nano Shield.kicad_pcb, Nano Shield.kicad_sch]
2022-09-11 Nano Slave Rev 2
    [Nano Slave.kicad_pcb, Nano Slave.kicad_sch, bom.csv, designators.csv, positions.csv]
2022-09-11 Mega Shield WIP
    [Mega Shield.kicad_pcb, Mega Shield.kicad_sch]
2022-09-11 Updated some silkscreen
    [Nano Slave.kicad_pcb]
2022-09-11 Added measurements to silkscreen
    [Nano Slave.kicad_pcb, Nano Slave.kicad_sch, bom.csv]
2022-09-11 Fixed PCB size
    [Nano Slave.kicad_pcb]
2022-09-12 Cleaned up routing on Nano Shield
    [Nano Slave.kicad_pcb, bom.csv, designators.csv, positions.csv]
2022-09-19 Rearranged files
    [External Connectors.kicad_pcb, External Connectors.kicad_sch, Hub.kicad_pcb, Hub.kicad_sch, Master Set.kicad_sch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]
2022-09-19 Mega Slave Rev. 2 Completed
    [Mega Slave.kicad_pcb, Mega Slave.kicad_sch, bom.csv, designators.csv, positions.csv]
2022-09-22 Completed panels for right column of right console
    [2022-09-22 - 2.8mm Black.dxf, 2022-09-22 - 2.8mm White.dxf, 2022-09-22 - 2mm White.dxf]
2022-10-01 Completed Caution Panel
    [Caution Panel.kicad_pcb, Caution Panel.kicad_sch, Mega Slave.kicad_pcb, bom.csv, designators.csv, positions.csv]
2022-10-04 UFC WIP
    [UFC.kicad_sch]
2022-10-10 Added Laser Calibration Files
2022-10-10 UFC Completed
    [UFC.kicad_sch, bom.csv, designators.csv, positions.csv]
2022-10-12 Updated PCB production files
    [bom.csv, designators.csv, positions.csv]
2022-10-13 Fixed part number of screw terminals
    [Mega Slave.kicad_pcb, Mega Slave.kicad_sch, bom.csv]
2022-11-03 Nano SFF Slave
    [Nano SFF Slave.kicad_pcb, Nano SFF Slave.kicad_sch, bom.csv, designators.csv, positions.csv]
2022-11-07 Cleaned up PCB
    [Nano SFF Slave.kicad_pcb, Nano SFF Slave.kicad_sch]
2022-11-07 Mega SFF Slave WIP
    [Mega SFF Slave.kicad_pcb, Mega SFF Slave.kicad_sch, bom.csv, designators.csv, freerouting.dsn, positions.csv, temp-freerouting.dsn]
2022-11-11 Mega SFF WIP
    [Mega SFF Slave.kicad_pcb, freerouting.dsn, temp-freerouting.dsn]
2022-11-12 Mega SFF Slave Rev. 1
    [Mega SFF Slave.kicad_pcb, bom.csv, designators.csv, positions.csv]
2022-11-12 Nano SFF Rev. 1
    [Nano SFF Slave.kicad_pcb, bom.csv, designators.csv, positions.csv]
2022-12-01 Updated production files
    [Mega SFF Slave.kicad_pcb]
2022-12-01 3D Models & Oxygen Regulator code WIP
2022-12-01 Fixed terminal part number
    [bom.csv]
2022-12-01 Fixed silkscreen
    [Mega SFF Slave.kicad_pcb]
2022-12-04 Updated Nano SFF Slave RS485 Switch and Silkscreen
    [Nano SFF Slave.kicad_pcb, Nano SFF Slave.kicad_sch, bom.csv]
2022-12-04 Updated Mega SFF Slave RS485 Switch and Silkscreen
    [Mega SFF Slave.kicad_pcb, Mega SFF Slave.kicad_sch, positions.csv]
2022-12-04 Improved Nano SFF Silkscreen
    [Nano SFF Slave.kicad_pcb]
2022-12-05 Added fuse models
2022-12-05 Micro SFF Slave WIP
    [Micro SFF Slave.kicad_pcb, Micro SFF Slave.kicad_sch]
2022-12-09 Nano SFF with DS4560S-AR+ hotplug protection (Not Orderable)
    [Nano SFF Slave.kicad_pcb, Nano SFF Slave.kicad_sch, bom.csv, designators.csv, positions.csv]
2022-12-09 Added a drain resistor and updated component values
2022-12-09 Added new components
    [Nano SFF Slave.kicad_sch]
2022-12-15 Nano SFF With Hotplug and RS485 Protection
    [Nano SFF Slave.kicad_pcb, Nano SFF Slave.kicad_sch, bom.csv, designators.csv, positions.csv]
2022-12-15 Added Hotplug and RS485 protection to Mega SFF Schematic. PCB to go
    [Mega SFF Slave.kicad_sch]
2022-12-15 Fixed silkscreen on Nano SFF
    [Nano SFF Slave.kicad_pcb, bom.csv, designators.csv, positions.csv]
2022-12-15 Added Hotplug and RS485 protection to Mega SFF. Capacitor LCSC numbers to go.
    [Mega SFF Slave.kicad_pcb, bom.csv, designators.csv, positions.csv]
2022-12-15 Updated LCSC number and size of voltage ramp capacitors for Nano SFF Slave
    [Nano SFF Slave.kicad_pcb, Nano SFF Slave.kicad_sch, bom.csv, designators.csv, positions.csv]
2022-12-15 Updated LCSC number and size of voltage ramp capacitors for Mega SFF Slave
    [Mega SFF Slave.kicad_pcb, Mega SFF Slave.kicad_sch, bom.csv, designators.csv, positions.csv]
2022-12-16 Added Caution Panel and panelized 3 panels for production
    [2022-09-22 - 2.8mm Black.dxf, 2022-09-22 - 2.8mm White.dxf, 2022-09-22 - 2mm White.dxf]
2022-12-19 Oxygen Regulator Sketch
2022-12-26 Updated micro-fit pinout for more power
    [Hub.kicad_pcb, Hub.kicad_sch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]
2022-12-26 Updated hub pinout for more power
    [External Connectors.kicad_pcb, External Connectors.kicad_sch, bom.csv, designators.csv, positions.csv]
2022-12-29 Updated Nano SFF Slave for correct block terminal size
    [Nano SFF Slave.kicad_pcb, bom.csv, designators.csv, positions.csv]
2022-12-29 Regenerated production files
    [Nano SFF Slave.kicad_pcb]
2022-12-29 Updated Mega SFF Slave for correct terminal block size
    [Mega SFF Slave.kicad_pcb, bom.csv, designators.csv, positions.csv]
2022-12-29 Updated Nano SFF Revision and date information
    [Nano SFF Slave.kicad_pcb, bom.csv, designators.csv, positions.csv]
2022-12-31 Master WIP
    [Master Set.kicad_sch, Master.dsn, Master.kicad_pcb, Master.kicad_sch, RS485.kicad_sch]
2023-01-01 Added 1 pos dip switch
2023-01-02 Master Rev. 1
    [Master.kicad_pcb, Master.kicad_sch, RS485.kicad_sch, bom.csv, designators.csv, positions.csv]
2023-01-02 Updated Master Silkscreen
    [Master.kicad_pcb]
2023-01-02 Tweaked Groundplane Size
    [Master.kicad_pcb]
2023-01-03 Updated Master to use PCIe Power Directly
    [Master.kicad_pcb, Master.kicad_sch, RS485.kicad_sch, bom.csv, designators.csv, positions.csv]
2023-01-03 Added Spring Terminals
2023-01-09 Updated HUB
    [Hub.kicad_pcb, Hub.kicad_sch, Master.kicad_pcb, RS485.kicad_sch, bom.csv, designators.csv, positions.csv]
2023-01-09 Removed voltage ramp and some protection from Nano SFF Slave
    [Nano SFF Slave.kicad_pcb, Nano SFF Slave.kicad_sch, bom.csv, designators.csv, positions.csv]
2023-01-09 Updated Nano SFF Slave
    [Nano SFF Slave.kicad_pcb, Nano SFF Slave.kicad_sch, bom.csv, designators.csv, positions.csv]
2023-01-11 Arduino Code for Lighting Panel
